spenceraxani/CosmicWatch-Desktop-Muon-Detector-v2/Pictures/Bottom view.jpg

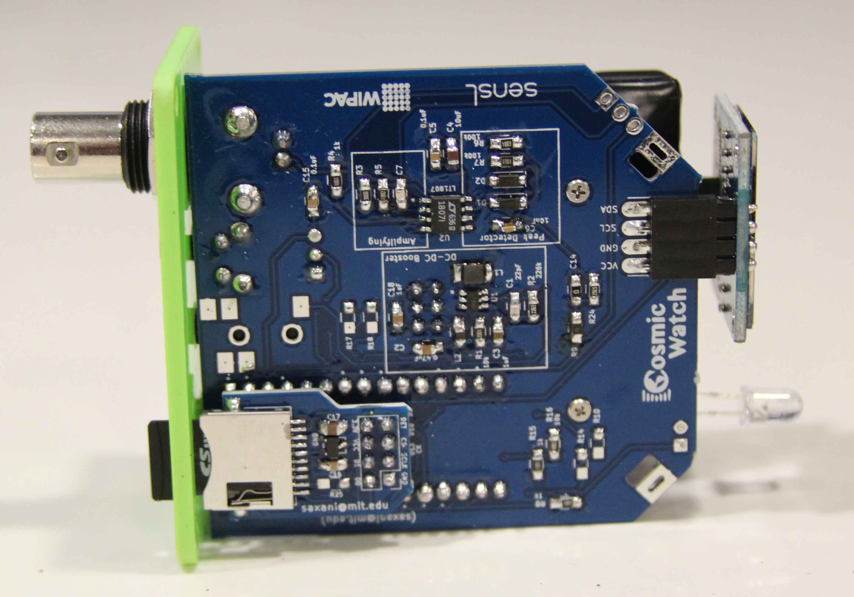
Pictures/Bottom view.jpg
