spenceraxani/CosmicWatch-Desktop-Muon-Detector-v2/Pictures/Detector.png

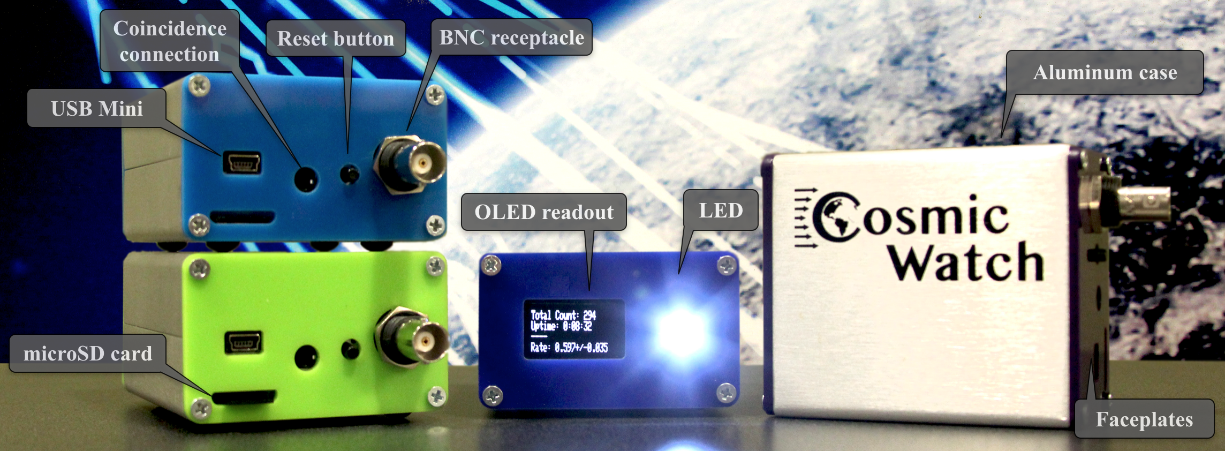
Pictures/Detector.png
