spenceraxani/CosmicWatch-Desktop-Muon-Detector-v2/README.md

-- OUTDATED --

CosmicWatch v2 is depracated and no longer supported. Please use v3X, the updated detector, found here:

[https://github.com/spenceraxani/CosmicWatch-Desktop-Muon-Detector-v3X]

Here are the previous v2 links:

Website: http://www.cosmicwatch.lns.mit.edu/

YouTube tutorial: https://www.youtube.com/watch?v=e4IXzNiNxgU

Paper: https://arxiv.org/abs/1801.03029

-- OUTDATED --
