spenceraxani/CosmicWatch-Desktop-Muon-Detector-v2/CAD/SiPM pins.png

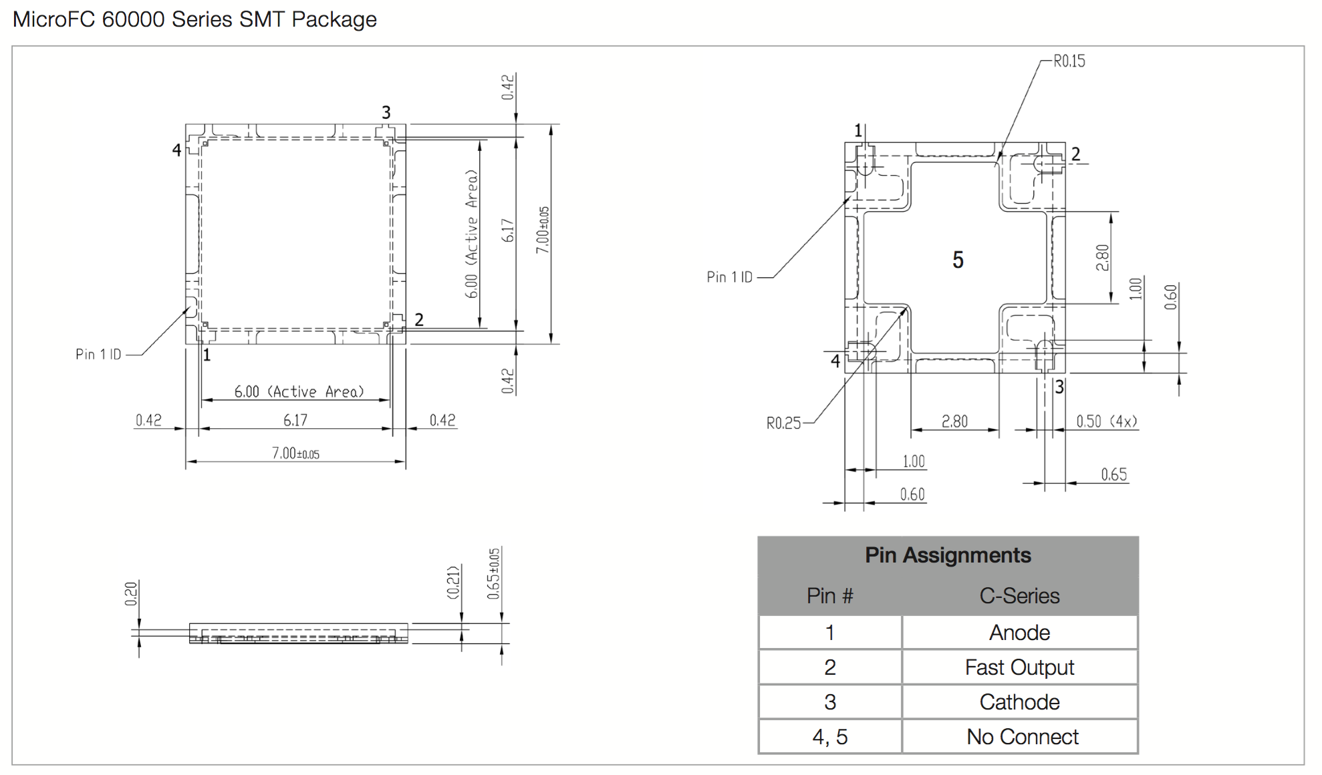
CAD/SiPM pins.png
