spenceraxani/CosmicWatch-Desktop-Muon-Detector-v2/Pictures/Front view.jpg

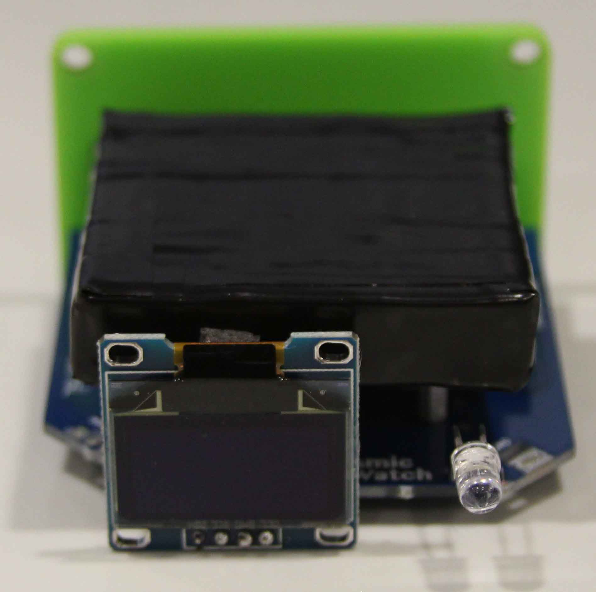
Pictures/Front view.jpg
