spenceraxani/CosmicWatch-Desktop-Muon-Detector-v2/Pictures/PCB Bottom.png

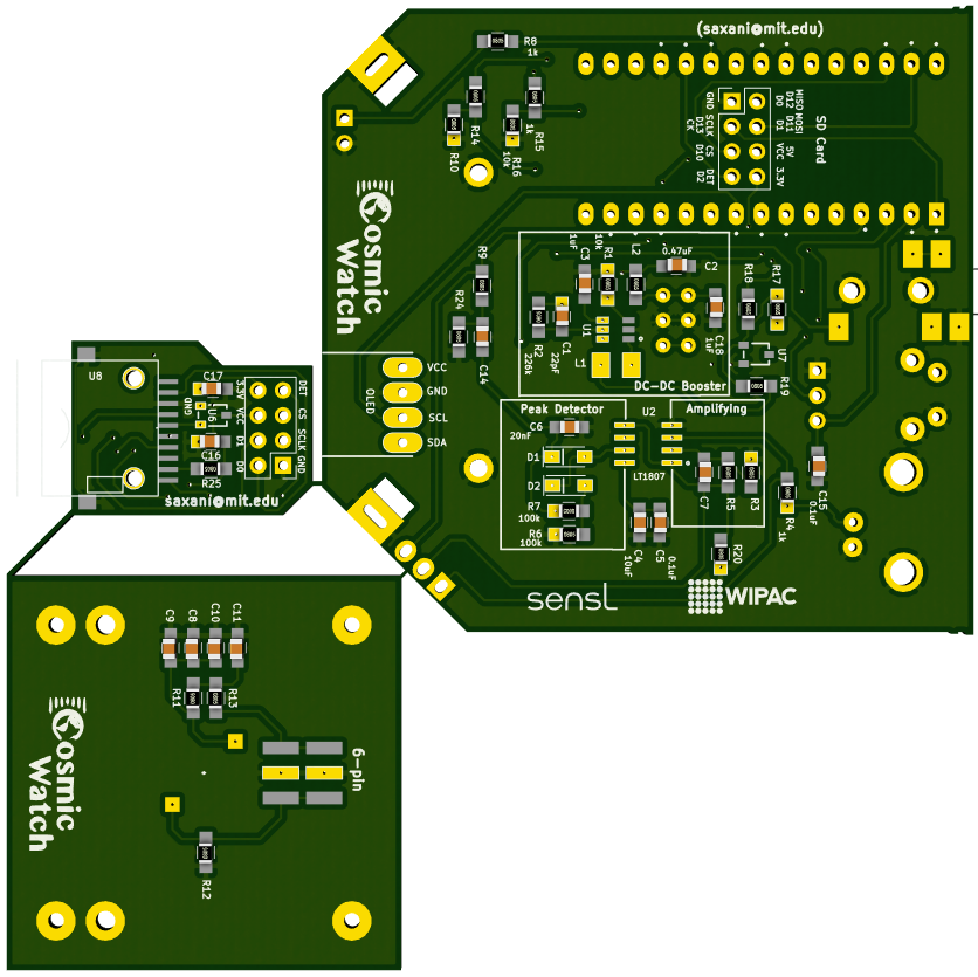
Pictures/PCB Bottom.png
