spenceraxani/CosmicWatch-Desktop-Muon-Detector-v2/Pictures/PCB Top.png

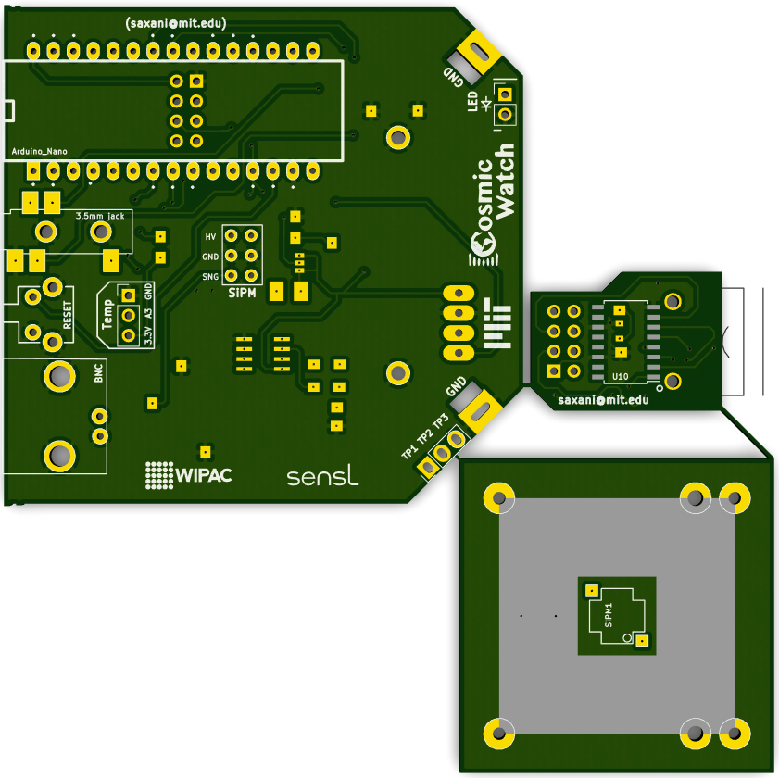
Pictures/PCB Top.png
