spenceraxani/CosmicWatch-Desktop-Muon-Detector-v2/Pictures/Side view.jpg

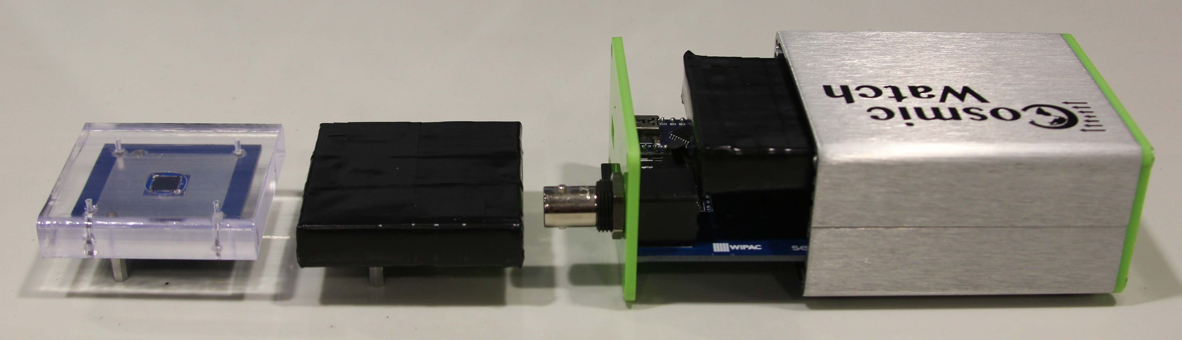
Pictures/Side view.jpg
