spenceraxani/CosmicWatch-Desktop-Muon-Detector-v2/Purchasing_List.xlsx

Note 1: The color defines the seller of the component. Components are rather generic, therefore you should be able to use your favorite distributor.
Note 2: We try and include a link in the form of the part number for each website
Note 3: We purhace our components in bulk (as required by several of the components). The price/unit was determined by purchasing 100 of each component. If you purchase a single unit, the price is probably ~200USD.
Note 4: The case is optional. It is cosmetic but helps protect the detector.
Note 5: We do not include shipping or taxes in our costs analysis.
Note 6: We've added one extra component to the required number of Resistors and Capacitors.
Note7: Ebay is often cheap than amazon. But the products change names regularly, so I won't include links to Ebay.
Note 8: Half of the OLED screens out there have VCC and GND reversed. We want an OLED screen with the VCC pin as the left most pin, not the second left-most pin.
Detector Purchasing List
Item | Name | Required number | Price/Unit * number | Discription | Link | Old link
1 | 0 Ohm resistor | 5 | $0.04 | RES SMD 0 OHM JUMPER 1/8W 0805 | Digikey Part Number: 311-0.0ARCT-ND
2 | 49.9 Ohm resistor | 4 | $0.04 | RES SMD 49.9 OHM 1% 1/8W 0805 | Digikey Part Number: 311-49.9CRCT-ND
3 | 249 Ohm resistor | 2 | $0.02 | RES SMD 249 OHM 1% 1/4W 0805 | Digikey Part Number: 311-249CRCT-ND
4 | 1K resistor | 4 | $0.04 | RES SMD 1K OHM 1% 1/8W 0805 | Digikey Part Number: 311-1.00KCRCT-ND
5 | 10k resistor | 5 | $0.04 | RES SMD 10K OHM 1% 1/8W 0805 | Digikey Part Number: RMCF0805FT10K0 | Digikey Part Number: 311-10.0KCRCT-ND
6 | 24.9k resistor | 2 | $0.02 | RES SMD 24.9K OHM 1% 1/8W 0805 | Digikey Part Number: RMCF0805FT24K9CT-ND
7 | 100k resistor | 3 | $0.03 | RES SMD 100K OHM 1% 1/8W 0805 | Digikey Part Number: RMCF0805JT100KTR-ND | Digikey Part Number: 311-100KCRCT-ND
8 | 226k resistor | 2 | $0.02 | RES SMD 226K OHM 1% 1/8W 0805 | Digikey Part Number: 311-226KCRCT-ND
9 | 10pF capacitor | 2 | $0.05 | CAP CER 10PF 50V C0G/NP0 0805 | Digikey Part Number: CML0805C0G100JT50V | Digikey Part Number: 1276-1109-1-ND
10 | 22pF capacitor | 2 | $0.05 | CAP CER 22PF 50V NP0 0805 | Digikey Part Number: 399-1113-1-ND
11 | 0.47uF capacitor | 2 | $0.22 | CAP CER 0.47UF 50V X7R 0805 | Digikey Part Number: 399-8100-1-ND
12 | 20 nF capacitor | 6 | $0.09 | CAP CER 20nF 50V X7R 0805 | Digikey Part Number: 478-10429-6-ND
13 | 0.1uF capacitor | 4 | $0.10 | CAP CER 0.1UF 50V X7R 0805 | Digikey Part Number: 1276-1007-2-ND | Digikey Part Number: 399-1170-1-ND
14 | 1uF capacitor | 3 | $0.11 | CAP CER 1UF 50V X7R 0805 | Digikey Part Number: 1276-6495-6-ND | Digikey Part Number: 1276-6470-1-ND
15 | 10nF capacitor | 4 | $0.03 | CAP CER 10000PF 100V X7R 0805 | Digikey Part Number: 1276-1249-1-ND
16 | 10uF capacitor | 3 | $0.12 | CAP CER 10UF 16V X5R 0805 | Digikey Part Number: 1276-1096-1-ND
17 | Feritte bead | 2 | $0.11 | FERRITE BEAD 2.5 KOHM 0805 1LN | Digikey Part Number: 535-ACML-0805-102-TTR-ND | Digikey Part Number: 587-1919-1-ND
18 | 47uH inductor | 1 | $0.22 | FIXED IND 47UH 170MA 1.3 OHM SMD | Digikey Part Number: 490-4063-1-ND
19 | Schottky diode | 2 | $0.33 | DIODE SCHOTTKY 40V 500MA SOD123 | Digikey Part Number: 641-1327-2-ND | Digikey Part Number: MBR0540CT-ND
20 | 4 pin header for OLED | 1 | $0.40 | CONN FEMALE 4POS .100" R/A TIN | Digikey part number: S5440-ND
21 | 6-pin connector | 1 | $0.41 | 6-pin connector for SiPM PCB | Digikey Part Number: WM17457-ND | Digikey Part Number: WM17457-ND
22 | 6pin header | 1 | $0.45 | 6-pin header for Main PCB | Digikey Part Number: 1212-1229-ND
23 | Reset button | 1 | $0.19 | SWITCH TACTILE SPST-NO 0.02A 15V | Digikey part number: PTS645VH83-2 LFS | Digikey part number: P12215S-ND
24 | 3.5mm coincidence jack | 1 | $0.89 | 3.5mm audio, 4 conductor connection jack | Digikey Part Number: CP-43515RSSJCT-ND
25 | BNC header + Nut | 1 | $1.67 | CONN BNC JACK R/A 50 OHM PCB | Digikey part number: WM5514-ND | Digikey part number: A97555-ND (old version WM5514-ND)
26 | 3.3 V regulator | 1 | $0.20 | IC REG LINEAR 3.3V 300MA SOT23-3 | Digikey part number: AP2138N-3.3TRG1DITR-ND | Digikey part number: AP2210N-3.3TRG1DICT-ND
27 | Standoff for SiPM PCB | 2 | $0.66 | 1/8" Hex Size, 7/16"" Length, 0-80 Thread Size | McMasterCarr part number: 91780A029
28 | Standoff threaded screws 0-80 | 4 | $0.36 | 0-80 Thread Size, 1/4" Long | McMasterCarr part number: 91771A055
29 | Plastic scintillator screws | 4 | $0.28 | 18-8 Stainless Steel, Number 0 Size, 5/16" Long | McMasterCarr part number: 92470A024
30 | LT-3461 DC-DC Booster | 1 | $2.00 | LT3461ES6#TRPBF | https://www.analog.com/en/products/lt3461a.html#product-samplebuy | Samples are free, or check digikey
31 | LT 1807 Op-Amp | 1 | $3.75 | LT1807IS8#PBF | https://www.analog.com/en/products/lt1807.html#product-samplebuy | Samples are free, or check digikey
32 | Non-Inverting Buffer | 1 | $0.25 | High Speed CMOS Logic Hex Non-Inverting Buffers | Digikey part Number: 296-9214-5-ND | Mouser Part Number: 595-CD74HC4050M96
33 | 5mm LED | 1 | $0.11 | 5mm LED, white looks best | https://www.amazon.com/Bluecell-White-Electronics-Ultra-Bright/dp/B005ONQ41W?s=hi
34 | Arduino Nano | 1 | $2.25 | ATmega328 CH340G | Check Ebay or Amazon (example https://www.amazon.com/ELEGOO-Arduino-ATmega328P-Without-Compatible/dp/B0713XK923
35 | Temperature sensor | 1 | $0.83 | TMP36 analog sensor | Check Ebay or Amazon (example: https://www.amazon.com/KOOKYE-Temperature-TMP36-Precision-Raspberry/dp/B01GH32AQU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 )
36 | microSD card socket | 1 | $0.39 | SMT SMD Cell Phone TF Micro SD Memory Card Slot Holder Sockets | https://www.amazon.com/uxcell-Phone-Memory-Holder-Sockets/dp/B01AHYS7K8
37 | OLED screen | 1 | $2.66 | 0.96" Inch I2c IIC OLED , 128x64 | Check Ebay or Amazon (example: https://www.amazon.com/Dorhea-Display-SSD1306-Self-Luminous-Raspberry/dp/B07FK8GB8T NOTE: VCC NEEDS TO BE THE 4th PIN ON THE OLED (on the left side), the left most pin is GND on half of the screens out there. SOME MANUFACTURERS SWAP THE PINS.
38 | SiPM | 1 | $29.00 | 6x6mm SiPM MicroFC-60035-SMT | Mouser part Number: 863-MFC60035SMTTR | Mouser part Number: 863-MFC60035SMTTR1
39 | Plastic scintillator | 1 | $30.00 | 5x5x1 cm Plastic scintillator | Ebay, or find your own. You want 5x5x1 cm3 and a peak emission at 420nm. (https://www.ebay.com/itm/Bicron-BC408-Plastic-Scintillator-5x5x1-cm-for-CosmicWatch-Muon-Detector-Project/263355405917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
40 | Main PCB + SiPM PCB | 1 | $0.95 | 2 layer, 10cm x 10cm, 1.6mm thickness | https://www.elecrow.com/pcb-manufacturing.html (https://www.elecrow.com/10pcs-2-layer-pcb.html)
 |  | Total: | $79.32
Enclosure Purchasing List
Item | Name | Required number | Price/Unit * number | Discription | Link
1 | Rubber feet | 4 | $0.05 | Silicon bumper for feet, 8x2 mm | https://www.ebay.com/itm/200PC-Self-Adhesive-Silicone-Feet-Bumpers-Stop-Clear-Cabinet-Door-Buffer-Pads-US/153282008606 (https://www.ebay.com/itm/200Pcs-Black-Silicone-Self-Adhesive-Rubber-Feet-Semicircle-Bumpers-Buffer-Pad)
2 | Aluminum Case | 1 | $9.28 | Aluminium case: 2506-2.9 | http://www.enclosuresandcasesinc.com/
3 | Front and back plate | 1 | $0.91 | 10cm x 15cm x 2.5mm acrylic end plates. | https://www.elecrow.com/acrylic-cutting.html
4 | 5mm LED holder | 1 | $0.15 | LED Light Mounting Holders | https://www.amazon.com/uxcell-Plastic-Holder-Light-emitting-Lighting/dp/B00K859CGK?s=hi
 |  | Total: | $10.38
Other potential purchases
Item | Name | Required number |  | Discription | Link
1 | Tin Foil or aluminum foil | 1 | $0.04 | 10x10cm of Aluminium foil for wrapping the Plastic scintilaltor | https://www.amazon.com/Reynolds-Wrap-Aluminum-Foil-Square/dp/B00UNT0Y2M
2 | Optical Gel | <1ml | $0.89 | Small amount of optical gel. Vaciline might work. | Check Ebay or Amazon (example: https://www.ebay.com/itm/Silicone-Optical-Coupling-Compound-for-PMT-Photomultiplier-Scintillator-Detector-/261918290249)
3 | Black electrical tap | ~1m | $0.22 | Black electrical tape for making the Plastic scintillator light-tight | https://www.amazon.com/Electrical-Tape-several-colors-Black/dp/B003ZWN5ZM
4 | microSD Card | 1 | $3.00 | We recommend 128Mb and above. | https://www.amazon.com/Lerdisk-Micro-SD-Card-4GB/dp/B09J9WTCG9
5 | Coincidence Cable | 1 | $4.00 | Short 3.5mm male to male audio cable. Either 3 or 4 conductor. | https://www.amazon.com/Riipoo-3-5mm-AUX-Audio-Cable/dp/B07429HJRJ?s=industrial | https://www.amazon.com/Seadream-4-Pole-Stereo-Headset-Extension/dp/B017PT8XX4
6 | BNC Cable | 1 | $5.96 | 3 feet BNC cable for testing. | https://www.amazon.com/Hosa-BNC-59-103-75-Ohm-Coax-Cable/dp/B000068OFB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
 |  | Total: | $14.12
 |  | Total: | $103.83
