spenceraxani/CosmicWatch-Desktop-Muon-Detector-v2/(threads)

Thread 1 (2018-01-28):

DC-DC Booster: LT3461 or LT3461A?

arrowM, 2018-01-28:
Hello,

I'm trying to determine which DC-DC booster to use from here: http://www.linear.com/samples/LT3461A

The purchasing list says to use the LT3461, but the instructions PDF says to use the LT3461A. These are two separate models with one slight difference: the LT3461 switches at 1.3 MHz while the LT3461A switches at 3 MHz.

Is there a specific one I should pick over the other, or would either work fine?

Thanks!

spenceraxani, 2018-01-28:
Hi,

I’ve used both in the past ad haven’t noticed a difference. On all my current builds though, I just stick to the 3MHz version, LT3461A.

Thanks,

Spencer

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

Thread 4 (2018-03-27):

BOM vs Populating reference and Partslist

metapulp, 2018-03-27:
Hi, I'm ordering from Elecrow and I have these issues:

1: The spreadsheet with part quantities does not match the quantities on the populating list. So basically from the quantity list they think they have more soldering to do than the populating list and pictures of the board show.
2: Elecrow is asking for a partlist generated from Autodesk Eagle - which I don't know how to do with the Gerber files. Do you have a DXF? Can you generate that partlist? Thank you.

spenceraxani, 2018-03-28:
Hi,

I’ve added an extra unit to the quantity in the purchasing list, since I noticed some people were just buying single resistors and then losing them.

The list to populate the boards is found in folder PCB_Files/SMT_reference. However, I do not have the BOM list for them to populate the boards. We use this project to teach students how to solder surface mount components.

The Gerber files (located here: PCB_Files/PCB_Gerber_files) contain the information required for Elecrow to simply make the PCB, not populate it.

Thanks,

Spencer

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

metapulp, 2018-03-28:
I understand. I’m also hiring Elecrow to populate most of the basic parts. Any chance you have the board(s) as a DXF and you could post it on github so I can generate the partlist file they are requesting? I’m not having any luck importing the Gerber in Eagle. Thanks!

metapulp, 2018-03-29:
Let me amend my comment. I'm trying to import files into Eagle with no luck, so I'm not seeing how to generate the partlist for Elecrow...

They are looking for something like this:
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

spenceraxani, 2018-03-29:
Hi,

I hope to generate the list at some point, but am unable to work on this at this time. I would recommend populating the components by hand for the moment being.

Thanks,

Spencer

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

Thread 5 (2018-04-30):

Missing marker on ARef pin

K-Raymond, 2018-04-30:
Hi Spencer,

I've just finished building two detectors and I noticed that there was no white-dot (which I assumed is to signify a used connection of that pin) on the ARef pin. This makes soldering the pins of the nano to the mainboard a little ambiguous and can result on a floating reference voltage. In my case, I had to debug why I was always measuring 1023 ADC units on A0.

I also wanted to say, thanks for making a fun little project!

-- Kurtis

spenceraxani, 2018-04-30:
Hi Kurtis,

You can solder all the pins on the Arduino to the board, but thanks for catching the missing dot. The dots were used to specify which pins I was using, but as the board developed, I stopped using them and must have missed this one.

Thanks,

Spencer

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

Thread 6 (2018-05-16):

HV to ground voltage measuring 33.6 volts. Recheck components in DC booster circuit. Is that acceptable since it exceeds the nominal 29.5 volts?

pedelen, 2018-05-16:

pedelen, 2018-05-16:
That was a great help. Loose connection on 226K resistor, now exactly 29.6 V output

pedelen, 2018-05-24:
Connected SiPM to 29.64  volts, but no counts. Arduino nano code rechecked. Don't have an oscilloscope to check test points. Checked SiPM resistance and is 10.5 megohms in one direction and infinite in the other. Should there  be a high count due to ambient photons? So if 0 count, maybe I should suspect the amplifier circuit?

spenceraxani, 2018-05-24:
Hi,

The most common problem I see is a missed or poor connection — particularly on the op-amp (90% of the time, it’s the opamp). I would start by adding new solder to those legs just to make sure. If you are able to upload code to the Arduino, I assume it’s probably working fine. You can also go through the other components on the board. I’ve also seen people mount the SiPM rotated (pin1 and 3 interchanged). If all this still doesn’t work, you’ll have to find an oscilloscope to nail down what part of the circuit is giving you problems.

You probably shouldn’t expose the SiPM to ambient light, but if you do, you still won’t see any counts. I think SiPMs have their own peculiar behavior with large amounts of light, but the circuit is designed to only be able to count below 1000Hz. We stretch to pulses to roughly one millisecond, and the Arduino will wait for a pulse to subside before looking for the next pulse.

Thanks,

Spencer

> On May 23, 2018, at 7:15 PM, pedelen <notifications@github.com> wrote:
>
>

pedelen, 2018-06-09:
Trying to track down problem. Each reset results in a count of 1 and then timer keeps going but no additional counts. Tried reloading sketch multiple times. Tried replacing SiPM and repopulating main PCB.

mmalluck, 2018-07-02:
Hello Pedelen,

Did you get your issue sorted? I have something similar happening with both of my V1 boards. 1 count and then nothing. If I leave them plugged in for a while, eventually they start counting. I found raising the "RESET_THRESHOLD" in the software to about 15 gets it counting immediately or just letting it warm-up for a 10 minutes and then resetting it.

My guess is there's some noise coupling into the circuit that settles out once everything warms up. USB power source doesn't seem to make a difference. If I can get some time in-front of an o'scope, I'll see if I can find the source.

pedelen, 2018-07-02:
Hello mmalluck,
Thank you for your help Spencer. Two v1 boards now working perfectly with original threshold settings. I am not sure what did the trick. I installed the standoffs, rewrapped the scintillator and used better optical coupling compound. Do the standoffs have any electrical function? The counts are now much closer to expected with better optical coupling (Rate ~ .55 cps).

mmalluck, 2018-07-02:
Do you mind me asking what you're using for optical coupling gel then vs now?

I'm currently using some silicone based '[scintilator coupling compound'](https://m.ebay.com/itm/Silicone-Optical-Coupling-Compound-for-PMT-Photomultiplier-Scintillator-Detector-/261918290249&ved=2ahUKEwiCkfCuh4HcAhUQvVkKHSSuCccQFjAAegQIBB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)off ebay and I'm wondering if it's contributing to this.

I'm looking at using some fiber optic gel instead.

spenceraxani, 2018-07-02:
Another potential source that could cause this problem is if you have a light leak. I typically wrap it in reflective foil, then put about 3 full layers of black electrical tape to make sure it’s isolated.

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

pedelen, 2018-07-02:
Hello mmalluck,
That is the exact same optical coupling compound that I am using now with good results. It appears that my issue was due to a light leak and it seems to be resolved now. I now realize I have been posting on the v2 thread about my issue with v1 boards.

Closed 2018-07-02.

Thread 7 (2018-06-09):

SiPM blue sensitive vs red sensitive

metapulp, 2018-06-09:
Hi, Spencer, what is the reason for selecting a blue-sensitive SiPM instead of a red-sensitive SiPM? (What nm range is the flash in the scintillator?) Thanks!

spenceraxani, 2018-06-09:
Hi,

The scintillator that we are using peaks at about 420nm, which is fairly close to the SiPM peak detection efficiency (around 450-550nm). Red-sensitive SiPMs are a slightly different technology that have a lower overall efficiency and are more suited for other applications, like measuring luminescence. SensL recently developed a new red-sensitive SiPM if you are interested: https://sensl.com/products/r-series/ <https://sensl.com/products/r-series/>. You can also see that the cost per square mm is also much higher than the SensL C-Series that we use.

Thanks,

Spencer

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

Thread 8 (2018-06-17):

Can't find Cap C6 - 20nF 50V

rogerio-acioli, 2018-06-17:
Hi,

I'm having problems to find the C6 capacitor (20nF - 50V) to buy at my country. Could I have some problem in the funcionallity of the detector if I use a 22nF capacitor instead the nominal 20nF?
Thanks!

spenceraxani, 2018-06-17:
Hi,

Sometimes capacitors are labelled in pF (20,000 pF) rather than nF which could be why you are having trouble finding the correct value. If you need to use the 22nF capacitor, I don’t anticipate you running into a problem. That capacitor determines the charge and decay rate of the peak detector pulse. If you swap it for 22nF, it will charge a bit slower and decay over a slightly longer time. This means that the calculated SiPM pulse amplitude will also slightly change (probably at the 10% level).

Thanks,

Spencer

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

samr28, 2018-06-17:
I also had a few problems with some of the parts being out of stock. The filter features on Digikey are super helpful. I was able to find replacements for all of the ones that were either out of stock or no longer in production by just entering the values into the filter. So for that one, I ended up purchasing 478-10429-1-ND.

From what I understand, the main things that you need to look at is the capacitance (20 nF), the size (0805 and overall dimensions should be similar to original). You should be able to go with a higher voltage without any problem as that value is just the voltage that should not be exceeded.

Hope this helps!

rogerio-acioli, 2018-06-19:
Thansk for the answers, guys!
Fortunatelly I finally found the capacitor here, but the informations that you sent are very important though.

Thanks,
Rogério.

Thread 9 (2018-06-19):

Stand-offs Too Short / Screws too long

mmalluck, 2018-06-19:
The Part List specifies 3/8" stand-offs for SiPM PCB. The interfacing screws are 1/4" in length. Using two of these screws results in a clash as both screws come in contact inside the stand-off.  The SiPM also droops. This can be corrected by using a slightly longer standoff.

spenceraxani, 2018-06-21:
Hi,

Thanks for the catch. I was using the 3/8” standoffs prior to this without trouble since there is also two 1.6mm PCBs in-between the standoffs and the 1/4” screws as well as the fact that they are tapered. Never-the-less a 7/16” standoff keeps the scintillator a bit more level and fits nicely so I’ve updated the GitHub purchasing list.

What do you mean by the ’SiPM droops’. Do you mean you are looking at the signal coupling? Droop is a rather small effect at the low intensity signals that we are looking at, but there is footprints on the PCB for AC coupling if you are concerned with the signal droop.

Thanks,

Spencer

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

spenceraxani, 2018-06-21:
Hi,

I see what you mean. There are spacers that you can purchase from McMaster if you want to make it more level — or going to 7/16” brings it really close.

The SiPM assembly is fully compatible with the newer version of the detector.

Thanks,

Spencer

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

Thread 10 (2018-06-27):

Flash too limited to allow OLED & SDCard

mmalluck, 2018-06-27:
It's possible to free up and additional 1.5k Flash by loading the latest Uno Bootloader onto the Nano. This may provide enough space to allow both the OLED and SDCard to operate together.

Reference: https://arduino.stackexchange.com/questions/51866/arduino-nano-atmega328p-bootloader-difference

With an update to the Nano bootloader, the good folks at Arduino neglected to reduce bootloader partition from 2Kb to 500b, as was done for the Uno. Loading the Uno bootloader onto the Nano provides this benefit. You just have to remember to identify the board as an Uno in the IDE.

If you have a sketch with both the OLED and SDCard functions active, you could see if it properly compiles for the Uno. If so, it would work for the modified Nano.

spenceraxani, 2018-06-27:
Hi,

That’s really neat, I’ll have to look into it.

My guess is that it frees up the space on the EEPROM, which won’t be particularly useful to us. We probably require about 10 kB of extra flash storage and about 1 kB of SRAM in order to run both the OLED screen and the SD card at the same time.

We actually only use the EEPROM to store the name of the detector.

Thanks,

Spencer

> On Jun 27, 2018, at 11:52 AM, mmalluck <notifications@github.com> wrote:
>
> u just have to

mmalluck, 2018-06-27:
Hello Spencer,

The 1.5k is indeed flash (not eeprom) space. I found another reference that
provides a how-to on uploading the Uno bootloader to the Nano, just to take
advantage of the extra program space.

http://www.buildlog.net/blog/2017/09/getting-more-program-space-on-an-arduino-nano/

As far as what's needed to run a combined OLED & SD implementation, a quick
mashup of the two sketches weighs in around 35k.... which is 3k more than
the modified nano or Uno could give us. And the ram is 116bytes over. Drat.

For fun I may try to see if this can be optimized.

Thanks,

Michael Malluck

On Wed, Jun 27, 2018, 2:21 PM Spencer N. Axani <notifications@github.com>
wrote:

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

spenceraxani, 2018-06-27:
There’s strange behavior with the Arduinos that don’t actually allow you to go above ~70% of either the maximum of the SDRAM or the Flash.

I bet there’s ways to optimize either the OLED library or the SD Library to make them work. I’ve tried my best to optimize the Arduino code, but I’m sure there’s always places for improvement.

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

mmalluck, 2018-06-29:
Hello,

That's funny. I was playing with the SSD1306 library this afternoon too.
While it does save a bunch of ram and considerable flash, the execution
time is pretty poor.

I just have the V1 hardware at the moment so working with older sketch,
baselining the 'downtime' with adafruit_SSD1306 library comes in around 3%
of the total execution cycle. The SSD1306ascii comes around 12%.

So the ascii library takes 4 times longer to execute than the adafruit. I
guess there's no such thing as a free lunch; You can be space efficent or
execution efficient. Is this acceptable? I guess that depends on what you
want.

I might start looking at the u8g2 libraries next.

Regards,
Michael

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

jgOhYeah, 2018-06-29:
I just checked one of the files logged to the sd card and the dead time is around 43% of the total time after 25 hours running. Might have to speed it up slightly somehow. I am investigating other libraries which may be a compromise between the two.
This might be one of the reasons why the detector I built does not always seem to be behaving properly :)

mmalluck, 2018-06-29:
Considering you can pack all the code into a single sketch, you could take some unused I/O pins and a switch and let the operator decide what he wants to run in software; Serial / OLED & Serial / SD & Serial / OLED & SD & Serial. This way you don't need to upload three different sets of code and the user can determine what kind of performance vs features he wants.

jgOhYeah, 2018-07-07:
I have swapped to the u8x8 library for driving the display, which is a part of the u8g2 library and is text only. It seems to be fairly fast and not use that much memory. For those interested I have attached a spreadsheet of tests I have done comparing a few libraries. The results seem to match up with Michael's measurements for dead time.
[SSD1306Libraries.xlsx](https://github.com/spenceraxani/CosmicWatch-Desktop-Muon-Detector-v2/files/2172657/SSD1306Libraries.xlsx)
Dead time seams to be around 5% of the total time now with both the screen on, logging to serial and the sd card.
Here it is: https://github.com/jgOhYeah/NonOfficial-StuffForCosmicWatchMuonDetectors

By the way, the reason why I measured 40% dead time for the SSD1306ascii library was probably because I put a bracket in the wrong place and it was probably trying to do adc readings on the wrong pin. :)

spenceraxani, 2018-07-07:
Great stuff. I’ve tried that library before and couldn’t get it working. We’ll upload your code today to test it out. Great comparison in the excel spreadsheet by the way.

Thanks,

Spencer

> On Jul 7, 2018, at 5:58 AM, jgOhYeah <notifications@github.com> wrote:
>
> text

mmalluck, 2019-04-25:
I just wanted to provide an update. I managed to get both OLED and SDcard functions working within the same software set. I had to swap out the adafruit library for the SSD1306Ascii  library, make a few modifications to the display calls and cludge-in the existing SD card functions. My code is not pretty, but works as a proof of concept.

It uses 97% of the program memory and 65% of the dynamic memory. Not much more could be squeezed out. Feel free to use my proof of concept code however you would like. I'm just happy helping out the project.

[Cosmic_Watch_V2_Comb_Simp_Disp.zip](https://github.com/spenceraxani/CosmicWatch-Desktop-Muon-Detector-v2/files/3116911/Cosmic_Watch_V2_Comb_Simp_Disp.zip)

spenceraxani, 2019-04-25:
Hi,

Haha, thanks for working on squeezing both pieces of code onto the Arduino. You are really hitting the limits of the Arduino Nano with your code. The dynamic memory was often an issue for us, since issues can arise when this increases beyond about 70%.

Glad to hear you got it working though. I’ll try to test it out soon and see if I have any useful comments.

Thanks,

Spencer

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

mmalluck, 2019-04-25:
Sounds good. I should mention upon the first upload you may have some garbage displayed on the OLED that will persist until all power is removed. It has something to do with the OLED not liking seeing the libraries swapped out.

jgOhYeah, 2019-04-26:
Hello, Good job on modifying the code and getting it to work.
I eventually gave up on the library for this job myself because I thought it was just too slow, but obviously not :).

I also wrote a version that has been running on my physics teacher's detectors for a few months, but I forgot to upload the latest version until now. Sorry for the slight delay.
It should be here [https://github.com/jgOhYeah/NonOfficial-StuffForCosmicWatchMuonDetectors](https://github.com/jgOhYeah/NonOfficial-StuffForCosmicWatchMuonDetectors).

I used the u8x8 library, which is much more limited in terms of fonts and font sizes, but is fast and does not use much memory, as well as being versatile enough to make something readable. If it is possibly to use a slightly nicer looking, low memory, high speed library, that is good to know :).

Last time I checked, the dead time for this code with display and sd card was about 8%. I am not sure if this good enough, but it seems to work. This code uses 91% of the program memory and 65% of the ram, so it seems that no matter the libraries or code used, it is always going to be tight squeezing in and sd card and display.

There was somehow enough room left that I managed to put in a module that can burn the detector's name and a few other settings into the EEPROM without having to upload a different piece of code to it.

I have read that with the ram in arduinos, it is often better to use char arrays instead of the String class as the String class can waste memory, eventually running out and causing the arduino to crash. I found an interesting article on it [here](https://hackingmajenkoblog.wordpress.com/2016/02/04/the-evils-of-arduino-strings/). Maybe with stuff like this in mind it would be possible to successfully go above the 70% dynamic memory suggested limit if needed?

mmalluck, 2019-04-26:
Hello jgOhYeah,

Your code is so pretty, polished, and well commented. Mine was just a kludge to see if the concept would work. I'm pretty sure I broke all of the external tools as my print statements / orders differ from what the external tool expects, but nothing that couldn't be fixed.

SSD1306Ascii library is pretty good as it's written to be very low memory and they have a number of fonts to choose from. The arial14 font I chose is pretty nice looking and has the same character sizing as the adafruit library.

With regards to string and ram, I saw a similar article that discussed how the arduino compiler will allocate ram for any strings because it operated under the notion that they may be dynamically manipulated elsewhere in the code. This can be very wasteful if your using a bunch of static strings, like we do here. I like how you used char arrays to keep the ram usage down, but there's actually a built in function in the arduino IDE that can help with a little less effort. It's a function call F(). By defining your string inside this wrapper function, the string will get statically allocated in program memory and not ram. That's how I kept my ram usage down. You can even use it with normal string operations for example Serial.println( F("Your string here") + F("Your other string") + somenumber );

It would be interesting to see if how the char array method and the F() compare against each other with regards to ram and cpu usage.

jgOhYeah, 2019-04-26:
Semi-organised code and extra features are mainly a result of trying to avoid homework :) Although it often starts out with comments and nicely layed out, it often ends up very messy with very out of date comments making little sense :)

I have not done any tests speed wise, but I would have it a guess that the F() macro is doing something similar to the strcpy_P in the background in that it copies strings saved into flash into char arrays, but does it automatically. Probably the fastest is the `Serial.println("text")` without anything to save memory as the string is already in ram.

In another project I have been using the F() macro and it makes it much easier to follow, however in this code I wanted to write identical strings to up to 3 separate things (serial, display and sd card) using the least amount of memory possible.

I ran a small test comparing memory usage of different ways of saving and then printing a string out twice and found that the F() macro saves the string into flash memory twice, even if both strings are identical. This surprises me, because I would have thought the compiler would optimise this, but evidently not.

By using strcpy_P, the string can be saved into flash and then only copied into a char array only when required, allowing a string to be used multiple times if required, although it is very manual to set up. It does also allow char arrays to be manually manipulated and reused, as well as a scratchpad for processing hopefully without having to allocate more memory.

Once I started with this system, I decided to keep going with it as to have all UI text on the one file, even if strings are only used once for consistency. Not sure if this is the best way to do it, but that's what I did.

[StringMemTest.zip](https://github.com/spenceraxani/CosmicWatch-Desktop-Muon-Detector-v2/files/3120685/StringMemTest.zip).

As for the compatibility with the existing python scripts programs, that only happened much later in the version I did and as of now I still have not got round to implementing the reading and deleting files from the sd card bit. A work in progress :)

jgOhYeah, 2019-08-13:
A slight update to my version of the code:

I only recently noticed that in February 2019 there was an update (v2.25.10) to the U8x8 library that claims it should be around 4% faster ([see near the bottom here](https://github.com/olikraus/u8g2/blob/2ce3043cf43ab1c47de85f5a06b55eaf93700aff/ChangeLog)). I have not tested this in this application, however I was playing around with drawing images on the screens and ended up with a graphical bar graph and scale instead of the hyphen one. It ranges from 0 to 180mV and each division should be around 20mV (off by a bit due to rounding to fit inside 120px wide).

Interestingly, early testing suggested that loading the top image background from flash into ram, overlaying the bar on top of it at the right length and then displaying it somehow takes around 1/3 the time it does for my adaptation of the hyphenated version. Not really sure why as I thought that the hyphenated version would have been more efficient, might be something to do with how the library handles characters in the background?

On the other hand all of these do not seem to have major effects (fractions of a % only) with dead times of:
* 4.6% old (v2.2) for 24 hours in slave mode with a rate of 0.121c/s (not 100% sure which version of U8x8, probably pre v2.25.10)
* 4.1% new (v2.3.2) for around 17.5 hours in slave mode with a rate of 0.138c/s (U8x8 v2.26.14)

I have updated the non-official repository with the latest version.
Good luck with your muon detecting :)

spenceraxani, 2019-08-13:
Hi,

Thanks for the update about the library.

Spencer

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

Thread 11 (2018-06-29):

Employing a regulated 5v source

mmalluck, 2018-06-29:
Just a suggestion for V3 hardware: As the quality of power delivered via USB can vary substantially between different sources (5.25v to 4.4v allowable), I would recommend using the Nano's 5v regulator to source 5v to the rest of the board. The on-board regulator is capable of sourcing 800ma @ 5v, so this should be plenty for the other equipment. By doing this it should help cut down on any noise coupled into circuit from the USB power supply as well as give you more consistant 5v rail making the results between different people's equipment more comparable.

This would involve bringing back the power jack and connecting it to the Nano's Vin and ground pins. You just need to supply the jack with 6-12vdc there after. Given the simplicity of this mod, I'm planning on employing it on my V2 equipment once I get my parts together.

spenceraxani, 2018-06-29:
I’ve also read that the USB power can vary between that range but have never measured it to vary more than roughly 1% from a handful of different computers. I’m wondering if that range of voltages is an old figure. Earlier versions used the 5V regulator and required a DC power supply, however, we found that we always ended up simply using the USB ports anyways. Removing the DC barrels jack gave us room on the PCB to put in the coincidence connection, which was much more useful for making actual measurements. I guess it depends on what you want to measure — if you are interested more in photon counting, then this is one of a few upgrades that would help.

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

mmalluck, 2018-06-29:
I think the problem comes more into play with USB battery packs and wallworts than computer USB ports. The computer should have very uniform, clean, DC, as it's the same source provided to the other computer components. USB power packs and batteries, on the other hand, will have varying degrees of voltage and noise.  Checkout some of the comparisons between Apple USB plugs and the knock-offs. The difference in ripple current alone is surprising.

You could still use power from a USB source, but if you wanted to go that route, I would recommend using a boost/buck converter to ensure you get a nice clean isolated 5v source no matter what how you power it. If I were going to do that, I'd change out the Arduino to something like a [Pro Mini](https://www.sparkfun.com/products/11113) as the USB port wouldn't be needed at the Arduino and more or perhaps just start including the ATmega328 on the main board, no discrete Arduino needed.

There's no reason to use up valuable PCB real-estate for a power jack. As far as my simple mod is concerned, a panel jack and a couple of wires should be able to be shoehorned into the chassis without too much fuss, at least that's what I'm going to try.

I have a another question, why no decoupling capacitors near the op amps? In school it was drilled into my head that you should provide decoupling caps on the power lines of each of your ICs.

Thread 12 (2018-07-05):

Scintillator Size

lelipwn, 2018-07-05:
Hello Spencer,

In another issue post, you commented that the 1cm thinkness for the scintillator was chossen so that it would be easier to calibrate the detector to muons and not other background radiation.

I happen to have however a 2.75cm * 2.75cm * 10cm plastic scintillator with both ends crystal clear (it's either a BC408 or BC412 not really sure).

Shoud I just stick the SiPM in one end and wrap the whole thing to have a gamma + muon detector? Or should I cut a 2.75cm * 2.75cm *1 cm slab?

Thank you making this awesome project,

L

spenceraxani, 2018-07-06:
Hi,

The electronics were developed for a 50x50x10mm^3 slab of scintillator, but it should work fine with the one you quote. You will see more light on average per event (since the SiPM covers a larger relative surface area), which means you will saturate the electronics more easily. If you are simply looking for counting purposes though, it should work fine. Keep in mind that your count rate will also be about 1/3rd that of our detector.

Thanks,

Spencer

> On Jul 5, 2018, at 5:20 PM, lelipwn <notifications@github.com> wrote:
>
> M

lelipwn, 2018-07-06:
Hi,

I'm sorry, I don't understand. If I were to use the 27.5mm * 27.5mm *100mm why would the count rate be 1/3 considering the surface area is pratically double of the original one.

On the other hand if I used a 27.5mm * 27.5mm * 50mm the surface area is pratically the same as the original, would that be preferebly in order to not saturate the SiPM?

I'm just worried it will saturate and not be at all accurate.

Thanks for everything,

L

spenceraxani, 2018-07-06:
Sorry, my answer was for cutting the scintillator to 27.5 x 27.5 x 10 mm^3. This would reduce the area by about a factor of 3.

Your first issue might be mounting the PCB onto the scintillator, since the holes mounting holes are 30mm apart. If you use a thicker slab of scintillator, it also will not fit into the enclosure (which is fine). If you keep it at 100mm, then interactions at the edges might not trigger the detector — but that’s just speculation.

My recommendation would probably be to use the 27.5 x 27.5 x 50 mm^3, to see what it looks like. I think it will probably be fine, you’ll probably end up with more light per event, but fewer events (since the downing muons will still only see 27.5 x 50 mm^2. This then gives you two pieces of scintillator if you plan on building another detector, and also allows you to cut it down to 27.5 x 27.5 x 10mm^3 if you chose.

Spencer

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

Thread 13 (2018-07-11):

Solder preference

metapulp, 2018-07-11:
Hi, Spencer, do you use lead-free or tin-lead solder? Thanks!

spenceraxani, 2018-07-11:
Hi,

I personally like using 0.031”, 63% tin and 37% lead solder.

Here’s a link to the solder that I purchase:

https://www.amazon.com/Kester-24-6337-0027-Solder-Alloy-Diameter/dp/B0149K4JTY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 <https://www.amazon.com/Kester-24-6337-0027-Solder-Alloy-Diameter/dp/B0149K4JTY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>

Thanks,

Spencer

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

mmalluck, 2018-07-20:
I've been using a lead-free solder paste (95.5Sn/4.0Ag/0.5Cu) and a DIY reflow oven for the 5 boards I've put together. It works pretty well.

A word of caution if using a reflow oven:
Components like the SiPM may raise off the board slightly during the solder process and 'float' on the solder. While normally this isn't a big deal, the SiPM board only provides solder pads in two corners of the SiPM, so the SiPM may lift off the board ever so slightly an at an uneven tilt. This leaves the SiPM vulnerable to being damaged when the scintillator is installed.

I didn't notice that this happened and managed to crack one of my SiPMs (ouch!), but lesson learned.

Either hand soldering the SiPM or having all 4 pads on the SiPM PCB would help avoid this.

Thread 14 (2018-07-14):

Polished vs unpolished scintillators

jgOhYeah, 2018-07-14:
Hello,
A quick question on the performance difference between polished and unpolished scintillators.

I have built two detectors. I was not quite game enough to begin with to heat polish the scintillators, so I left the surfaces as they were (one side glass like, the others slightly rougher and opaque, with the SiPM attached to the glass like side). Both registered around 1.5 counts per second.

Later, I had to take one of the sensors apart to fix a dry solder joint on the SiPM. While I was at it, I had a go at heat polishing the scintillator using a gas soldering iron with the tip removed, practicing on a bit of old acrylic first and being very careful not to burn the scintillator. This sensor now reads at around 0.6 counts per second. This seems to be the opposite as I expected, although now more in line with what the website suggests as a standard count rate.

The scintillators are made from Bicron 408 plastic according to the listing that I got them from and the instructions that came with them seemed to suggest that performance was better with them unpolished, although the instructions mainly seemed to focus on round scintillators attached to photo multiplier tubes, as opposed to square scintillators attached to solid state sensors with screws.

My question is: Is this difference in performance expected or have I made another dry solder joint or some other error somewhere and if there is, why?
Thankyou very much.

spenceraxani, 2018-07-15:
Hi,

The heat treatment was just to make the edges smooth and transparent to help with both the total internal reflection and the reflection from the aluminum foil. Typically with this versions of the detector, it’s not uncommon to see ranges varying from 0.8cps to 1.5cps depending on where you are located. This is due to the radioactive background of where you are located.

If you made the measurement at the same location, I would be surprised with that large of a change. 1.5cps is typically on the higher side, and I wonder if there could have been a small light leak? 0.6cps is on the low side as well, but not unreasonable depending on how well the SiPM is coupled to the scintillator, the surface finish, and so on.

I would have expected the count rate to be slightly higher with an improved surface finish. The best way to look for problems is to have a look at the test point connections.

Hope this helps.

Thanks,

Spencer

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

jgOhYeah, 2018-07-17:
Thanks for the suggestions. I will look into them and the test points a bit more when I can get access to an oscilloscope.
The detectors were both in the same location at the same time when the measurements were taken (once in Melbourne and a few times in the Adelaide Hills on holidays). I have managed to get the detectors to work in coincidence mode and the slave unit registers a count rate of around 0.2 in the Adelaide hills. I might try re wrapping one of the sensors to see if that helps.

spenceraxani, 2018-07-17:
Hi,

0.2cps sounds very reasonable for the detector set in slave mode sitting next to the master.

Thanks,

Spencer

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

Closed 2018-07-29.

Thread 15 (2018-07-19):

Test Connections

lelipwn, 2018-07-19:
Hello,

My detector is trigering at about a 0.126 cps which I know is pretty low. I am having problems determining the problem. Now I know that my scintillator isn't exactly to size with yours, being 3cm * 10cm * 1 cm so maybe that's why ( [Here](https://youtu.be/1XXfAtaSklA) is a short video of the 3 test connections. The initial change is me having trouble attaching the leads of the osciloscope, not the voltage jumping arround. While I'm seeing count rates of about 0.095 cps I am unable to see the peaks in the osciloscope. It's a cheap usb one, so maybe that's why.

I did all the testing provided in the FAQ, my SiPM is reciving 29.5 Volts, and it does have the correct polarity. I am pretty sure it isn't random noise as it is pretty consistent, giving 0.095 cps in a period of 5 hours.

I don't know, if you think this numers are correct factoring the change in scintilator I'm fine with it, it just seems on the very low end.

`SIGNAL_THRESHOLD = 10`

`RESET_THRESHOLD = 15`

`LED_BRIGHTNESS = 255`

Thank's for all,

L

spenceraxani, 2018-07-19:
Hi L,

I would also start by raising the SIGNAL_THRESHOLD. A value of 10 is pretty low. Try bringing it up to 30-50 or so.  It could be that you are sitting below a small DC offset and the detector rarely resets (ie. the waveform has to dip below the SIGNAL_RESET value before it begins looking for another pulse).

I think your next best bet would be to find an oscilloscope (the one you have might not be fast enough — probably something around 10+MHz would be fine, which might be close to your USB scope.) I have a hard time understanding what I’m looking at in the video you sent. Are you able to set the trigger on the USB scope? It looks like it’s just continuously running.

Since you have 29.5V, you need to make sure your SiPM is seeing something. You’ll have to check the signal on the BNC connection first. These are the raw SiPM pulses, and should be 10-100mV with a decay time of roughly 500ns. Once that is working, then moving onto the other test point connections will help diagnose the rest of the circuit.

Thanks,

Spencer

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

lelipwn, 2018-07-22:
Thanks for your help,

I will wait till september when I have acces to a nice oscilloscope meanwhile, is it possible this isn't working right because I used plastic standoffs? Are they neccesary to complete the circuit between the SiPM PCB and the main PCB?

Thanks again,

L

spenceraxani, 2018-07-22:
Hi,

Plastic standoffs will work fine. Two of the connections in the 2x3 header are for the ground.

Thanks,

Spencer

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

lelipwn, 2018-07-22:
Hello,

I'm tring to find this information online but I'm not having any luck. How far does the SiPM "see" into the scintilator.  I found a nice article that compared angles of incidence, but nothing on how far a photon can triger "into" the scintilator and still be captured by the SiPM.

I re-wrapped and repolished my scintillator and this is the result. There has been an increase in the count rate, now is 0.218. I'm thinking all of this is just bad scintillator size, I will try to see if I can find the correct one.

Thanks,

L

Thread 16 (2018-07-21):

0.4 V from DC-DC booster circuit to SiPM

Pappy85, 2018-07-21:
I've built two boards with the same issue, there is 0.4 V coming out of the DC-DC booster for the SiPM instead of 29.5 V. I've checked each component in the booster circuit, including the connections on the LT-3461, and everything seems right. Has anyone seen this problem before? Any help diagnosing this problem is appreciated. Thanks!

Pappy85, 2018-07-21:
Of course - picture attached. Thanks for taking the time to look at it.

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

spenceraxani, 2018-07-21:
Hi,

It looks like the components are in the correct place, and the orientation is correct. But, I it does look like you might have some poor connections (for example: the top middle pin in the 6-pin header looks like it’s not soldered to the board, and maybe also the LED connection to the Arduino pin D3, maybe the top of R6). This makes me think that there could be a poor connection on the DC-DC booster as well.

Could you start by melting and re-solidifying the solder on the booster legs? Just to make sure that each one of those connections is properly soldered to the PCB?

It’s not obvious, but there could be a short between the two top right pins of the DC booster IC as well.

Since you aren’t seeing the correct voltage, the problem must be coming from within the DC-DC booster silkscreen outline.

Thanks,

Spencer

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

Pappy85, 2018-08-14:
Sorry for the delay responding, I was slowly working though various issues on the board. You were right that it was the solder joints on the DC-DC booster. I subsequently found some issues on the LT1807 legs as well. But after some persistence I got the system running and am counting muons.

Thanks for the feedback here, as well as the youtube videos and instructions. I'm happily enjoying the detector.

FYI - I don't know what others have found, but in my case, without access to physics department materials and a reason to buy in components in bulk, my completed system cost as least twice the quoted price of $100/detector. I only mention it as a fair warning to others considering building one. I think it was worth the cost though.

spenceraxani, 2018-08-17:
Hi,

Glad to hear you got it working.

The price is broken down in the Purchasing_List.exel spread sheet. We use this projects for teaching applications more so than for individual people. We build the detectors for sub-100$, but that’s typically in bulk for classes and outreach programs. If purchasing single components, the price does increase.

Thanks,

Spencer

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

Closed 2018-08-14.

Thread 17 (2018-07-23):

Testing SiPM prior to scintillator wrap

metapulp, 2018-07-23:
Hi, Spencer, I am seeking to test the SiPM prior to wrapping it up with the scintillator. The basic tests with the voltage meter work fine. I placed the SiPM in a black box in a dark room and ran jumpers to the 6 pin connector then allowed light (ambient) to enter the box through a hole. The OLED/LED did not register any additional event. Is it possible to register an event without the scintillator - possibly by adjusting the threshold? And could you let me know what the threshold of 20 is equivalent to?

Also, since we are only using anode and cathode on the SiPM, I'm not able to grasp how the current flows through the female 6 pin on the board. Per the circuit diagram, the 6 look like they are mirrored 3 pin columns. I also bought one of SensL's SMTs and am unable to figure out how to connect it to the 6 pin.

Thank you as always!

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

spenceraxani, 2018-07-23:
Hi,

I doubt you will be able to test the SiPM like you wrote in your description. These are single photon detectors, and allowing this minuscule amount of random light through a hole in a box will be very unlikely to trigger the detector. A signal will be generated in the detector if 10s of photons arrive within nanoseconds of each other, and then no photons around that bunch. You really need a fast artificial light source if you want to test it. If you want to do this, you can flash a dim LED light in the box.

The instruction.pdf document has the conversion from ADC to mV in Fig. 10. It looks like 20ADC counts is about 10.5mV.

The 6-pin connector is redundantly connected, so we only use three of the pins. I figured that a 3x2 was more structurally secure, and the redundant pins meant that if a pin broke, you’d still have the other one. The three pins are for the biasing voltage (pin 3 of the SiPM), the signal out (pin 1), and a ground (on the board).

Thanks,

Spencer

> On Jul 23, 2018, at 6:31 AM, metapulp <notifications@github.com> wrote:
>
> he SiPM prior to wrapping it up with the scintillator. The basic tests with the voltage meter work fine. I placed the SiPM in a black box in a dark room and ran jumpers to the 6 pin connector then allowed light (ambient) to enter the box through a ho

Thread 18 (2018-08-16):

Measured voltage is negative.

Lifesaver31300, 2018-08-16:
Hi Spencer,

When I connect to a scope, I am reading negative pulses. I cannot identify where I went wrong. Is there a way I can change the code to correct this? I tried making my threshold and resets negative, as well as flipping the inequalities, but it did not count. What do you suggest?

spenceraxani, 2018-08-17:
Hi,

That’s a new one to me. We’ll have to back up test a few things. When you measure the voltage on the 2x3 pin header between HV and GND, do you see 29.5V? Are the pulses that you see the correct shape? ie. ns rise time, amplitude 10-100mV, and decay time of ~500ns? Are you sure that you mounted the SiPM in the correct orientation?

Thanks,

Spencer

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

Thread 20 (2018-09-03):

SiPM/Scintillator failure then success

metapulp, 2018-09-03:
My detector was not functioning properly, and I decided the issue was likely the scintillator or SiPM or both. While unwrapping the scintillator, the SiPM became loose, and I was concerned an edge was crushed. Having the SiPM pressed up against the scintillator concerned me, so to cushion them I bought neoprene washers (90133A005) from McMaster Carr. 0.12" ID, 0.25" OD.

I had originally hand drilled the 4 holes before hand wet-sanding the scintillator using 600 to 2500 grit wet sandpaper and regular white ink-jet paper, but the second time around I touched the scintillator up with cotton flannel and the Novus system per these instructions: [https://eljentechnology.com/images/technical_library/Plastic_Polishing.pdf](url). This really contributed to the clarity. Spencer states elsewhere that all machining must be done before heat polishing. There are any number of materials that will fracture if drilled into at high-speed, so slow speed drilling while keeping the material cooled with water is what I typically do.

After a careful rewrap - wrapping the tinfoil like a miniature present and adding a second layer, I put optical gel on the SiPM and carefully screwed the SiPM PCB to the scintillator. I sighted the gap between the surface of the scintillator and the SiPM PCB to make sure I wasn't crushing the SiPM.

I rewrapped the scintillator with electrical tape.

I also added the neoprene washers to the short standoffs also.

This time everything works great. Photos added in case anyone else needs to use this approach.

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

spenceraxani, 2018-09-07:
Hi,

Thanks for the photos. I’ve also found that using a 1/32” silicone rubber sheet works well for a spacer around the SiPM (see for example: 86045K67 from McMaster-Carr).

Thanks,

Spencer

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

jimgallatin, 2018-12-04:
I used two layers of tinfoil and a layer of tape on the scintillator.  Since we are talking about 1/32” of cushion, would it make sense in your experiencefor me to simply loosen the four screws a bit to achieve that gap?

jimgallatin, 2018-12-04:
Also, as long as it is not crushed or damages is there any reason why the SiPM shouldn’t touch the scintillator through the gel?

spenceraxani, 2018-12-06:
Hi,

The face of the SiPM is fine touching the scintillator, but you don’t want to put too much pressure on it. Normally, I leave a small gap between the SiPM PCB and the scintillator, or I put a 1/32” silicon rubber sheet to give it the correct spacing.

Hope this helps.

Thanks,

Spencer

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

Thread 21 (2018-09-05):

Problems with uploading to arduino and counting muons

rbaker314, 2018-09-05:
When the arduino is connected to the cosmic board I cannot connect the arduino to my computer to change the code. There is no USB recognized.  When I disconnect the Nano from the board, it connects fine. Is this normal? I have uploaded the software with the Nano off the board and then added it to the board but I get no counts. All of the voltage tests are good.

When the power is connected to the arduino the oled shows the Cosmic Watch logo and the clock advances every second but the count does not change after counting once. I changed the const_threshold from 20 to 15 but no change.

Not sure what to do.

Thank you,
Robert Baker

rbaker314, 2018-09-06:
You mention in the Youtube video that two of the Arduino Nano pins do not need to be connected. Do those pins need to be cut?

spenceraxani, 2018-09-07:
Hi,

There are several pins on the Arduino that aren’t used at all, and they can just be left unconnected if you like. Connecting them doesn’t hurt though.

Thanks,

Spencer

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

jgOhYeah, 2018-09-08:
On one of the detectors I built, I had a similar problem where the arduino connected to the computer off the muon detector board but only connected sometimes after I had soldered it to the board. I used some cheap clone arduinos and I think that maybe there was a dry joint on or around the data lines in the builtin usb connector or the usb serial converter chip on one of them. I retouched the joints around the connector and it can connect to the computer now.

spenceraxani, 2018-09-08:
Hi,

I’ve had a few instances where I’ve had to unplug and plug back in the Arduino, but that’s about it.
If you are using a Mac, you need to have the CH340g driver installed.
If you are using a Linux OS, you have to change the permissions on the port to allow it to communicate.
If the Arduino IDE says that the port is in use, that means that you are already talking with it through another program (such as our import_data.py).
Otherwise, perhaps there is an issue with the Arduino — although I don’t think I’ve ran into this specific problem before. I like the idea of touching up the soldering joints on the USB mini port just in case.

Thanks,

Spencer

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

rbaker314, 2018-09-20:
Hi,

I cut off pins connecting pins 1 and 0 of the arduino.

Still have problems connecting to arduino with computer when plugged into Micro Watch board.

Below is the error code from the arduino IDE when I try to upload the code.

Arduino: 1.8.7 (Windows 10), Board: "Arduino Nano, ATmega328P"

Sketch uses 20670 bytes (67%) of program storage space. Maximum is 30720 bytes.
Global variables use 1138 bytes (55%) of dynamic memory, leaving 910 bytes for local variables. Maximum is 2048 bytes.
C:\Program Files (x86)\Arduino\hardware\tools\avr/bin/avrdude -CC:\Program Files (x86)\Arduino\hardware\tools\avr/etc/avrdude.conf -v -patmega328p -carduino -PCOM3 -b115200 -D -Uflash:w:C:\Users\jwise\AppData\Local\Temp\arduino_build_565452/Arduino_Code.ino.hex:i

avrdude: Version 6.3-20171130
         Copyright (c) 2000-2005 Brian Dean, http://www.bdmicro.com/
         Copyright (c) 2007-2014 Joerg Wunsch

         System wide configuration file is "C:\Program Files (x86)\Arduino\hardware\tools\avr/etc/avrdude.conf"

         Using Port                    : COM3
         Using Programmer              : arduino
         Overriding Baud Rate          : 115200
avrdude: stk500_getsync() attempt 1 of 10: not in sync: resp=0x30
avrdude: stk500_getsync() attempt 2 of 10: not in sync: resp=0x20
avrdude: stk500_getsync() attempt 3 of 10: not in sync: resp=0x30
avrdude: stk500_getsync() attempt 4 of 10: not in sync: resp=0x20
avrdude: stk500_getsync() attempt 5 of 10: not in sync: resp=0x30
avrdude: stk500_getsync() attempt 6 of 10: not in sync: resp=0x20
avrdude: stk500_getsync() attempt 7 of 10: not in sync: resp=0x30
avrdude: stk500_getsync() attempt 8 of 10: not in sync: resp=0x20
avrdude: stk500_getsync() attempt 9 of 10: not in sync: resp=0x30
avrdude: stk500_getsync() attempt 10 of 10: not in sync: resp=0x20

avrdude done.  Thank you.

An error occurred while uploading the sketch

This report would have more information with
"Show verbose output during compilation"
option enabled in File -> Preferences.

Thanks,

Bob

Closed 2018-09-20.

Thread 22 (2018-09-19):

Issue with consistent read out & issue with verifying parts

80years80, 2018-09-19:
Hello,

Could you please add a parts legend? E.g which resistor values on the board go with which value.

I am having issues having the single detector reading out data consistently. The Oscope data for the most part seemed good, but TP2 did seem noisy when I lowered the trigger threshold. The issue I am having is nowhere lists the resistor values for it. The picture of the button shows a 300 ohm resistor but we bought a 249 ohm resistor for R3 as the parts list suggested. I did try retouching the legs between the peak and amplitude detector.

It seems after running it several times on average it seems that the count increments every 6.66 seconds after letting it run for several minutes.  However it is by no means consistent sometimes it will go minutes without blinking then it will rapidly start blinking/counting and catch up.

Here is my recorded Oscope data, when I looked at TP2 for the second time it seemed that once the peak was detected it would go crazy up and down, but when it was slightly higher it seemed normal.

spenceraxani, 2018-09-20:
Hi Emre,

I think the file you are looking for is called the SMT_reference.pdf located here:
https://github.com/spenceraxani/CosmicWatch-Desktop-Muon-Detector-v2/tree/master/PCB_Files <https://github.com/spenceraxani/CosmicWatch-Desktop-Muon-Detector-v2/tree/master/PCB_Files>

Did you lower the Arduino threshold? Setting it around 50ADC counts should be fine. If you zoom into the baseline of the TP2 it will look noisy, but the pulse should look smooth. The resistor value should be 249, can you point me to the picture that shows it as 300Ohms?

You probably still have an issue with the circuit. The count rate should be roughly 1Hz, and the pulses should arrive randomly. Your TP2 should look similar to TP1 but amplified by a factor of ~20. TP3 stretches the pulse in time by roughly a factor of 1000x, so you’ll have to zoom out. If any of these still look odd, you’ll have to keep trouble shooting your circuit.

Thanks,

Spencer

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

80years80, 2018-09-20:
Hi Spencer,

Thanks for directing me to the parts link I am not sure why I didn't check under pcb files, my bad.

I did try playing around with the threshold some and it did not really seem to improve the situation.
Here is the link to the image:
https://raw.githubusercontent.com/spenceraxani/CosmicWatch-Desktop-Muon-Detector-v2/master/Pictures/Bottom%20view.jpg

I agree with you that at this point it still seems to be a circuit error. The pulses seem to arrive randomly so I think at least it is on the main pcb.

I think a sample of the oscope data I was getting and observing seemed like you described it. I think at this point from the observed behavior that either way it is within the circuit, hopefully it will be quick to verify the correct parts are in place.

The measured random sample data I was getting was:
TP1:  30mV, 80mV, 100mV, 40mV. Settings were 20 mV, 1 uS
TP2: 2V, 1.6V, 2.8V, 1.2V, 0.5V Settings were 1V, 2.50 uS
TP3: 1V, 1.5V, 0.8V, 0.4V Settings were 1V, 2.50 uS

Thanks,

Emre

80years80, 2018-09-21:
So I went through the circuit again and noticed a few things:

In R5 and R20 in the circuit supposed to be 10k components both measured about 5.05k, from looking at the schematic I don't really see any reason why the resistances should be reduced in the circuit as if they are in parrell unless maybe a cap got busted?. R6 and R7 both read 50k. but I think that might be normal for that part of the circuit

Another thing I noticed is the 10uF cap C4 on the main PCB when I measured the same component used for it with a volt meter it returned 8uF, I am aware the capacitor has a tolerance of about +/- 20% which could be the cause of this. Is this possibly due to the wrong component being bought? Or most likely the tolerance is the reason?

spenceraxani, 2018-09-21:
Hi,

If you measure the resistance across R20 while the board is populated, you’ll measure a reduced resistance since you are also measurement the R3/R5 components in parallel. ie. 1/(1/(10000+249)+1/(10000)) = 5.06k. The R20 resistor isn’t necessarily important, it was more an artifact from optimizing the circuit. The reason you measure a lower resistance across R6 and R7 is the same argument; you also have to take into account the resistor R24.

C4 and C5 are just capacitors used to reduce noise on the VCC (power line). The values of these capacitors aren’t very important though. Any uF-scale capacitor will have a similar effect. I would bet that the reason that you read 8uF is due to the tolerance that you point to.

Hope this answers your questions.

Thanks,

Spencer

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

80years80, 2018-12-26:
Hello, after coming back to this project since I have time again I started trying to note data again and the OScope Data seems correct to me and should work fine with the analog pin it is connected to.

When I did open the serial monitor I did notice something weird, that all the counts it got are around 260, and that the sipm voltage is always about 44mV. It seems the detector only counts when this occurs. It seemed like from your sample data in the instructions that this should vary much more than my data is.

Do you have any idea what in the circuit could be causing this behavior?
Here is the data I am talking about. This was with the signal threshold set to 50:
##########################################################################################
### CosmicWatch: The Desktop Muon Detector
### Questions? saxani@mit.edu
### Comp_date Comp_time Event Ardn_time[ms] ADC[0-1023] SiPM[mV] Deadtime[ms] Temp[C] Name
##########################################################################################
Adler
1 41 231 39.55 81 14.13
2 7925 259 44.69 8229 14.13
3 9310 255 43.96 9691 14.13
4 12477 255 43.96 12971 14.67
5 14054 255 43.96 14623 14.13
6 16482 255 43.96 17126 14.67
7 37353 268 46.26 38795 14.13
8 39439 259 44.69 40955 14.13
9 39697 248 42.69 41213 14.13
10 41383 263 45.37 42974 14.13
11 43493 255 43.96 45162 14.13
12 46138 255 43.96 47922 14.67
13 51703 255 43.96 53678 14.13
14 54288 248 42.69 56379 14.35
15 61078 259 44.69 63437 14.13

Thanks,

Emre

spenceraxani, 2018-12-27:
Hi Emre,

That’s pretty interesting. 255 is what you would get if you were maxing out an 8-bit ADC (2^8 = 256, or 0-255). I see however that there is values larger than 255 though, so it could just be a coincidence. This is a new one for me.

The count rate is also pretty low, and the dead time is way too high. It’s likely that there is a problem with the circuit. Did you test all three test point connections using the oscilloscope? To me, it looks like there is some DC offset of approximately 44mV.  The detector looks like it's getting stuck after triggering, then waiting for the pulse to return below the 50 ADC count trigger. However, since there might be this offset, it never (or rarely) sees the ADC count drop below 50. This would cause you to almost always get the same reading, and inflate the dead time.

I can’t identify what could cause this without checking the waveforms on the test point connections. Can you describe what you saw when hooking up to the oscilloscope?

Thanks,

Spencer

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

80years80, 2018-12-28:
Here's the videos:
BNC: https://youtu.be/cT_H8t7dOYk
TP1: https://youtu.be/fEiPCxk4SDs
TP2: https://youtu.be/b9EeosZQ5G8
TP3: https://youtu.be/dR684vRVL2c

It seems that there is as you suggested a DC offset of about 50mV or there is some sort of oscillation going on.

spenceraxani, 2018-12-29:
Hi Emre,

It looks like you are close. I can see large fluctuations in the baseline that are likely causing the problem. The good news is that the rest of the circuit is likely correct.

While it’s extremely noticeable in TP2 and TP3, even the BNC connection looks rather noisy to me. I haven’t seen this one before, but my best guess would be check a few things.

1. Make sure it’s light tight. Maybe wrap in a black cloth or bag to check.
2. Replace the op amp. This is my best guess to the problem. LT will send you a free sample if you have an account with them.
3. Check the power to the SiPM. A multimeter might indicate that it’s 29.5V, but maybe there is underlying noise that you cannot see. You can look at the DC-DC booster waveform by AC coupling it to the scope. I see that on your screen, top right, it says that you are DC coupled.
4. Sadly, it could be an issue with the SiPM. But I this this is unlikely.

You can also zoom out in the x-axis, to see if the problem is cyclical/. If it’s 60Hz, it might be from the lights. If it was 3MHz, it would be the booster, but we would see that in the current video.

Hope this helps.

Thanks,

Spencer

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

Thread 25 (2018-10-31):

sketch failing due to errors

northern-nuke, 2018-10-31:
Using Windows 10

error message:
[arduino_fail.txt](https://github.com/spenceraxani/CosmicWatch-Desktop-Muon-Detector-v2/files/2535908/arduino_fail.txt)

Also having difficulty sourcing LT3461A -- trying direct from China.

thanks
Bryan

per1234, 2018-11-02:
You're trying to compile some HTML code used to display an Arduino sketch in the browser. You've utterly failed at copy/paste.

spenceraxani, 2018-11-02:
Hi,

Could you elaborate on the last comment. What piece of code are you trying to run?

Thanks,

Spencer

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

northern-nuke, 2018-11-03:
still trying to get cosmic watch code into arduino.

I am now pasting naming file in sketch as run once.
I get an error re syntax.

sketch_nov03d:19:37: error: a function-definition is not allowed here before '{' token

 boolean eeprom_is_addr_ok(int addr) {

                                     ^

sketch_nov03d:23:76: error: a function-definition is not allowed here before '{' token

 boolean eeprom_write_bytes(int startAddr, const byte* array, int numBytes) {

                                                                            ^

sketch_nov03d:395:1: error: expected '}' at end of input

 }

 ^

exit status 1
a function-definition is not allowed here before '{' token

This report would have more information with
"Show verbose output during compilation"
option enabled in File -> Preferences.

I'll get there eventually. Still waiting on parts deliveries.

per1234, 2018-11-04:
The error message's line numbers still indicate that you didn't copy the sketch correctly. The best thing to do is to just download the full repository:

1. Go to the repository homepage: https://github.com/spenceraxani/CosmicWatch-Desktop-Muon-Detector-v2
2. Click "Clone or download".
3. Click "Download ZIP".
4. Unzip the downloaded file.
5. (In the Arduino IDE) File > Open > select CosmicWatch-Desktop-Muon-Detector-v2-master/Arduino/Naming/Naming.ino from the unzipped folder > Open

If you do want to only grab a single sketch from a repository then you need to first click the "Raw" button on that sketch page. After that you can either use your browser's File > Save menu option or else just copy and paste the text from the browser. Be aware that some Arduino sketches are made of multiple files (though not the Naming sketch) so if you only grab a single file of the sketch it won't work.

northern-nuke, 2018-11-14:
I've returned from other distractions.

Previously I was trying to get the code into an already open Arduino IDE window. I changed to opening the naming.ino file as you suggested, including the library files, and it compiled!
Now I have the next problem -- the IDE detects the Arduino and identifies it. Alas the IDE tries to upload and fails to "sync" giving up after ~13 attempts. I have installed the Win CH340G driver. I am using an old Dell 32 bit laptop running W10. (I previously had FTDI chipset serial port drivers installed.)

My LT3461A chips arrived from A-Grade Electronics at an embarrassing price. I'm still waiting on the Elecro front and rear plates for the enclosure.

northern-nuke, 2018-11-15:
Thanks for your encouragement ... the "old bootloader" option was what it took. Software is in. 29.5 V ... now I have to finish it and see if it counts!

northern-nuke, 2018-11-17:
I cut the mis-matched Vcc and Gnd pins on the OLED board connector and hard-wired the Vcc and Gnd. Amazingly enough it survived and displays. I get counts (and LED flashes) only when I tap the scintillator.

I have some more work to do yet ... still waiting on the Elecro front and rear panels.

northern-nuke, 2018-11-21:
Have 1 of a pair of CosmicWatch V2 running. I find that this unit generates a single count on startup and counts for ~ 2 h and reaches a total of ~ 472 or ~ 380 and then stops counting. The display and timer functions continue but no more counts for hours.

Removing power / reconnecting or pressing reset button causes a restart and one count, but no more counts. Removing power and then trying again the next day provides a similar sequence of events. I have the boards in the case without the end-plates (somewhere in the mail now exacerbated by labor problems at Canada Post) secured with rubber bands.

The other unit starts with a flash of the green LED on the Arduino -- but no count. It did something similar earlier reaching ~56 counts before quitting. Alas in trying to resolve the SIPM connection ONE MORE TIME I succeeded in removing both solder pads from the board.  Talk about skill!
I drilled the through-holes out and routed a wire through each soldered to the SIPM and the respective resistor. I have yet to get this unit counting again. It does not start with a single count unlike its sibling.

I have yet to impose on my friend with a 'scope.

northern-nuke, 2018-11-22:
I tried to upload the OLED code again in the hopes of updating the library in one unit. This failed with an error and now the code appears to be running but the OLED display is not.
How do I perform a fresh re-load of the code into the Arduino?

northern-nuke, 2018-11-22:
I should have mentioned that I moved the non-repaired SIPM card to the board that was not counting for a test. Following my code mangling above, it appeared to be counting (green and white LEDs flashed). The "other" unit is not counting. This is consistent with suggesting that my "repaired" SIPM board is not functional.

northern-nuke, 2018-11-26:
Hope you had a great Thanksgiving holiday.
Is the 29.5 V or 29.9 V too high for the SIPM? When I plugged the "coincidence" cable in to power both  units, the unit that counts seemed to work again for a while. I get the same voltage levels with either a PC USB port or a portable USB battery. My 4.6 V is 4.7 V.
Somehow I managed to pull the connector off the micro SD card -- haven't a clue what I did, but it pulled the pin out of the connector and pulled the pad off the circuit board. I need a "solder sucker" to remove the board to complete the "repair".

spenceraxani, 2018-11-26:
I’m actually at the South Pole right now, but we did have a great Thanksgiving diner a few nights ago.

I’ve operated the SiPMs at 29.9V before, however there is a spread in breakdown voltage of the SiPMs. I’ve never ran into problems running at 29.5V.

I would also recommend using solder wick rather than a solder sucker. The solder suckers can be a bit forceful when working with surface mount components and can sometimes rip the pad off with the solder.

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

northern-nuke, 2018-11-28:
OLED displays now working on both units (a patch wire that I thought was soldered came free - fixed that.)
noticed that when the 2 units are connected via the "coincidence cable" neither counts. "Unit 2" counts sometimes when it is powered alone. Perhaps Unit 1 has an oscillation problem?
Software reload was straightforward once I checked the COM port and made the change.
I've been using silicone grease as an optical coupling agent. Moen sells a small container with this for O-ring lubrication when maintaining plumbing. I tested it with pieces of PMMA and observed that it appeared to provide good optical performance. It's easy to find and inexpensive compared to liquid optical coupling fluid.
More tests to do.

Closed 2018-12-10.

Thread 26 (2018-11-25):

Face plate screws

msrooks, 2018-11-25:
Hi Spencer,
I don't see a listing for the face plate screws. Looking for a recommendation please.

Thanks,
Michael

msrooks, 2018-11-28:
Perfect thank you! My case did not come with any screws. I'm also waiting for face plates to arrive.

northern-nuke, 2018-12-08:
I thought they were #6, but they are smaller. The hole in the case extrusion is a bit larger than the drill for tapping 4-40. I tapped the holes. This made installing the (non-4-40) screws easier and generated less we bits than the #6 "sheet metal" screws would have. They are a bit homely, but they went in.

msrooks, 2018-12-08:
I also noticed this after buying the #6 screws, but thankfully I also found the screws that came with the case hidden inside the box. Both cases did indeed come with screws.

msrooks, 2018-12-08:
Probably okay to close this issue @spenceraxani my mistake for opening it. The Enclosures & Cases folks provided the screws.

Closed 2018-12-08.

Thread 27 (2018-12-03):

Scintillator Malfunction Tips?

jimgallatin, 2018-12-03:
Spencer, I am switching from your email to this account to declutter your life.

I have built two sets of SiPM and Main PCBs, and think I have them working.  The voltages are correct, and there is current throughout.  (I only have 29.3V on one PCB’s SiPM connectionbut I don’t see that as a problem.)  Soldering in good shape after some redos and replacements.  However, I am not getting a signal through the BNC, and no counts on the screen or through the Python data reads.

Since my first two scintillators were less than perfect, I am assuming that my core issue is the Scintillator or Scintillator-SiPM connection.  I plan to assemble a third combo but want to get some adult supervision before my third try.  (I used to work with NVG technology but this is way different.)

Please excuse any and all ignorance here.

1.  I am confident I have wrapped the Scintillator well in one layer each of tinfoil and tape.  Should I move to two layers of each as some have suggested in these comments?

2.  My Scintillators are clear but were very slightly warped during heat treatment. Think concacity.  Issue?

3.  It is conceivable that the SiPM is not super flush against the Scintillator, but I did use a good amount of optical gel as you recommended.  How flush does it need to be?  I have been assuming the muons have nowhere else to go with all the wrapping.
.

jimgallatin, 2018-12-03:
Thanks again for such a great project.  Jim Gallatin

jimgallatin, 2018-12-03:
And meant photons not muons.  Sigh.

jimgallatin, 2018-12-04:
Spencer, I made another scintillator and fixed the issues of concern.  Onwards.

spenceraxani, 2018-12-06:
Hi Jim,

The scintillator is normally not an issue, as long as the face that interfaces the SiPM is clear. Having a concavity won’t hurt either, the optical gel should take care of that. I typically wrap the scintillator with a single layer of tinfoil, ensuring that it doesn’t short the connections on the SiPM, and then wrap the full piece in 2-3 complete layers of black electrical tape. Light-leaks are likely on the edges. I typically wrap it similar to a present.

It’s possible that the SiPM isn’t flush against the scintillator. This will reduce the number of photons that you observe on every interaction. I tighten the SiPM PCB such that there is a gap roughly the size of the SiPM, or I put a 1/32” spacer around the SiPM and tighten all the way. If you are concerned with the tightening, you can always tighten the SIPM PCB to the scintillator without the tin foil to check how close to go, then where you are comfortable, wrap it in tin foil + black electrical tape.

Next time you open it up, do you want to take a picture of the PCB and the SiPM so that I can check that everything looks good?

Thanks,

Spencer

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

jimgallatin, 2018-12-06:
Hey Spencer,

I am taking a break for exams but will be back in the Detector business next week.

Reading your comments, I am pretty sure I got the Scintillator and SiPM right.  I made a third Scintillator with great care and double wrapped the tinfoil and tape.  It is very clear and I used a good amount of gel as in the YouTube video.

Using either of my two “best” Scintillator and SiPM/PCB combinations, when I connect the Detector to a scope through the BNC, I am now getting identical triggering events, with scope settings at the designated amplitudes and rates, and identical accompanying waveforms.  However, I can’t make the waveforms match the ones on the website.  I am using a standard Tektronix 2000C scope in video mode, and vertical/horizontal settings at 20mA and 500ns, but am not experienced in using oscilloscopes.

When I get back to work, I will download the readings into Python to see what the data says.  I will send you pictures of everything after I check the Python data.

The Arduino and Python codes are running fine, and I have the correct voltages and current throughout the Main PCB (I will reconfirm that again before sending pictures).  I have checked and, where not robust, resoldered every component.  I have the OLED working fine but have only gotten a handful of counts.

As you recommend, I will doublecheck check the resistance across the SiPM when I undo everything to send the pictures.

FYI, I found that it was best to heat treat a precut scintillator before gently drilling the four holes after the scintillator cools.  It is easy to heat the plastic so much that the predrilled holes close up.

Thanks again,

Jim

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

Closed 2019-01-06.

Thread 29 (2018-12-13):

Getting counts only when soldering iron comes into contact with capacitors connecting thenpeak detector to the Arduino.

jimgallatin, 2018-12-13:
Spencer,

I have a good looking pair of PCBs, SiPM and Main.  I have the appropriate current throughout.  But no counts.  I went through the Main PCB components again touching up the solder connections and made the weird discovery that when I touch the soldering iron to the capacitors between the peak detector circuit and the Arduino, or a capacitor in the peak detector circuit, the OLED shows a batch of counts.

I plan to replace the components where this happens under the theory that when the soldering iron comes into contact with the circuit that it closes an otherwise open circuit.  Does that make sense?

Once I have gotten through Christmas I will build a third, and hopefully perfect set of PCBs and send them to you for review.

Happy Holidays to you and the team in Antarctica,

Jim Gallatin

spenceraxani, 2018-12-13:
Hi Jim,

It’s likely that you are just inducing a current into the circuit which is causing noise that triggers the detector. Soldering irons generate heat, which means they are passing a lot of current which can induce a voltage in a wire. I doubt that this is what is causing the problem.

When you saw ‘appropriate current,’ do you mean that the DC booster measures 29.6V?

Thanks,

Spencer

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

jimgallatin, 2018-12-13:
Thanks.  Makes sense since the light didn’t flash ....  OK, onwards then.

On this Main PCB (#1) I can trace 4.7V through the non-SiPM circuit components, and have 29.5V across the GND and HV pins on the SiPM connection.  And the Arduino code loaded fine and the OLED does its thing when plugged in.  That seems to me to say that I have a functioning Main PCB.

After Christmas I will take the Detector apart and send you pictures of the boards.  I will also redo the scintillator-SiPM interface as carefully as I can.  And I will test the current across the SiPM connection, which I haven’t done so far.  I will also build one final Main PCB.

I recall from my work with night vision (using glass boules and PMT tubes) that all sorts of tiny imperfections in the manufacturing process, temperamental machines, or slight intolerances in assembly would render the final NVGs unworkable, and every aspect of this project is new to me, so I am a long way from giving up.  Just more than a little over my allotted four hours.

 Jim

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

spenceraxani, 2018-12-13:
Since it sounds like everything is in place, you should be able to narrow down to +3 components which could be causing the problem using the test points. If any of them look odd, it tells you that that is where the problem is.

I think I go through testing the test points here:
https://www.youtube.com/watch?v=Ck24HGrjBfY

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

jimgallatin, 2018-12-13:
Thanks.  Will do.

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

Closed 2019-01-06.

Thread 30 (2018-12-26):

Super simple form, fit, fyctuion

jimgallatin, 2018-12-26:
I’m sure this is a rock dumb question but does it matter functionally that I installed the Arduino

jgOhYeah, 2018-12-27:
It depends what you mean by "functionally." The Arduino is involved in most aspects of the detector, including converting the analog signal from the sensor to a digital number, determining if the inputted signal is a count, counting, driving the display, writing to the SD card, talking to the computer, driving the count LED, handling the master / slave connections, powering the detector and so on.

However if you have an oscilloscope or are wanting to use the detector as a trigger for something else by connecting to the large, round BNC connector on the back or one of the test points and do not need the above features, you could probably get away without the Arduino by supplying 4.5-5v between the 5v pin and Ground pin where the Arduino would normally go.

Closed 2019-01-06.

Thread 31 (2018-12-26):

Super simple form, fit, fyctuion

jimgallatin, 2018-12-26:
I’m sure this is a rock dumb question but does it matter functionally that I installed the Arduino

jimgallatin, 2018-12-26:
With the long and short legs put on the wrong side of the main PCB?  I have Arduino on the correct side and can install everything else still so I don’t have a fit or form issue.  If so, I now have a great looking set of boards and functioning scintillator.  Once I receive a component I ran out of I will send pictures of the boards, connect it all, and report results.

I have successfully gotten appropriate counts but after an hour something stopped the, so I built a third (and final) Main PCB.  Almost there.

Happy holidays,

Jim

spenceraxani, 2018-12-26:
Hi Jim,

Sorry, I’m not sure I fully understand. Do you mean that the header to mount the Arduino to the PCB is just upside down? If that’s the case, it doesn’t matter. Also, did something happen after running for an hour? If everything is built correctly, they should run for ~40 days without a problem. After 40 days the variable holding the timing information will roll over.

Thanks,

Spencer

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

jimgallatin, 2018-12-26:
Hey Spencer,

Yup, I installed the header upside down (talk about feeling foolish).  Figured not a problem but good to confirm.

After an hour it just stopped adding counts.  I am betting that something shorted or lost the connection when it was an unstable piece of soldering or whatever.  I was glad to get that far.

I should get my new components (Line Item 13 in the list) in a few days and hope to finally finish this phase of the project.

Jim

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

msrooks, 2018-12-31:
Hey Jim,
I had a detector that would start and stop sometimes when I put pressure on the scintillating block. I finally figured out that it was just a light leak in one of the corners. I wrapped another piece of black electrical tape around the corners. This resolved the problem.
Best,
Michael

jimgallatin, 2019-01-02:
Mike,

Thanks for this.  I’ve been away.  It makes sense.  I’ll retape my scintillator.

Jim

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

jimgallatin, 2019-01-04:
Thank you Mike and Spencer.  I have a solid signal through the BNC connection that looks exactly right, 20mv and 500ns, less than 10 MHz (I’m guessing .5-1 MHz).  Awesome.  But I have work to do.  I have no signal from TP1 (I am assuming a bad solder joint), a nice signal from TP2 (mimics the BNC signal when running together), and no signal from TP3.  But I am super happy to get this far.  Happy New Year.  Jim

Closed 2019-01-06.

Thread 32 (2018-12-27):

LT 1807 Op Amp heating up

jimgallatin, 2018-12-27:
Spencer,

I have finished a new Main PCB (I’ll send pictures next).  I am pretty confident that the soldering is adequate.  I have a solid scintillator and SiPM combination.  I have 29.4V at the SiPM HV/GND points.  I thought I was fresh out of reasons for why the resulting detector won’t work when assembled and plugged in.

And yet.  When I assembled and plugged in, everything lit up, screen came up, etc.  However, within seconds after plugging it in, the LT 1807 became too hot to touch and faint smoke was emitted.

To be sure it wasn’t that particular 1807, I replaced it.  Same result (didn’t wait for smoke).  I assume I have a short!?  Any ideas?

spenceraxani, 2018-12-27:
Hi Jim,

Was it orientated in the proper direction (pin 1 should be orientated such that it is on the pad with the circle)? A short across the legs of the opamp could also cause this, but since you’ve seen it twice, it’s unlikely. A short (or 0Ohm resistor) across R3,R6 or R20 will also cause this.

Thanks,

Spencer

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

jimgallatin, 2018-12-27:
Thanks.  To be clear, are you saying that 1) a short across (say caused by too much solder) or 2) erroneously using a Zero Ohm resistor for R3, R6, or R20 could cause this result?  I will go back and double check the resistance of each of those components.

On the orientation, I am pretty sure I have it right as I have oriented it same way on the prior boards.  There is a little squiggly thing in one corner and I am treating that as the number one leg corner and placing it by the circle.

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

rogerio-acioli, 2019-01-04:
Hi, Jim!

I had the same problem at my first doing the main PCB. What I found was that I probably made a short between the legs of the LT1807. It really got too hot and emitted smoke. What I did was rebuild every piece by making sure it component was right and trying to make a really good job at the soldering of the opamp!

I hope you can make it work!
Thanks,
Rogério

Closed 2019-01-06.

Thread 34 (2019-01-05):

Booster voltage first too high, now too low

theostoelzl, 2019-01-05:
Hi Spencer,

I'm having a little trouble with my Main PCB. I fully populated the PCB and plugged the Arduino into my power bank. (I tried with a phone charger as well, same result.) At first, I measured 4.6 V between the HV and GND pins, after which I resoldered the legs of the booster, which gave me about 33 V output. So I've resoldered a few legs again and now I'm stuck with something between 23.5 and 24.5 V, varying when I put some new solder on one of the legs - or take some away - and apparently also when room temperature changes (I just closed my window and voltage dropped from 24.5 to 23.5 V). Could I power the SiPM with that voltage, and do you have an idea where my trouble might be originating from?

Plus, I noticed that the inductor gets really hot while plugged in, should I worry about that? The booster heats up as well but not as intensely as the L1 inductor.

Thanks a thousand,
Theo

spenceraxani, 2019-01-05:
Hi Theo,

Nothing should even get noticeably warm to the touch, so you probably have a short somewhere drawing a lot of current. My first bet would be that there was a short between the booster legs (but it sounds like you’ve already tried this). My next guess would be a short or misplaced component somewhere in the booster circuit. The ratio of the resistors R1 and R2 determines the output voltage, so I would start there. As a firs step, I would take your soldering iron and go over each solder joint again, melting and resolidifying the solder to make sure you have a good connection.

I would also be careful when plugging it in. The Arduino is the one supplying the power that is being thrown away to heat. It’s only able to supply a few watts, and you really don’t want to overload it (it’s just a big pain to replace).

You can also send me a photo of your board and maybe I can spot the issue.

Thanks,

Spencer

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

theostoelzl, 2019-01-05:
Thanks for your prompt reply!

I've already added the photo above.

I tried melting and resoldering, nothing changed; I did, however, remove some solder from the L1 inductor and my voltage went up to ca 25.8 V. The overheating remains, though. I also measured the resistance of R1 and R2, for R1 it says 10 kOhm and for R2 214 kOhm. Could the 12 kOhm difference in resistance be the reason for the missing voltage, so should I just try another 226k resistor instead or could the difference result from something else than a faulty resistor?

Thanks
Theo

spenceraxani, 2019-01-05:
The L1 component should not get hot, so I think we’ll have to figure out what’s causing this before trying to get the voltage to the correct value. The formula for the output voltage is 1.255(1+R2/R1), so if the resistance of R2 is 214, you should still expect to see 28.1V. Also, it’s pretty tough to determine the resistance of a resistor that is mounted on a circuit board since there are often other paths that the current through the board. For example, if there was a 4k resistor somewhere downstream of R2, that went to ground you would measure the resistance to be 214 rather than 226. This resistance could even be internal to the LT3461A.

I doubt this is the issue, but I’m unable to tell in the picture. Is the booster mounted in the correct orientation? I don’t think you would see any voltage if it wasn’t, but I want to check that it was originally mounted correctly.

I can’t identify an issue with any of the soldering from the picture, so if you’ve already redone all the connections there, we’ll assume it’s good. I also can’t tell the values of the capacitors since they are unlabelled, so there could be a chance that one of the capacitors is the wrong value. The only capacitor there that could cause issues is C1 — the others are only for reducing noise and you can ignore them. There’s also a chance that the booster is broken and causing problems (I’ve had roughly a 2% failure rate on the boosters). Do you have an extra one to swap in to test?

I see from your images that you also only connected the pins on the Arduino that had the dot beside them — I would connect them all just in case I missed on (this isn’t causing your problem, but might save you some troubleshooting later).

For the future, I would also place your resistors with the dark side up, so that you can read the values of all the resistors on the board.

Spencer

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

theostoelzl, 2019-01-05:
Thanks for the tips, will do!

My bad, it really isn't visible at all in the photo, I believe I soldered it in the right orientation, the little arrow is pointing to the dot on the board.

I'll check the capacitor. But unfortunately I haven't got another booster so for now I'll have to trust that it works fine.

Theo

theostoelzl, 2019-01-06:
Hi, so I replaced C1 with the redundant 226k capacitor from the order and so far nothing has changed. I usually measure a voltage between 25.5 and 26.5 V now. However, I noticed that the voltage in the inductor between one of the soldered sides and the windings amounts to about 180 V, I just have no idea why it's _that_ high - or is that usual behaviour (considering the overheating I suppose no, but I'm asking as a complete electronics-anti-expert)? Could I have soldered the inductor wrong or might it be corrupt by default? I simply cannot find a short anywhere (else).

Theo

theostoelzl, 2019-01-06:
Sorry, I meant C1 with a 22 pF capacitor of course.

I'll definitely try that. I'm afraid I can't see your attached photo, though.

Thanks a lot, especially for taking time even on a Sunday,
Theo

spenceraxani, 2019-01-06:
Hi,

Sorry, I guess images don't pass through to github.

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

spenceraxani, 2019-01-06:
Interesting. Next step will be to replace the LT3461A.

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

theostoelzl, 2019-01-06:
Thanks a bunch, already ordered a new one. Hoping for the best.

Theo

theostoelzl, 2019-01-11:
Hi again,

So I replaced the booster and the same issues persist.

Thanks,
Theo

theostoelzl, 2019-01-11:
Unfortunately, I have already replaced L2 with the redundant, unused one (so that _should_ be working fine).

Checked, voltage amounts to exactly 4.6V between 5V and GND.

Theo

spenceraxani, 2019-01-11:
Could you also solder all the connections on the Arduino pins and make sure non of them are bridged? After you are adding solder to the pins, can you send me an updated photo of both sides of the PCB?

The only other components in that part of the circuit are the two resistors and the single capacitor. It’s unlikely that there is a problem with those as long as they are the correct value. Incorrect values will change the output voltage, but you wouldn’t see any fluctuations — just the wrong voltage reading. I also know that you replaced the 22pF cap and touched up all the solder joints.

It could be that there is some other part of the circuit drawing a lot of current, and not supplying enough current to the DC Booster circuit. This could cause fluctuations in the DC Booster output. Since you have disconnected L2 it won’t be related to any of the other resistors or capacitors on the PCB.

The only three components that take power from this line will be the op amp, the 3.3V regulator on the sd card PCB, and the Arduino itself. Are any of these hot?

If the op amp and the 3.3V regulator look fine, there’s a chance that it’s an internal issue with the Arduino. Perhaps it’s able to produce 4.6V, however maybe not able to pump out the current needed. Let’s hope this isn’t the issue — replacing Arduinos aren’t worth the time. If you think the Arduino is the culprit, let me know and I’ll send you a new PCB with an Arduino in the mail.

Spencer

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

theostoelzl, 2019-01-15:
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

I haven't connected the SD PCB yet, so I don't know about the 3.3V regulator. And the op amp gets slightly warm at best, I don't think you could even remotely speak of hot there.

I highly appreciate the offer but in case the Arduino is the issue I have four spare PCBs from Elecrow, so that really won't be necessary!

On a side note, I just connected the display and noticed that it didn't work either. (The VCC pin is connected correctly.) Plus, sometimes the LED flashes randomly. Could those be related to this issue?

Thanks a lot,
Theo

spenceraxani, 2019-01-15:
Hi,

The detector will work fine without the SD PCB. We reference the Arduino  to 3.3V with the builtin regulator on the Arduino. R17 connects the reference pin to the 3.3V pin.

The op amp should not get warm in the slightest. It’s a good bet that you have a problem in this area. I haven’t seen an op amp break, but I have seen many many times improper soldering joints on the op amp. Try retouching those with the soldering iron and making sure you have a good connection. You could alternatively remove the op amp, and see if the voltage on the booster goes to 29.5V.

The OLED should work independently of the rest of the circuit. The 4 pins on the OLED go straight to the Arduino. Have you uploaded the OLED.ino code to the Arduino?

The LED might be all over the place if the SiPM PCB isn’t plugged in. Don’t worry about this until the voltage issue is solved.

Thanks,

Spencer

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

theostoelzl, 2019-01-19:
Hi,

I've touched up all the solder joints on the bottom side of the PCB, again, and put some new solder on the op amp legs, and yet again nothing changed. I'll try removing it, next.

The OLED.ino is uploaded; however, with the 328P old bootloader preset (if that changes anything, it wouldn't let me upload otherwise). The display remains black.

Thanks,
Theo

dnbaldwin, 2021-04-11:
Hello, Ive been following this with interest as I have built two boards now and both have exactly the same problem, with the U1 and L1 getting extremely hot immediately. I note that the board circuitry in the photos is a slightly  different version to the one for which pcb plates can be obtained. for example, mine has a U7, R18 and R 19 which are NS. These are not on the website version. Could I ask if anyone else has had this over heating problem, and if so how they resolved it? cheers, Dave

Thread 35 (2019-01-06):

Beautiful waveform through BNC, no joy through TP1 and 3

jimgallatin, 2019-01-06:
Spencer,

Thanks to you and others I now have a fantastic waveform through the BNC, looking just right.  A huge sense of accomplishment.  I also have a functioning OLED and LED.  However,

1.  I get nothing through TP1 (seems impossible since TP1 is a direct connection)

2.  I get a wave through TP2 which pulses in tandem with the BNC wave but which is much smaller than the BNC wave (seemingly the opposite of being amplified); this may be some glitch in how I have set up Channel 2 in the scope.

3.  I get nothing through TP3

4.  The OLED shows no counts and the LED doesn't flash

I had no glitches in loading the Arduino software and the splash screen works fine.  I have quadruple checked every solder joint.

If I understand the debugging notes in the manual this points to a problem with the Arduino software?  If so, I suppose I could cut and paste the source code from Github, compile and reload it?

Happy New Year down there,

Jim Gallatin

spenceraxani, 2019-01-06:
Hi Jim,

Glad to hear you are seeing the correct waveform on the BNC. You likely have a problem with the peak detector part of the circuit.

It seems very strange that the TP1 doesn’t show anything since it is almost the exact same connection as the BNC. One possibility is that your scope problem is 10X rather than 1X and it is scaling the size of the voltage by a factor of 10.

TP2 should be approximately 20x larger than the BNC pulse. You might be seeing a small pulse again due to the scope probe. Or, it sounds like you might need to just scale channel 2 on the oscilloscope properly. Keep the time divisions the same as channel 1, and make the voltage divisions about 200mV. I would keep the trigger set to channel 1, to trigger on the BNC pulse.

If it turns out that you are getting the proper pulses on TP2, and nothing on TP3, then your next issue is with the peak detector circuit. The most common thing I’ve seen here, is either a bridged leg on the op amp, or a rotated diode — diodes have direction. I’ve also seen people put in 10uF caps into C6 rather than 10nF.

You don’t have to ever cut and past the GitHub code. Simply download the code, open it with the Arduino IDE, and hit upload. It sounds like the Arduino code is working fine though.

Thanks,

Spencer

> On Jan 5, 2019, at 8:35 PM, jimgallatin <notifications@github.com> wrote:
>
> rough TP2 which pulses in tandem with the BNC wave but which is much smaller than the BNC wave (seemingly the opposite of being amplified); this

spenceraxani, 2019-01-06:
Glad to hear the detector is working!

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

Closed 2019-01-09.

Thread 36 (2019-01-08):

Flying with a CosmicWatch detector

Pappy85, 2019-01-08:
The CosmicWatch paper has a really nice plot of count rates during a flight. I'm wondering how many people have tried this measurement and if they'e experienced any problems getting the detector through security. Any notes about your experiences would be greatly appreciated!

spenceraxani, 2019-01-08:
Hi,

I’m not sure how many people have taken the detectors through airport security, but I typically take a few detectors with me wherever I travel. Over the past few years, I’ve probably taken them on well over 50 flights and have never ran into issues. The TSA is more concerned with the cell phone power banks that I use to power the detector, since there are airline regulations limiting the size of Li ion batteries.  The detector is essentially nothing but a circuit board and a piece of plastic and I think the TSA is trained well enough to understand that it’s not something of interest. Sometimes in air, the flight attendants will ask about the detectors, however it’s mostly out of curiosity (I think many of them know that they are subjected to an increased amount of radiation). Or, sometimes they want to ensure that it doesn’t transmit any signals.

I would like to say that this was my personal experience and I can’t speak for the TSA on the subject. I wouldn’t want someone to find themselves in trouble because of this. If you are concerned about whether or not you can bring it on the plane, I believe you are able to contact the airport to speak with a TSA agent.

Hope this helps! I’ve attached an image of my most recent flight to the South Pole below that’s pretty neat.

Thanks,

Spencer

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

Pappy85, 2019-01-09:
Thanks for the insight Spencer. 50 flights and no problems is very reassuring. I'm looking forward to trying it on my own. And thanks for sharing the detector design and supporting those of us building them. Its much appreciated!

jimgallatin, 2019-02-14:
Hey all, I want to repay Spencer and everyone's help by advising that I took and used my detector on a flight from the east coast without issue.  TSA didn't ask about it, nor did the flight attendants.  I plugged it into my Mac for the first half of my flight, getting counts up 22 Hz around 30,000 feet.  I recorded the data using Python but haven't looked at it yet.

Bottom line, I flew using it without incident.

Jim

Closed 2019-01-09.

Thread 37 (2019-01-11):

Count

jimgallatin, 2019-01-11:
After a week of operating my Detector reads .2847 with +/- .001.  I didn’t see count guidelines in the repository materials (I easily could have missed it given my track record in building the Detector).  Are these readings about right?  Haven’t had the chance to download the raw data to my Mac.

spenceraxani, 2019-01-11:
Hi Jim,

If everything was built properly, then you should expect to see roughly 1Hz. This will depend on the environment. Areas with higher levels of radioactive backgrounds might have 1.3Hz, and areas with little background might be 0.7Hz.

0.2847Hz sounds very low to me. Unless it is connected to another detector operating in coincidence mode. Then it sounds about right if the two detectors are sandwiched together. The low count rate could be due to an issue with the circuit, the software threshold in the Arduino code (if it was changed), or the construction of the detector. I doubt it’s due to the construction, unless you aren’t using any optical gel or reflective foil.

Thanks,

Spencer

> On Jan 11, 2019, at 8:41 AM, jimgallatin <notifications@github.com> wrote:
>
> t? Ha

jimgallatin, 2019-01-11:
Hey Spencer,

Thanks.

It is a single detector.

I used optical gel and tinfoil.  (I could try wrapping another layer of tinfoil around the scintillator/SiPM combo.)

I uploaded the code unmodified in any way.

The detector is currently in my basement which is under a concrete first floor.  I will move it to the first floor and see if the count rate improves.

Then I will go over the circuit again.

Jim

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

jimgallatin, 2019-01-13:
Hey Spencer,

I moved the detector to the first floor (above the concrete base of my house).

I checked the threshold in the Arduino code.  It was set at 50.  I changed it to 30 and uploaded the modified code.

I am now getting a count rate of 0.422, +/-.012, after about an hour.  It started out around 0.500 but has stabilized for now at 0.422.  I'll check it again after 24 hours.

Jim

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

spenceraxani, 2019-01-14:
Hi Jim,

It’s likely that your single floor house has ~6inches of concrete between levels, which will not affect the muon rate in any noticeable way. This will however change the comic electron/positron flux by roughly a factor of 3. When you decrease the threshold, you will be letting in more background (primarily gamma radiation). See, for example, the green histogram in Fig. 13 (https://github.com/spenceraxani/CosmicWatch-Desktop-Muon-Detector-v2/blob/master/ThePhysicsPaper.pdf).

I still think there is an issue with your detector that is causing the count rate to be so low. An oscilloscope will help trouble shoot. Connect up to the BNC connection, and wait for a pulse. If your threshold on the oscilloscope is ~15mV, your detector should flash the LED on just about ever pulse that you see on the oscilloscope.

It is my guess that you are close though. Perhaps it’s just a misplaced resistor causing a lower level of amplification.

Thanks,

Spencer

> On Jan 12, 2019, at 6:00 PM, jimgallatin <notifications@github.com> wrote:
>
> d

jimgallatin, 2019-01-14:
Thanks again.  I think I should make sure my incompetence with an oscilloscope isn’t getting in the way.

Trigger set at 15mv, edge, rising, auto mode
Horizontal set at 500ns, main window, trigger hold off 500ns
Vertical set at 10mv increments, probe 1x, coupling AC
Acquire is in sample mode
Measurements Pk-Pk 3.2 to 50.0+ mv, rise time 9-500 ms

Wave looks like specified

I am getting a flash for each trigger, but am also getting more flashes than triggers, which I assume is ok.

My triggers waves look just like your materials in shape.

Assuming my scope readings are ok, I will move on to re-examining each resistor in the amplifier circuit as you suggest.

I’m now running around 0.440 hz

Jim

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

jimgallatin, 2019-01-14:
I forgot to mention I have a solar roof covering all of one half of my roof.  Would that impact the count?

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

jimgallatin, 2019-01-14:
Never mind.  No difference outdoors not under the roof.

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

jimgallatin, 2019-01-15:
Hey Spencer,

Given my ineptitude with a scope, and the fact it, getting counts, I think I will replace the resistors around the amplifier circuit (I installed the right ones but one may be bad or badly solder3d in a way 8 can’t see).  Then I will build my final detector using everything I have learned, see if it works well, and move to studying the circuit design and underlying particle analyses in your excellent paper (which I didn’t see before).

There is no end to the things I am and can keep learning from this project.

Jim

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

spenceraxani, 2019-01-15:
Hi Jim,

Glad to hear it. The second detector always goes much quicker and much smoother than the first.

Thanks,

Spencer

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

jimgallatin, 2019-01-17:
Spencer,

I replaced the three resistors (R3, 5, and 20) in the Amplifier portion of the circuit.  I’m still hovering around .430 Hz.

Any final suggestions before I move on?  Replace the main op-amp component?  I’d really like to have two detectors in the end running together.

I am very confident I used the right tinfoil and tape, and I have triple-checked every solder joint, so I am assuming that I have a “weak” component.

Jim

spenceraxani, 2019-01-18:
Hi Jim,

On your scope, you should be able to set the trigger threshold to 15mV, and set the trigger from ‘Auto’ to ’Normal’ — this will cause the scope to update on every trigger.

Replacing the opamp won’t help either. The components that you purchased will come with an uncertainty in the values that they are suppose to be, and would all be negligible small compared to the change in rate that you are seeing.

I think starting your new detector is a good bet than come back to this later. It could simply be that the optical connection between the SiPM and the scintillator isn’t ideal and there are just more photons being lost. Or, potentially the light yield from your scintillator is just lower. Hard to say, but building your second detector might help out.

Thanks,

Spencer

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

jimgallatin, 2019-01-18:
Spencer,

Thank you.  Your comments are super helpful and give me more confidence in what I have done so far.  I will move forward with another detector.

The project materials are absolutely right that this project exposes one to a world of related areas of knowledge, which is really terrific.  I find that I have to focus on successfully building the Detector or I will get sidetracked in exploring every area that is involved in the project, from how the circuit design works electrically to the processing of the initial photons.  Just reading the paper you linked me to forces me to make a list of each new concept that I don’t completely understand, and there are a lot of those for me to explore.

I am also starting to build something called the Radio Jove Project so the Cosmic Watch Detector experience will be invaluable there.

I will followup once I have the new detector up and running.

Jim

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

Closed 2019-01-26.

Thread 39 (2019-01-22):

Can the power supply impact the count?

jimgallatin, 2019-01-22:
Spencer,

I just noticed that my count fluxuates with the power supply I use.  For example, when I plug the detector into my professor’s Mac the counts sink down to .250.  When I plug it into a wall socket or my Mac the counts rise to .422.  I will be building a second Detector as you suggested but thought this might be relevant to my low counts (beyond the likelihood of a less effective scintillator).

Jim

jimgallatin, 2019-01-23:
Spencer,

I took the detector home again and it is now running at .250 Hz regardless of power source.  Weird. I was able to download data to Python.

Jim

spenceraxani, 2019-01-23:
Hi Jim,

I think there’s probably something still wrong with your detector. I think building a second one might shed light on what the issue is.

Thanks,

Spencer

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

jimgallatin, 2019-01-23:
That I am sure of!  Thanks.  Will do.

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

jimgallatin, 2019-01-23:
😎

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

jimgallatin, 2019-01-24:
Count on defective detector back up to .400s.  Building new detector today.  Closing this out.

Closed 2019-01-24.

Thread 40 (2019-01-26):

SD Card Sockets

Johnkurveen, 2019-01-26:
Hi, I'm just getting into this project, and I have a quick question about the SD card sockets.

What are the requirements for the SD card sockets? You link to a $12 purchase on Amazon, but since we are only making one, it's more economical to purchase an individual model from Digikey.

Here is a selection of SD card sockets from digikey. As you see, there's quite a few.
https://www.digikey.com/en/supplier-centers/m/molex/microsd-memory-card-connectors

Will any of these work, or is there a significant difference? In the video of how to make the main and SD PCB boards, you said you ordered the wrong ones, but didn't explain what was wrong with them.

spenceraxani, 2019-01-27:
Hi,

There’s a few different form factors for SD card sockets. I designed the boards based off the sockets that I found were most economical on Amazon and Ebay. It doesn’t quite look like the any of the ones on Digikey are the correct size though. It’s too bad there are so many different versions of this component.

Thanks,

Spencer

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

Johnkurveen, 2019-01-28:
Hi Spencer,

I think you've done a great job designing this project to be cheap and easily made, and I think one way to improve on these qualities is if we can find a way to use more SD card sockets. I know the shape and size of each socket is different, but the pinouts are in the same order at least. Are their size differences for the pins, or is it something else which makes different sockets incompatible?

 John

Thread 42 (2019-03-28):

Information on Arduino code

DeeTech, 2019-03-28:
Hello Sir,

I wanted to know about the following lines in code..

"const long double cal[] = {-9.085681659276021e-27, 4.6790804314609205e-23, -1.0317125207013292e-19,
  1.2741066484319192e-16, -9.684460759517656e-14, 4.6937937442284284e-11, -1.4553498837275352e-08,
2.8216624998078298e-06, -0.000323032620672037, 0.019538631135788468, -0.3774384056850066, 12.324891083404246};"

How you decided these values & how to calculate them..
I am confuse as to how to explain these values...

Thanks.

spenceraxani, 2019-03-28:
Hi Deepak,

These are the numbers used to convert a measured ADC value to a SiPM peak voltage. They correspond to the coefficients of a fitted 11th order polynomial. The fit is shown here:
https://github.com/spenceraxani/CosmicWatch-Desktop-Muon-Detector-v2/blob/master/Pictures/callibration.pdf <https://github.com/spenceraxani/CosmicWatch-Desktop-Muon-Detector-v2/blob/master/Pictures/callibration.pdf>

and described in Sec. 5.2 here:
https://github.com/spenceraxani/CosmicWatch-Desktop-Muon-Detector-v2/blob/master/Instructions.pdf <https://github.com/spenceraxani/CosmicWatch-Desktop-Muon-Detector-v2/blob/master/Instructions.pdf>

Essentially, we just inject a pulse that looks like a SiPM pulse (from an arbitrary waveform generator) of known amplitude and have the Arduino report a measured ADC voltage.

Hope this helps,

Thanks,

Spencer

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

DeeTech, 2019-03-28:
Hello,
1st Thank you for reply.
I understand your point & I read above ref.

But wgat I dont understand is how this value come or calculated..

like  "-9.085681659276021e-27"  & others ..

did it display on arduino after you inject pulses & measured ADC?

You calculated it & then put all 12 values in array cal[];???

Thanks.

spenceraxani, 2019-03-28:
In the plot showing the measured ADC values versus SiPM Peak voltage, the SiPM peak voltage is controlled by setting the size of the input pulse on the waveform generator. The detector itself measures how large the pulse is in units of ADC counts and sends the information through the serial connector on the Arduino. We send ~500 pulses at a given size to quantify the uncertainty in the reported ADC value. The plot shows (in black) the mean ADC value as well as the spread in the reported values. Now that we have these datapoint, we fit an 11th order polynomial to the data — so, for example, one of the reported coefficients on the polynomial is -9.085681659276021e-27. After fitting to the data, we then use that fit in the Arduino code to convert measured ADC values from events, to original SiPM voltages.

Hope this helps.

Spencer

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

DeeTech, 2019-03-29:
Hello,
Thanks.
I understand theory point of view.
But????

As you said above "values in cal[] are coefficients of 11th order polynomial, that means
they are values of a0,a1....a11 in  this right? " "f(x) = 1/1-x = a0+a1x^1+a2x^2+....a11x^11  ?????

So I want to know these values like -9.085681659276021e-27 are displayed on arduino or arbitory generator to put in cal[ ] ??
Or did you use some software or something to get these values...

 because these values are +ve & -ve & increasing in exponential like e-27 then e-23 then so on & last value is ~12. which is also written as 12.324891083404246 . SO i want to know how these values come? Or how you calculated? or Where these values displayed? Or did you just do some maths to get these values & put them in cal [] array?

&
 inject ~200 pulses then calculate the standard deviation of the measured ADC
values.
What is this? & how to calculate it?
Is this related to the values getting in cal[ ]?

Thanks.

Deepak.

spenceraxani, 2019-03-30:
Hi Deepak,

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
This is correct.
> So I want to know these values like -9.085681659276021e-27 are displayed on arduino or arbitory generator to put in cal[ ] ??
> Or did you use some software or something to get these values...
>
The detector prints out the measured ADC value to the serial port when it triggers on an event. So, I send in hundreds of pulses of known amplitude and read the reported ADC values on my computer through the USB connection. In this case, I actually just read the values through the builtin serial monitor on the Arduino IDE. The arbitrary waveform generator just allows me to set the size of the pulse that I am injecting.  I then plot the injected SiPM pulse peak voltage versus the measured ADC value.
> because these values are +ve & -ve & increasing in exponential like e-27 then e-23 then so on & last value is ~12. which is also written as 12.324891083404246 . SO i want to know how these values come? Or how you calculated? or Where these values displayed? Or did you just do some maths to get these values & put them in cal [] array
>
I fit the data gathered in the previous step using python. Is that what you are asking? Specifically, I use the Scipy package to fit the data accounting for the uncertainty in the measurements. Scipy reports the fit values (the coefficients of the 11th order polynomial), and I insert them by hand into the cal[] array. This is a calibration of the electronics. If the electronics change, then this fit has to be re-performed.

If you plot the 11th order polynomial f(x) = a0+a1x^1+a2x^2+....a11x^11, with a0 - a11 from the cal[] array, you would get the blue line in the calibration plot that I sent in the previous email.
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
The standard deviation describes the spread in the measured values.
https://en.wikipedia.org/wiki/Standard_deviation
> What is this? & how to calculate it?
> Is this related to the values getting in cal[ ]?
>
Hope this helps,

Spencer
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

DeeTech, 2019-03-31:
Hello,

"If you plot the 11th order polynomial f(x) = a0+a1x^1+a2x^2+....a11x^11, with a0 - a11 from the cal[] array, you would get the blue line in the calibration plot that I sent in the previous email."

So this is how you get those values in cal []...
I understand now.

Thank you very much for your time.
I sincerely appreciate it @spenceraxani

Regards.
Deepak.

Thread 43 (2019-04-10):

Slave has higher count than master

bojohnson02, 2019-04-10:
We have 2 detectors which seem to work by themselves. But when used in coincidence mode, the slave detects even more than the master. We're not sure what would cause this issue, but were wondering if it's been seen before.

spenceraxani, 2019-04-10:
Hi,

There’s likely a problem. By definition, this should never happen. I haven’t seen this before — what sort of count rates are you seeing?

If the D6 pin on the master detector is HIGH, then the coincidence detector will report every trigger it sees as a coincidence. It could be a short in your 3.5mm connector, can you check your connections? If the power connection on the 3.5mm connector is bridged with the coincidence connection, it could cause your problem.

Thanks,

Spencer

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

bojohnson02, 2019-04-10:
It looks like we just had the 3.5mm connectors not in all the way because the face plates in the back. We were getting rate counts for the master at about 1.5 with the slave at about 1.7

Closed 2019-04-10.

Thread 44 (2019-04-19):

Multiple Issues

rptamin, 2019-04-19:
Hello Spencer,

We are attempting to put this detector on a rocket at Spaceport America Cup, and see the change based on altitude as our scientific payload. However, we are having quite a few issues with the detector.

1. There are time stamps for only some measurements. We are not sure why this occurs. What are ways we can ensure there is a timestamp for all measurements
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

2. The measurements are not consistent and do not seem to make sense. The only way we get measurements is if we press down on the detector. Even then, it is very inconsistent. I replaced the 6 pin header, however, the problem persisted. The ADC values also seem to be off, they are only ranging from 0~10.

Thanks,
PSP Solids Team

spenceraxani, 2019-04-19:
Hi PSP Solids Team,

The data has me confused. How did you record his data (computer, SDCard, serial monitor)? Are you using the executable for windows or the python code? I would strongly suggest using the python code.

Can you link me the GitHub you are working out of?

When plugged into a computer and recording data using the import_data.py script, you should get a time and date stamp by the computer. It looks like you do see a time stamp (23:xx:xx.xxx), however I do not see the date.

I also see arrows, which is an indication that the script is not parsing things correctly. If this is the case, it’s my guess that you have a different library version of one of the programs.

Can you use an SDCard to see if the data is looking alright? When you just power the detector, does the OLED screen report reasonable values (count rates)?

I also see that on the events that do not have a time stamp, that the ADC value is 0 or 1023. These two values are the two extrema values it could have. Zero should never occur, since we set a threshold at 30 ADC counts. Did you modify the Arduino code at all?

Thanks,

Spencer

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

rptamin, 2019-04-19:
Hi Spencer,

So some good news! We were able to fix the problem of problem of it having to be pressed down upon. This was due to the SIPM not having a good enough connection. We desoldered the sensor, and re soldered using solder paste and hot air gun.  So we think we solved our hardware problem, however, our software problem still exists.
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
This is what we get now. The threshold is 50 and it appeared at approximately .3 hz. We will try to use the python script and make sure we get time stamps.

Thanks,
PSP Solids Team

Thread 45 (2019-05-05):

No Detection Of Muons

Aquastar1017, 2019-05-05:
Hey Spencer,

I'll try and upload pictures in two days if I can as the project is currently in the lab, but I will explain the problem as best as I can.

Currently, the muon detector does not detect any muons. Well, technically, it usually detects exactly one when it is reset or receives voltage. When we try and give the main PCB an artificial wave pulse, we do "detect" muons, but when the SiPM is put in place, it results in only the one detection.

When we used a multimeter on the VH going to the SiPM, it results in 29.66 V, which is in line with what it should. and so we thought it was a problem with the SiPM PCB.  We redid the SiPM to make sure it wasn't a problem with any of the components but it still results in the SiPM component heating up, which is probably not a good thing, and no detentions.

There was a point at which C6 was not populated correctly, but we didn't think that that was a major problem.

Another note is that we are currently lacking the Temp sensor as we were trying to keep the budget small but will order one if absolutely needed.

spenceraxani, 2019-05-06:
Hi,

Seeing only a single detection is an indication that there is a problem.

It sounds like you tested the Main board using a waveform generator and are seeing roughly the correct behavior. This should normally be checked by injecting a pulse that looks roughly like a SiPM pulse, and then checking test point 2 and 3 (TP2 and TP3). If these look good, then your problem is definitely with the SiPM PCB.

The SiPM should never be heating up. Could it be that the orientation of the SiPM is backwards (this is the biggest issue I tend to see)? The cathode of the SiPM (pin 1) should be connected to pad 1 on the SiPM PCB. A short on the resistor R12 could also cause issues. The simplest first step is to add new solder to each of the components on the SiPM PCB. The new flux in the solder will make sure you get a good connection.

Hopefully whatever caused the SiPM to heat up did not damage it.

C6 is an important component for the peak detector circuit (and thus the actually detection by the Arduino), but would not affect the SiPM performance or the Amplification circuit.

Thanks,

Spencer

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

Aquastar1017, 2019-05-06:
Hey again,

Just wanted to give you an update before this can be closed. We populated a new SiPM board with a new SiPM (wow they are expensive) and did an ohm check for the SiPM. We encased it to make it light resistant and were not actually expecting it to work and mostly as a last ditch effort.

It worked. We don't know how it is now working as we triple checked all of the components on the board especially R12. We can only guess that it was shorting somewhere and when we made a new board it fixed the issue.

spenceraxani, 2019-05-06:
Hi,

That’s interesting. I’m glad it worked out though.

Spencer

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

Closed 2019-05-06.

Thread 46 (2019-07-10):

Connection to Computer -- Connect and Disconnect

melloyellowblue, 2019-07-10:
Ok weird problem here:

My arduino keeps connecting and disconnecting from my computer as I try to do anything with it, especially if the SiPM is connected via the 6-pin connector.

From what I can gather from arduino webpages, this means that the current draw may be too high, but they were powering a servo, and this circuit shouldn't have too much draw.

[https://forum.arduino.cc/index.php?topic=496581.0](https://forum.arduino.cc/index.php?topic=496581.0)

I'm assuming from a lack of GitHub issues on the topic that people generally have not been having problems with this. I am using a genuine arduino nano from arduino.cc because I am basically 0-7 with the cheaper arduinos (terrible luck but I guess that's just how $5 arduinos work).

Any suggestions on how to fix this issue or what may be causing it? I am running Windows 10 if that helps.

spenceraxani, 2019-07-10:
Hi,

It’s strange that you had issues with the cheaper Arduinos. I’ve purchased ~300 of them, and ran into problems with roughly 1-3 of them. Could be an issue with the manufacturer, or potentially with your OS (I’m not very familiar with Windows). Are you able to load the Arduino sketch to it? You could start with the example sketch in the Arduino IDE called blink to make sure it’s working. Does the Arduino connection issue only occur on your computer? Can you plug it into a USB power bank, or different computer?

Like you suggested, my guess is that there might be a short somewhere. A USB power meter can be useful in determining if this is the case:
https://www.amazon.com/Soondar-Charging-Concurrent-Real-time-Smartphone/dp/B00ORNOWZK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 <https://www.amazon.com/Soondar-Charging-Concurrent-Real-time-Smartphone/dp/B00ORNOWZK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,aps,142&sr=8-12>

Could you also send me a photo of you PCB? I might be able to identify the problem. Sadly, if you are seeing issues with plugging in the SiPM PCB, the issue might be on that board.

Thanks,

Spencer

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

melloyellowblue, 2019-07-11:
Hello Spencer!
Here are the pictures of the PCB:

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

I don't think it's an issue with the SiPM PCB since this problem happens regardless of whether or not the PCB is plugged in. I am also having problems with the plugged in Arduino not being recognized by the computer (only when connected to the rest of the circuit), but that's a separate issue.

I am able to upload code to the arduino, but only when it's not connected to the actual board. This same issue happens on all computers I have tried, both windows and linux.

spenceraxani, 2019-07-11:
Hi,

One issues I can spot is that your temperature sensor is mounted backwards. I’m not sure what effect this has on the Arduino though.

The other potential issue (likely not) is that I cannot see the solder joints on the bottom of the board connecting the Arduino to the PCB. Your soldering looks particularly good on the other connections though — did you use reflow? While you are rotating the temperature sensor, it’s probably a good idea to check all the other connections by simply adding some extra solder to some of the suspect connections.

Thanks,

Spencer

> On Jul 11, 2019, at 10:09 AM, melloyellowblue <notifications@github.com> wrote:
>
> o uploa

melloyellowblue, 2019-07-11:
Hello!

I wanted to make sure I could still, in some capacity, connect to the arduino, so I intentionally have not soldered it to the PCB. I have found through making another PCB with a genuine arduino that it is impossible to connect and recover data directly to a computer, so I wanted to figure out the problem before I permanently attached the arduino to the board.

I will try switching the temperature sensor, and see if it has any effect.

Thanks for noticing the other joints! I did not use reflow soldering, just a combination of thinner solder (0.020") and getting too close to the PCB to be safe. Haven't gotten too many fumes in my lungs so far so ¯\_(ツ)_/¯. I found that it was pretty great with the smaller chip components.

melloyellowblue, 2019-07-11:
Update: Fixing the temperature sensor made everything work! I guess it might have been sending a negative voltage or something to V_out and causing the arduino to freak out. Thank you so much!

spenceraxani, 2019-07-11:
Glad to hear that you got it working!

Spencer

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

Closed 2019-07-11.

Thread 47 (2019-07-18):

In the voltage calibration results universal?

TienZhao, 2019-07-18:
Hi Spencer

I'm currently building my CosmicWatch and I wish to get some accurate voltage measures. Considering I'm using some cheap copies of Arduino Nano, should I carry out the calibration test again and make an ADC to voltage conversion function for my device? Looking forward to your advice.

Cheers,
Tien

spenceraxani, 2019-07-19:
Hi Tien,

The calibration is for the circuitry rather than the Arduino, so you don’t have to worry about it.

Thanks,

Spencer

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

TienZhao, 2019-08-12:
Hi Spencer

Thanks a lot for your reply. I'm making progress on it :)

Cheers,
Tien
------------------ 原始邮件 ------------------
发件人: "Spencer N. Axani"<notifications@github.com>;
发送时间: 2019年7月19日(星期五) 晚上11:25
收件人: "spenceraxani/CosmicWatch-Desktop-Muon-Detector-v2"<CosmicWatch-Desktop-Muon-Detector-v2@noreply.github.com>;
抄送: "Tien Zhao"<tienzhao@qq.com>;"Author"<author@noreply.github.com>;
主题: Re: [spenceraxani/CosmicWatch-Desktop-Muon-Detector-v2] In thevoltage calibration results universal? (#47)

Hi Tien,

 The calibration is for the circuitry rather than the Arduino, so you don’t have to worry about it.

 Thanks,

 Spencer

 > On Jul 18, 2019, at 12:22 AM, TienZhao <notifications@github.com> wrote:
 >
 > Hi Spencer
 >
 > I'm currently building my CosmicWatch and I wish to get some accurate voltage measures. Considering I'm using some cheap copies of Arduino Nano, should I carry out the calibration test again and make an ADC to voltage conversion function for my device? Looking forward to your advice.
 >
 > Cheers,
 > Tien
 >
 > —
 > You are receiving this because you are subscribed to this thread.
 > Reply to this email directly, view it on GitHub <https://github.com/spenceraxani/CosmicWatch-Desktop-Muon-Detector-v2/issues/47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>, or mute the thread <https://github.com/notifications/unsubscribe-auth/AANF5O3BISSE7O3BOYFWUJDP77VWZANCNFSM4IEW2BJA>.
 >

—
You are receiving this because you authored the thread.
Reply to this email directly, view it on GitHub, or mute the thread.

Thread 48 (2019-09-05):

overheating board

AbbeySiegel, 2019-09-05:
Hello, I'm having an issue where part U2 has been overheating. I have been able to create a full circuit that gets the correct voltage but after a couple minutes of running this part will overheat to the point where it burnt to the touch. Have you had this issue come up before? If so is there a way to fix it? I replaced the part itself and the issue continued to happen.

Thank you,
Abbey Siegel

spenceraxani, 2019-09-05:
Hi Abbey,

My best guess is that the op amp is mounted facing the wrong direction. Can you double check that pin1 is connected to the pad with the dot beside it? You can identify the side of the op amp with pin 1 by looking at the edge that has a bevel on it.

It definitely should not be generating any noticeable heat. You can also send me a photo of the board and I might be able to identify the issue.

Thanks,

Spencer

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

AbbeySiegel, 2019-09-05:
Here is a picture of the board. I’m going to try to flip around the op amp and see if that helps. Thank you!

Abbey Siegel

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

spenceraxani, 2019-09-05:
I’m not sure if the attached file worked.

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

AbbeySiegel, 2019-09-05:
I’ll try again. I don’t know why it wasn’t working the first time.

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

Thread 51 (2019-09-24):

Regarding calibration process

Rithishbarath, 2019-09-24:
Dear Axani
1. How to do the calibration part?

To determine the correlation between a measured ADC value from the peak detector circuit and the actual SiPM pulse amplitude, we begin with taking a screenshot of the SiPM output waveform, digitize it on a computer, and then program it into an arbitrary waveform generator. The waveform generator allows us to scale the voltage and inject it into the circuit through the BNC connection (without the SiPM PCB connected). The plot below shows the relationship between the amplitude of the injected pulse and the measured ADC value. In this image, at each point, we inject 200 pulses then calculate the standard deviation of the measured ADC values. We then fit the distribution according to a high-order polynomial. The result of the fit and the data is shown in Fig. 10. We use these results in the function “Calibrationfit” in the Arduino code.

Actually, my doubt is after going through this passage I find difficulty in digitizing it. How to get the screenshot of the SIPM output? Is there any software to digitize the output waveform? if so what is the name of the software? Is there a software which will generate the arbitrary waveform. Or do you have any standard waveform in the repository which we can directly use it? Does this calibration fit function has all these things worked out? or should we do this process for the detector we built? Is this process entirely different for each individual detector? Kindly give me a way out

2. At what temperature did you heat polish the scintillator?

3. Is there any Arduino script which can actually get both the sd card and OLED screen to function simultaneously?

Address these queries as soon as possible so that we can continue from this point

spenceraxani, 2019-09-24:
Hi,

(1) Just to clarify: you do not need to recalibrate once you build a detector. The calibration should be very close to the one provided if you use the same electronics described on the GitHub. If the electronics change (say, changing the gain on the detector), then recalibration is needed (if you want an accurate description of the SiPM pulse in mV).

If you still feel you need to recalibrate, there exists free software online for extracting (x,y) coordinates from a graph. For example, plotdigitizer allows you to input an image, define the scale on the axis, then point click the (x,y) coordinates you want.
http://plotdigitizer.sourceforge.net/ <http://plotdigitizer.sourceforge.net/>

The arbitrary waveform generate is a piece of hardware that lets you generate a specific voltage. These can be rather expensive though.

(2) We typically use the hottest temperature, with the lowest flow rate, on a soldering station. This tends to be somewhere around 450C.

(3) There exists Arduino code out there that has both the sd card and OLED scripts included. For example:

This code was made by someone else working on the project, however, I have not been able to test it yet.

Thanks,

Spencer

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

Rithishbarath, 2019-09-24:
Thank you for the clarification. Which file has this calibration or
so-called Arduino code in the repository?

Adding to that we are actually finding a way to measure the lifetime of the
muon from this experimental setup. My query is simple, is there a way to
measure the lifetime from the data provided by this detector?

On Tue, Sep 24, 2019 at 4:47 PM Spencer N. Axani <notifications@github.com>
wrote:

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

Rithishbarath, 2019-09-24:
Thank you soo much axani.This project seems to be an exciting one and its
really helping me to apply for graduate programmes at USA.The experience i
gained while trying to build this detector is a bliss.Thanking you.

On Tue, 24 Sep 2019, 5:02 pm Spencer N. Axani, <notifications@github.com>
wrote:

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

Rithishbarath, 2019-09-25:
Dear spencer,
                    Can you kindly let me know the drivers and Softwares
used to load this Arduino code into detector by windows 7?

On Tue, Sep 24, 2019 at 5:06 PM rithish barath <rithishbarath85@gmail.com>
wrote:

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

Thread 52 (2019-10-01):

Tips for the SiPM Module

rogerio-acioli, 2019-10-01:
Hi, Spencer!

I'm working to fix the SiPM Modules I assembled and I have some doubts. Maybe you can help me and more people:

1 - Which alumnium foil tape did you use at the module? Any specifications to share? I was using a default for domestic use, but it looks like too fragile.
2 - By studying the Sensl datasheet, I got wondering what would happened if we solder the pin 4. Do you have any tip about that. Why we don't use the pin 4 at the project?
3 - Is it possible to convert count to uSv/h?

Best regards, tks so much!
Rogério.

spenceraxani, 2019-10-01:
Hi,

I use just household tin foil and it seems to work fine. You might be able to find a heavier grade foil if you find it too fragile.

The Datasheet for the SiPM says that Pin4 should not be connected, but it also says that it can be connected to the PCB ground. We leave it floating particularly because it makes the SiPM easier to remove from the PCB if there are any problems.

You should be able to convert it to radiation dose detector, but I think you will need to make some assumptions on the sources of radiation.

Thanks,

Spencer

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

Thread 53 (2019-10-15):

HC4050 VDD Question

abehnke, 2019-10-15:
I noticed that on the schematic - circuit.pdf - pin 1 VDD of the HC4050 is connected to 5V.  Is that correct?  I would expect that VDD should be connected to 3.3V from the regulator.  With 5V for the HC4050, it would appear that the output logic levels from the HC4050 would be too high for the micro sd card. I found a similar circuit "micro sd card breakout board tutorial - Adafruit pdf" that shows 3.3V for pin 1 of the HC4050.  Thanks for this fine project.

spenceraxani, 2019-10-15:
Hi,

I think you are correct, good catch. It should be 3.3V rather than 5V. I’ve never ran into issues with the SDCard, so I hope it should be fine for now and add it to my list of updates.

Thanks,

Spencer

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

Thread 54 (2019-11-22):

Regarding arduino soldering and screen

Rithishbarath, 2019-11-22:
[1. Kindly tell me whether the screen is faulty by looking at the attached image because I cannot see all the details or problem with the Arduino board

2. You have left two pins unsoldered in the main PCB (ARDUINO NANO). Should we do that too or should I use those pins?

Thank you](url
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

)

metapulp, 2020-01-03:
Hello, I have made several of these boards. I actually do not even solder the Nano onto the main Cosmic Watch board anymore, because the pins are snug enough. I solder the full length of header pins to the Nanos though then just push the Nano into place. I had also asked Axani for what solder he used, which he posted elsewhere on Github. This was some time ago, but it solved my soldering problems.

spenceraxani, 2020-01-03:
Hi,

I would strongly recommend soldering the Nano to the board. Most of the pins are used, and if any of them are loose, or become loose, then the detector will not function properly.

I use this solder:
https://www.amazon.com/Kester-24-6337-0027-Solder-Alloy-Diameter/dp/B0149K4JTY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 <https://www.amazon.com/Kester-24-6337-0027-Solder-Alloy-Diameter/dp/B0149K4JTY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>

Thanks,

Spencer

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

spenceraxani, 2020-01-03:
Hi,

There definitely appears to be an issue with the screen. The two pins left unsoldered on my boards are simply to reuse those header pins for the SDCard PCB, but it is definitely not required to remove them.

My bet is that your screen is malfunctioning rather than the detector. I’ve gone through a few hundred screens and probably 10% of them have had some sort of problem (not this one though). The failure rate of the screen is definitely correlated with the cost of the screen; cheap ones from abroad have a much higher failure rate. I have been able to repair some of them though. If you look at the backside of the screen, there is a thick ribbon connection. I’ve found that sometimes the ribbon connection is not mounted properly on the screen’s PCB. This can be fixed using a hot air gun and repositioning the ribbon cable.

Hope this helps.

Thanks,

Spencer

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

vcbomba, 2020-01-04:
Good morning Spencer, Do you have a source for the CW Muon detector PC board? The GetHub site source listing didn’t respond. Looking to build ten devices. Wanting to share the build with several of my grandchildren.

Thank you,

Vince

Sent from my iPad

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

spenceraxani, 2020-01-04:
Hi Vince,

I typically use Elecrow.com for manufacturing the PCBs. I ordered some things from them the other day, so they should respond. You simply have to upload the PCB_Gerber_files.zip file from the Github repository:
https://github.com/spenceraxani/CosmicWatch-Desktop-Muon-Detector-v2/tree/master/PCB_Files <https://github.com/spenceraxani/CosmicWatch-Desktop-Muon-Detector-v2/tree/master/PCB_Files>

to this website:
https://www.elecrow.com/pcb-manufacturing.html <https://www.elecrow.com/pcb-manufacturing.html>

and select:
Different PCB Design = 10

Hope this helps.,

Spencer

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

vcbomba, 2020-01-05:
Spencer, I will do as you suggested. I appreciate the quick response.

Thank you,

Sent from my iPhone
Vincent C. Bombardier
Senior Construction Manager
Walmart Construction/Store Planning
Region 40 & 43
Mobile: 612-412-8400
Walmart Inc.

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

vcbomba, 2020-01-05:
Spencer, the Elecrow PCB site referencing the different PCB design goes from 1-9. 10 isn’t available. Please advise.
- board dimension is set to 100mmX100mm w/ 1.6 thickness 2 layer, HASL finish, no stencil or castellated holes.  Would this be correct?

Thank you,

Sent from my iPhone
Vincent C. Bombardier
Senior Construction Manager
Walmart Construction/Store Planning
Region 40 & 43
Mobile: 612-412-8400
Walmart Inc.

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

spenceraxani, 2020-01-05:
Hi,

The 1-9 refers to the number of different designs. We have a single 100mmx100mm design, so you’ll want to keep this at “1”. The number above that box, “5” in the attached image, is where you select how many PCBs you want manufactured. You were able to click on the “5” and select any increment you would like, however it looks like it is not working at the moment. It is likely a problem with their website.

I’ve email Elecrow to notify them of the problem. You could either order two sets of 5 now, or wait for them to fix the issue and select 10 (10 PCBs is actually normally the same cost as 5).

Thanks,

Spencer

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

Rithishbarath, 2020-01-10:
Which line of the code  should be changed so as to reduce the time difference in coincidence mode between master and slave counter? by default it is 30 microseconds.Which line of the code should be modified?

spenceraxani, 2020-01-10:
That’s a tricky one to see. Every command in the Arduino takes a certain number of clock cycles to complete. I read the analog pin3 as a timer for the coincidence:

      // Wait for ~8us
      analogRead(A3);

So if you wanted to add another 8us to the time window, I would have this line run again:

      // Wait for ~8us
      analogRead(A3);
	analogRead(A3);

Thanks,

Spencer

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

Rithishbarath, 2020-01-10:
Thanks spencer.Im actually bit confused with the kind of coupling compound
which i should use.Ive a picture of the compound.Kindly tell me wheather i
can use that as a coupling compound.

On Fri, 10 Jan 2020, 7:18 pm Spencer N. Axani, <notifications@github.com>
wrote:

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

spenceraxani, 2020-01-10:
Do you mean the that you are confused about the optical coupling? Something like this would be used for lab coupling:
https://www.ebay.com/itm/Silicone-Optical-Coupling-Compound-for-PMT-Photomultiplier-Scintillator-Detector-/261918290249 <https://www.ebay.com/itm/Silicone-Optical-Coupling-Compound-for-PMT-Photomultiplier-Scintillator-Detector-/261918290249>

I’ve also heard about using clear vaseline, however I haven’t tested it. I also do not see a picture attached to your previous message.

Spencer

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

Rithishbarath, 2020-01-10:
Dear spencer

Follow this link.Can i use this as a coupling  compound? Need your advice

https://www.amazon.com/Loctite-29329-30Cl-Glass-Bonding/dp/B00BWEOW84

On Fri, 10 Jan 2020, 7:53 pm Spencer N. Axani, <notifications@github.com>
wrote:

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

Thread 55 (2019-12-10):

BOM is out of date

stormyweathers, 2019-12-10:
SensL has been purchased by ON Semiconductor so the link for the SiPD is now broken.

The same model appears to be available from:

1. Arrow https://www.arrow.com/en/products/microfc-60035-smt-tr1/on-semiconductor $56.97
2. mouser https://www.mouser.com/ProductDetail/ON-Semiconductor/MICROFC-60035-SMT-TR1?qs=byeeYqUIh0MxSRIaBcfS6g%3D%3D $72.92
3. digikey https://www.digikey.com/product-detail/en/on-semiconductor/MICROFC-60035-SMT-TR1/MICROFC-60035-SMT-TR1OS-ND/9744774 $91.14

spenceraxani, 2019-12-10:
Hi,

Thanks for pointing out the links, I’ve been meaning to update the files recently.

Spencer

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

Thread 56 (2020-03-09):

led blinks but Not getting any signal in all the three dedicated pins.

AbidHussain70, 2020-03-09:
Hi, first wanna say thanks for such a beautiful and well documented project.
I follow all of your steps and exactly copy your work. I did all the troubleshooting, DC-DC booster working fine, OLED working, SD card, and led also works. The problem is, that when I attached the SiPM PCB + plastic scintillator on main board the led does start blinking, but I am not getting any pulse on BNC or any of the three pins dedicated for checking pulses. I am confused, on one side no pulse while on the other side the led blinks.
Can you help please.

Another thing I just missed one test, I did not check the plastic scintillator with torch. Which torch should we use for this purpose.
Looking for your answer thinks in advance.

spenceraxani, 2020-03-09:
Hello,

If you have measured the DC-DC booster output and are seeing 29.6V, but are not seeing any pulses on through the BNC connector, then it is an issue with the SiPM PCB. The most likely two candidates are that either the SiPM was mounted backwards, or perhaps the connection on one of the SiPM pins came loose while securing it to the scintillator.

Seeing blinking seems odd though. If it is rhythmic, then perhaps you have the wrong code uploaded? Although that wouldn’t explain why you don’t see pulses from the BNC connection. It could be triggering on noise or spurious signals from the SiPM PCB, which could look random and not like SiPM pulses, this could be explained by a broken connection on the SIPM pin. Sadly, I think you’ll have to unwrap your scintillator to check it.

Thanks,

Spencer

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

AbidHussain70, 2020-03-10:
Thank you for quick response.
 """"........ If you have measured the DC-DC booster output and are seeing 29.6V, but are not seeing any pulses on through the BNC connector, then it is an issue with the SiPM PCB. The most likely two candidates are that either the SiPM was mounted backwards, or perhaps the connection on one of the SiPM pins came loose while securing it to the scintillator......."""

Yes DC-DC booster output is giving 29.65V.
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
For the second part of your comment, I checked it several time. I solder 2 SiPM PCBs, but same problem.
Check the picture pin 1 of the SiPM has a small extra pin as you said in video 3 (https://youtu.be/yFgin5wlw4I).
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

And in the SiPM PCB pin one is labeled with small circle.
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

I solder the SiPM exactly in the same direction. And I also checked the resistance, in one direction it is giving some finite value (in Mega ohms) in other direction no value. Please check the pictures.

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

And from datasheet of the SiPM pin 1 is anode and pin 3 is cathode.

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

I check the voltage drop on anode and cathode pin of the SiPM. Which was working.

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

 """"........ Seeing blinking seems odd though. If it is rhythmic, then perhaps you have the wrong code uploaded? Although that wouldn’t explain why you don’t see pulses from the BNC connection. It could be triggering on noise or spurious signals from the SiPM PCB, which could look random and not like SiPM pulses, this could be explained by a broken connection on the SIPM pin. Sadly, I think you’ll have to unwrap your scintillator to check it..........."""""

 Blinking in rhythm, well I can not say anything about this, but it does blink, sometimes first and sometimes slow.  I upload OLED code from v2. I unwrap it, in fact I did unwrap it several time.

spenceraxani, 2020-03-10:
Hi,

It actually sounds like your detector is working. Could it be that the issue is with the oscilloscope? Perhaps the horizontal center if off-scope, or something like this? Just to ensure you are looking for the correct signal, it should be a positive pulse, 10s of mV in voltage, and order 500ns in width. When you use the OLED screen, what is the approximate count rate that you see?

I forgot to reply to your question about the scintillator. I use a hot air gun from a soldering station to melt the scintillator. This isn’t really needed. If you have a good optical surface between the SiPM and scintillator, improving the reflection on the sides won’t dramatically help collect photons.

Thanks,

Spencer

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

AbidHussain70, 2020-04-14:
Sorry I forgot to close the issue. The problem was with SiPM soldering. Though I did troubleshooting as you mentioned in your video and in the document, the SiPM circuit was showing same results. But due to the SiPM tiny pins, it became disconnected somehow during installation of SiPM circuit on main board.
I used Rosin Flux to fix the problem. Now the SiPM is solder properly and circuit is working fine.
Thank you.
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

.

Closed 2020-04-14.

Thread 57 (2020-04-16):

Schematic R4

Phoenix1747, 2020-04-16:
Hi, what exactly is R4 doing just before the pre-amp? Do you use it to minimize the input bias current?

spenceraxani, 2020-04-16:
Hi,

It’s actually for isolating the trace capacitance on the input to the op amp. Although, it’s not really doing its job perfectly, since I should have mounted it as close as possible to the pin on the op amp.

The value isn’t particularly important for this one, but I would recommend between 50 and 1k Ohms.

Thanks,

Spencer

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

Phoenix1747, 2020-04-16:
Ah I see, thanks!

Closed 2020-04-16.

Thread 58 (2020-06-24):

SIMP or scintillator  problem

mriosmar, 2020-06-24:
Hi.
I have a problem with the SIPM module of the detector. I have assembled the SIPM module and apparently everything is fine:
1) The voltage between the HV and GND pins is 29.3 V.
2) The chip is installed correctly (pin 1 at the circular mark)
3) The vontage between PIN 3 and PIN 1, when the circuit is on is 25.7V
4) I have reviewed connections and solder points and everything is OK.
5) The connection between BNC and SIPM module is ok too.
6) I have wrapped the scintillator as indicated in the instructions.
But only one event appears on the screen.

If I connect the oscilloscope to the BNC port I don't see any pulse and neither on TP1. This shows that the problem is in the SIPM module.

I have tried a second SIPM module that I have mounted and with the same scintillator (I only have one) and the same thing happens.

Could the scintillator not be working properly? Is there a way to verify the scintillator?

This is a bit desperate because I have dedicated tens of hours to the project and the detector does not work.

Thank you very much

spenceraxani, 2020-06-24:
Hi,

It sounds like you are correct in interpreting the problem as an issue with the SiPM board. If you see the correct voltage, but do not see anything coming out of the BNC, then the issue is somewhere on the SiPM PCB. Can you send me an image of the front and back? I might be able to tell you where the issue is.

Normally, I would have assumed that you have an issue with one of the SMT components on the SiPM PCB. But since you were able to get the DC-DC booster working (the hardest part of the soldering), and have completed two boards, I would say that it is unlikely the issue. Nevertheless, the most common issue is a non-properly soldered pad on one of the SMT components.

It’s unlikely to be an issue with the scintillator — unless it’s not actually scintillator. Sadly, the best way to see if the scintillator is working is to use a SiPM PCB that is known to work.

Could it be an issue with the oscilloscope? The pulses should be upwards going, maybe 10s of mV in height, and 100s of ns in width. These should come in at ~Hz frequencies.

Thanks,

Spencer

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

mriosmar, 2020-06-24:
Hi.

I have measured the resistance (at the solder points) between pins 1 and 3 of the SIPM and the values   are 13.6Mohms and in the opposite direction 3.4 Mohms. This shows that the solder points appear ok. I have added the photos.

On the oscilloscope I have used the 20 to 100 mV scale to detect the pulses and on the 0.5 microsecond scale and I see a noise of about 10mV in amplitude but no major pulse.

Also if I modify the variables SIGNAL_THRESHOLD = 1 and RESET_THRESHOLD = 1 in the arduino program I can see in the console the measurements it makes of pin A0 of the Arduino and this is what I get:

23:39:17.239 -> ### Comp_date Comp_time Event Ardn_time[ms] ADC[0-1023] SiPM[mV] Deadtime[ms] Temp[C] Name
23:39:17.339 -> ##########################################################################################
23:39:17.393 -> Rios
23:39:18.342 -> 1 37 352 66.89 73 24.01
23:39:20.397 -> 2 2059 3 11.36 2166 24.44
23:39:21.345 -> 3 3034 3 11.36 3173 24.01
23:39:22.400 -> 4 4078 1 11.97 4252 24.34
23:39:23.401 -> 5 5046 3 11.36 5253 24.34
23:39:24.350 -> 6 6047 3 11.36 6286 24.01
23:39:25.406 -> 7 7061 6 10.70 7334 24.01
23:39:26.409 -> 8 8091 3 11.36 8398 24.44
23:39:27.358 -> 9 9048 6 10.70 9388 24.34
23:39:28.414 -> 10 10068 6 10.70 10441 24.44

This shows that no pulse greater than 11mV appears in the SIPM which is consistent with what I receive by BNC on the oscilloscope.
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

I bought the scintillator at the recommended place in the shopping list:
https://www.ebay.es/itm/263355405917?ul_noapp=true

I think something very strange is happening and I am unable to see it so far.

Thank you very much

spenceraxani, 2020-06-25:
It’s a bit tough to say for sure, but the SiPM does appear to be offset compared to the outline on the PCB. If it is too far off, it will short the connection with the large middle pin on the SiPM. I do not know what effect this would have, the datasheet simply says that this pin should be left floating.

Your oscilloscope settings are good.

The first thing to try would be to disconnect the resistor R4 and look for pulses through the BNC out. This will ensure that the opamp downstream isn’t shorting the connection.

Since you do not see any pulses out of the BNC connector, the Arduino isn’t doing anything but providing power to the SiPM. There is a DC offset on the peak detector circuit, and setting the signal threshold to 1 puts the trigger below the waveform. You can see that the triggers occur every second, this is because the OLED screen is being updated.

Thanks,

Spencer

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

mriosmar, 2020-06-26:
Hi again.

I have fixed the position of the SIPM and I have ensured that it was well connected but I have not solved the problem.

Then I removed the R4 resistor to isolate the SIPM from the PCB but unfortunately I still don't get any pulse from the BNC port on the oscilloscope (with neither of the two SIPMs I have). I have checked the connectivity of the BNC port, the resistors and the SIPM. I wonder if any of the capacitors could fail. I have no way to verify it.

What role do capacitors C8, C9, C10, and C11 play in that circuit? Could this be the cause of the problem or does my question make no sense?

The other possible cause of the problem is the scintillator but I find it hard to believe that it could be the problem. It is the Bicron-BC408-Plastic-Scintillator bought on ebay.

My intention is to buy another scintillator to verify if it is the source of the problem but at the moment the seller does not send to Spain for the covid-19.

Do you have any idea to detect the source of the problem?

Thank you very much.

spenceraxani, 2020-06-26:
Hi,

The capacitors on the SiPM PCB are simply for filtering the power going to the SiPM (removing high-frequency noise on the 29.7V line). If any of them aren't connected, it shouldn't have a noticeable affect. However, if one of the is shorted (perhaps some solder is shorting the capacitor below the component)
, then you should expect problems.

You can check this by measuring the resistance on the header pins, see attached image. Between the outer and middle sets, you should 100Ohms and 49.9Ohms.

Can you attach images of the Main PCB? It would also be good to double check that you get 29.7V+/-0.4V powering the board. An image of the wrapped up scintillator would also be a good idea.

Thanks,

Spencer

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

mriosmar, 2020-06-27:
Hi.

I have checked the intermediate points of the SIPM PCB and they are ok: 49.9 Ohms and 100 Ohms.

I have soldered R4 again and verified the voltage supplying the SIPM PCB. I get 29.3V (could it be a little low and be the source problem?).

I've gone back to review connections and solder points with a magnifying glass and apparently everything is fine.

I have components to mount a second Main PCB. I am going to install it in the next few days to rule out the Main PCB as the source of the problem.

Thanks again

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

spenceraxani, 2020-06-27:
Actually, my point was that removing R4 disconnects the input signal from the Main PCB. This would eliminate any interference from downstream components, like the op amp.

I think the issue might be with the solder on the BNC connection. The pictures look like it’s not properly soldered to the board. The two smaller connection are used for the signal, and should be checked.

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

mriosmar, 2020-06-28:
Hi.

Eureka!!!

My detector works! This is what I see on the port monitor:
13:06:34.988 -> ### CosmicWatch: The Desktop Muon Detector
13:06:35.042 -> ### Questions? saxani@mit.edu
13:06:35.088 -> ### Comp_date Comp_time Event Ardn_time[ms] ADC[0-1023] SiPM[mV] Deadtime[ms] Temp[C] Name
13:06:35.189 -> ##########################################################################################
13:06:35.242 -> Rios
13:06:37.873 -> 1 1678 473 126.29 109 27.34
13:06:38.613 -> 2 2439 167 28.76 150 27.77
13:06:40.599 -> 3 4426 65 18.22 224 28.10
13:06:44.375 -> 4 8179 113 23.02 365 27.34
13:06:44.460 -> 5 8278 177 30.25 369 27.34
13:06:47.568 -> 6 11367 103 22.23 478 27.34
13:06:48.088 -> 7 11897 48 15.29 482 28.10
13:06:48.317 -> 8 12116 96 21.67 520 28.31
13:06:50.106 -> 9 13888 207 35.26 558 27.56
13:06:50.676 -> 10 14462 124 23.92 597 28.10

The problem was that the scintillator was wrapped with a single layer of black tape. I have wrapped it with three layers and they have started working.

Spencer, thank you very much for your responses.

spenceraxani, 2020-06-28:
That’s great! Glad to hear it.

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

Closed 2020-06-28.

Thread 59 (2020-07-19):

Incorrect Digikey Part Number in "Purchasing List.xlsx"

claudepi, 2020-07-19:
Hello,

I believe that Item # 15 in the Detector Purchasing List in "Purchasing List.xlsx" has the incorrect Digikey part number:

Item 15
10nF capacitor
4
$0.03
CAP CER 10000PF 50V X7R 0805
Digikey Part Number: 276-2563-1-ND

That comes up on Digikey as a 10 pF capacitor. I believe the correct item is a 10 nF capacitor with Digikey part number 311-1136-1-ND. Note that "SMT_reference.pdf" has the Digikey correct part number listed.

Thank you,
Seth

spenceraxani, 2020-07-20:
Hi Seth,

Thanks! I’ve updated the list.

Spencer

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

Closed 2020-07-29.

Thread 61 (2020-11-24):

Electronics Calibration

claudepi, 2020-11-24:
Hi Spencer,

First off, let me say thank you so much for putting together this wonderful project. It is very impressive and I have already learned so much (though I am still very much an electronics novice).

I am interested in doing an electronics calibration as you describe in Section 5.2 in Instructions.pdf. I do understand that this is not necessary - I simply want to do it as an exercise. After lots of trial and error and debugging, I have finally arrived at the result below, which is compared with the 11th order polynomial you show in the Instructions.pdf and that is coded in the Arduino software. Does this look reasonable? I ask because it is somewhat different from yours. My detector seems to be working fine, with reasonable rates and no other issues.

Thank you,
Seth

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

spenceraxani, 2020-11-24:
Hi Seth,

That’s looking pretty good if you ask me. The difference is likely due to the shape of the waveform that you inserted to do the calibration. You can get an eye for it by simply looking at the signal on an oscilloscope — when you see a 50mV pulse on the scope, does the detector readout 50mV?

I didn’t have a very good waveform generator, so it could even be that your calibration is better than mine.

Thanks,

Spencer

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

claudepi, 2020-12-01:
Hi Spencer,

Thanks for that suggestion. Indeed I do not get a 1-1 correspondence.

I plugged the detector into my scope via the BNC connection to measure the raw pulse from the SiPM. I made 15 measurements where I recorded the raw pulse amplitude on the scope and the corresponding pulse amplitude in the data readout (with my calibration coefficients used in the Arduino software to convert ADC to pulse amplitude):

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

These 15 values are plotted in the figure below in red with a best fit line. As you can see they do not lie on the 1-1 line. I also plotted (in green) what would be expected based on your calibration, i.e., using the ADC values from the readout and mapping those into a pulse amplitude using the 11th order fit from SDcard.ino. You can see that these are much closer to the 1-1 line (at least below ~300 mV), suggesting that something went awry in my calibration procedure. Back to the drawing board ....

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

Thanks,
Seth

claudepi, 2021-01-09:
Hello again,

After quite a bit of trial and error, I have figured out that there was indeed an issue with how I was scaling the reference pulse up and down with my arbitrary waveform generator. Now that I have fixed my procedure I believe I have a much better result (cal_run_final2), but it still looks a bit different from yours:

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

But when I do the same test as in my previous post (measure the amplitude of the reference pulse on my scope and compare it with the readout), I get a much better result with my new calibration (cal_run_final2):

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

So I think I am doing things correctly now. Though I am still curious/concerned that my result is different from your result. You mentioned above that it could be due to shape of the waveform that I inserted to do the calibration. Let me ask you a couple of questions in that regard:

(1) Did you use the same reference waveform for the entire range, scaling it up and down with your function generator to the desired input pulse amplitude?

(2) Did you have to periodically change the signal and reset thresholds to higher and lower values? I found that I had to change these (use lower thresholds at the lower end, and higher thresholds at the higher end) otherwise I wouldn’t get any counts.

I ask because in my calibration run above (cal_run_final2), I used a bunch of different reference waveforms. So I went back a did the same procedure, but using a single raw waveform for the entire range. And I did that for 3 separate reference waveforms (80 mV, 336 mV, 1320 mV) and compared the results:

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

There are some subtle differences, but they all lie reasonably close to one another. So I guess it doesn’t much matter, but I was just curious what you did.

Thanks again,
Seth

claudepi, 2021-05-23:
I wanted to provide an update here. Since my last post I built two new detectors because my other two died as noted in #63. I've done an electronics calibration for each of the two new detectors. They are slightly different from one another but similar to the ones I obtained above on the old (now dead) detectors. Here they are compared with the electronics calibration from Instructions.pdf:

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

(Note: my two new detectors are labeled "201" and "202").

To see the effect that these different calibrations have on the ADC and pulse amplitude spectra, I took ~24-hour runs of data on consecutive days. This figure compares data from my detectors when in coincidence mode where they both have the default calibration from Instructions.pdf:

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

The profiles shown are for the coincident secondary ("scnd") detector in the arrangement (the data were obtained on two consecutive days). You can see there is an offset between the two spectra when plotted versus ADC. Since both detectors use the same calibration, the spectra do not line up when plotted versus pulse amplitude.

However, when I make a similar comparison, but here using the electronics calibration that I have derived separately for each detector (i.e., the first figure in this post), the peaks line up much better when plotted versus pulse amplitude:

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

Perhaps this suggests that my calibration procedure and separate calibrations for each detector are correct/on the right track?

I do note that there are some small differences in the two spectra, particularly near ~40-60 mV. You noted somewhere (either here in the github or in one of the reference documents) that the shape of this peak is determined by how well the SiPM is coupled to the scintillator. So perhaps that coupling is different in the two detectors and explains the discrepancies between ~40-60 mV? I'd love to hear your thoughts about that.

I'll leave my calibration fit coefficients here in case they are useful to anyone:

"201 detector"
{-7.861644222315437e-27,  4.306401989118021e-23,
 -1.018937662726167e-19,  1.363249919743100e-16,
 -1.134365246184855e-13,  6.088163496534007e-11,
 -2.117955692271122e-08,  4.685141882190339e-06,
 -6.291123433458015e-04,  4.714795861579866e-02,
 -1.525151750121887e+00,  3.656490996599823e+01};

"202 detector"
{-6.098239192418842e-27,  3.491651162355342e-23,
 -8.636983165340803e-20,  1.208625158349717e-16,
 -1.052847733764935e-13,  5.924823493423876e-11,
 -2.166636100240393e-08,  5.058223765355062e-06,
 -7.214146629642136e-04,  5.796146568638363e-02,
 -2.102406534552599e+00,  4.574866345492077e+01};

spenceraxani, 2021-06-01:
Hi Seth,

Thanks for posting this rather large amount of work. I’m surprised by how much different our calibrations differ. I don’t have a great explanation for it. The best I can come up with is that we are surely using different waveforms to perform the calibration.

Looks like you are on the right track though. It’s interesting that after using separate calibrations for the two detectors, your MIP peaks appear to line up better. This may indicate that shifts observed in terms of ADC counts may be partially attributed to the electronics rather than efficiency differences (optical coupling, scintillator light yield, ect.). I’ll have to look into this more for the next set of detectors.

Thanks,

Spencer

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

claudepi, 2021-06-01:
Super thanks Spencer. I will close this and reopen if I find anything new.
--Seth

Closed 2021-06-01.

Thread 62 (2021-01-06):

Enclosure from enclosure&cases

cclores1, 2021-01-06:
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

From the enclosure readme file, you've suggested to use split body 2506- 2.9" from enclosure&cases;
however, from their website, the only have 2506-2.5" or 3008-3.0". In this case, should I choose 2506-2.5"and just trim the sides or 3008-3.0"?

spenceraxani, 2021-01-06:
Hi,

The last part of the number specifies the length of the case. They can cut it to any length, I’ve designed it for 2.9”, and 2.5” would be too small.

Thanks,

Spencer

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

Thread 63 (2021-02-10):

Arduino Failed

claudepi, 2021-02-10:
Hi Spencer,

Have you seen (or heard) about any issues with Arduinos failing when using pyserial?  Recently, I was evaluating how to make coincidence measurements with two detectors both recording data to the computer through the python script import_data.py. When running the script, I was having trouble getting both detectors to reboot within the 2 second window required to set them in coincidence mode. Sometimes they would start in coincidence mode and other times they wouldn’t. So I was playing around with trying to use software to reset both detectors/Arduinos once the serial connections were established, specifically by toggling DTR with setDTR in pyserial. At some point during this testing, one of my detectors stopped being recognized by the computer and would not power on.

When I opened it up, I observed that the POW LED on the Arduino was dimmer than usual and that none of the other 3 LEDs would not light at all (Tx, Rx, and L). I removed the SiPM+scintillator and tested the voltage going to it and got a very small value, ~1 V or less. I then tested between the 5V pin and the GND pin on the Arduino and got ~1.7 V, and I got the same result when testing the 3.3V pin. So it looks like there is some problem with the USB power on the Arduino. I was able to confirm this by successfully powering the Arduino on the 5V and GND pins from an external power supply. When powered this way, everything seemed to be working fine and I was able to measure 29.5V going to the SiPM+scintillator.

I googled a bit and found someone that had similar symptoms and they traced it to the Schotky diode (MBR0520LT1G) that is shown on the Arduino Nano schematic as the +5V Auto Selector. Unfortunately, that component is on the bottom of the Arduino and inaccessible, so it will not be possible to replace it without removing the Arduino from the main PCB. I guess it could be one of the other components on the bottom as well. As removing the Arduino from the main PCB seems essentially impossible, it looks like this detector is now bricked.

I am curious if you have ever seen or heard about behavior like this?  Once I build a new detector, I would like to find a way to reliably ensure that the detectors enter coincidence mode when establishing the serial connections in import_data.py (i.e., without having to manually press the reset buttons).  Any advice you have on this front would be greatly appreciated, as I am keen on being able to record coincidence data to the computer via the python script. And I'd like to not fry my next detector, so I am nervous about using the same approach (setDTR in pyserial).

Thanks,
Seth

spenceraxani, 2021-02-16:
Hi Seth,

I haven’t run into this issue before, and sadly do not have any information on the setDTR.

I think your troubleshooting indicates a short somewhere. If it was drawing too much current for some reason, I could see it not properly being able to go into coincidence mode, and I could also see it not turning on or being recognized by the computer. It would be strange to all-of-a-sudden develop a short though. Your USB port can only supply so much power, so maybe that is why your external power supply is working — it’s able to supply sufficient power for the short as well as the detector. When plugged in, you can touch the components on the detector to see if anything gets hot. If the short is in the diode under the Arduino, replacing it is going to be difficult. I would start by looking at the Arduino circuit to see if you can just add a new diode to the top of the board.

If you are going to replace the board, I would take a new PCB and simple transfer the components from the other board to it. This takes ~1hour. It’s simpler then trying to remove the Arduino, which is possible if you have a second person and a hot air gun, but may cause some damage to the board.

One way to test for a short is to use a USB power meter. It will tell you the voltage and amperage drawn by the detector. Typically, these detectors take ~0.27W to run (which is actually often too small of a power to measure, so I measure the power draw from two of them—0.54W, or 5V @0.1amps).

The detectors should almost always into coincidence mode if they are booted up at the same time. The following lines set up the coincidence:
  pinMode(3, OUTPUT);
  pinMode(6, INPUT);
  if (digitalRead(6) == HIGH) {
      SLAVE = 1;
      MASTER = 0;
      digitalWrite(3,HIGH);
      delay(1000);}

  else{
      delay(10);
      MASTER = 1;
      SLAVE = 0;
      pinMode(6, OUTPUT);
      digitalWrite(6, HIGH);}

If you removed the delay(10); line, it would probably always go into coincidence mode if they are booted up at the same time. You could also instead hardcode one of the detectors to MASTER =1; and the other to SLAVE = 1; and then the SLAVE would always be looking for coincidence signals no matter what.

Thanks,

Spencer

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

PaulHearn92, 2021-02-17:
Forgive me as this is off topic.
I'm a retired engineer in the UK and have a Radio Astronomy lab.  I'm looking at adding muon detection to my data flow.   It it possible to purchase a CosmicWatch-Desktop-Muon-Detector-v2 or a full kit of parts.  Again apologies for the interruption.
Paul.      [paul@hearn.org.uk]

claudepi, 2021-02-28:
Hi Spencer,

Thanks for all of the tips. A couple points of clarification on my original post:

- I was not having any issues with getting the two detectors to go into coincidence mode, in general. Specifically, I was able to place them in coincidence mode without any issues by manually pressing the reset buttons on the back of the detectors. What I was trying to troubleshoot was getting them to go into coincidence mode when running import_data.py. That was hit or miss, and I think it was related to the time it takes to loop through the various commands when setting up the serial ports. So that's what led me down the path of toggling the DTR (using pyserial commands) to reset the two detectors within the 2000 ms window using software commands (rather than manually pressing the reset buttons).
- I should have been more clear about my external power supply. It's not anything fancy, just a breadboard power supply that I use that I know supplies ~5V. Also, I misspoke in my original post: I successfully powered the detector and observed proper functionality with this external power supply when powering directly via the Vcc and GND pins on the arduino (not the "5V and GND pins" as I originally stated).

Since my original post I have also learned that the second detector involved in the above coincidence testing is suffering from similar issues. I did not notice this at first because I was focused on troubleshooting the first detector.  The issues are nearly identical to what's in my first post.

To answer a couple of your follow up questions:

- When powered, nothing on the top (accessible) part of the arduino seems to be getting hot. Ditto for the main/SDcard PCBs.
- Measuring the power draw with a USB power meter I find that one detector draws ~0.20 W (0.04A and 5.04V). When I power it with my breadboard power supply directly to Vcc and GND pins on the arduino (i.e., not through the mini-USB) I get essentially the same, ~0.19 W (0.04A and 4.95V). So I'm not sure that powering via the external supply is giving it more power that might help with a short.

Who knows what's going on and without knowing exactly what component is bad or where a potential short is, adding a new diode to the top of the arduino will be difficult (plus that’s probably beyond my current skill set). Thanks for the tips about potentially replacing the arduino and/or transferring the components to a new PCB but desoldering is also not my best skill.

It’s funny because on the very first detector that I built about 4 months ago, the arduino began to smoke immediately when I first powered it on (I am currently 0 for 3 on builds!). At that time I thought I must have soldered something incorrectly but now all of this makes me think that maybe I got a bad batch of arduinos. I’ve gone back and read a bunch of 1-star reviews for the Chinese clone arduinos on Amazon and have seen enough reports of similar things to make me nervous about these cheap clones, so I think I am going to suck it up and buy the real arduinos and start over.

Thanks again!
--Seth

spenceraxani, 2021-03-01:
Hi Seth,

I’ve probably purchased ~300 Nanos at this point and I should say that one set of x30 I bought through Ebay didn’t work. I don’t recall the problem with them, although I know they sit in my lab with a “broken” piece of tape attached to them.

If you have a spare Nano, perhaps you can play with it a bit while it is not soldered to the CW main PCB.

The import_data.py script does have some delay associated with setting up each detector. Are you plugging both detectors into the computer independently (two usb ports)? There is a line in the import_data.py, which waits for 1 second between setting up the independent detectors:

	line 219: time.sleep(1)

You could try decreasing this and seeing if that solves your problem. If you are not plugging in both detectors (the coincidence connection provides power to a second detector), then I don’t see this causing the issue.

Another option you could try, is to set up one of your detectors as the COINCIDENCE detector by hard coding it into the .ino file. This way, it would only ever record an event if it saw a coincidence pulse come in through the coincidence connection. You would then just have to remember which detector is your coincidence detector.

Hope this provides some help.

Thanks,

Spencer

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

claudepi, 2021-03-07:
Spencer,

Yes, I was plugging both detectors into the computer independently with two USB ports. Once I get my new detectors built, I will trying decreasing the sleep time to see if that helps.

And thanks for the tips about modifying the .ino code to hardcode one of the detectors as the coincident one.  That's probably going to be my best option going forward.

I'm going to close the issue - if I find out any new information I will add it here later.

Thanks again,
Seth

Closed 2021-03-07.

Thread 64 (2021-04-15):

SiPM Module seemly not working

wvols, 2021-04-15:
Hi,

I have built 3 detectors thus far and none of them seem to work. They all are giving off ~29.6 V but none are not giving off any counts at any normal rate.
90% of the time there are zero counts happening, sometimes when the detector is held and fiddled with it counts momentarily at an erratic rate (anywhere from 1-3 a second up to 10+ a second) then will stop again unexpectedly.

The boards have been reflowed/resoldered and checked the connections of all the parts with another much more experienced person to confirm I am not just inherently bad at it.

So, the thinking is there is something messed up in the SiPM module.
The resistivity test was done on all modules getting some resistivity one way and infinity the other way.
    How sensitive are the SiPMs when soldering? Like if you are heating the board/solder/SiPM for more than a couple of seconds
       will the device bust easily?
    There seems to be no difference/nothing discernable at all when analyzing the pulses on an oscilloscope with it mostly being noise at all test points. Using covered with scintillator and uncovered with no scintillator.

Jumper cables were used to try and isolate a connection problem and it had no effect.
Sometimes pulses are counted even with the SiPM module disconnected and running a finger over the SiPM connector.

Is it okay to remove/replace the SiPM when the base circuit board is turned on? Different combinations of SiPM modules and baseboards have been tried.

Two of the three detectors when booted up will give off a single count then nothing from there.
On a separate note, another (maybe uncorrelated?) problem is one detector has a slow refresh rate and will skip a second on the OLED about every other second.

Has anyone else had this problem?
What would you suggest I try to do to fix it? Is there another way to isolate the SiPM to confirm it is working?

Thanks for creating this project it has captured my interest and I am eager to get it working.

spenceraxani, 2021-04-15:
Hi,

Thanks for the detailed description of your problem. Since the DC-DC booster appears to be working, and you do not see a signal out of the BNC connection (you mentioned the test points, but I’m assuming you also tried the BNC directly), the issue is likely with the SiPM+scintillator module.

If this is the case, then the most likely cause is a poor connection on the SiPM, or the SiPM is orientated incorrectly. The module itself is rather robust, and I wouldn’t worry about overheating it. Since you mentioned that you are worried about the heat, my bet is that you ended up with a cold solder joint on the SiPM that disconnected when interfacing it with the scintillator. I would start there, along with double checking the solder connections on the resistors and capacitors on the SiPM PCB board. The erratic counting, I would say, is also an indication that you have a poor connection on the SiPM.

The other thing to double check is that the orientation of the SiPM is correct. Can you double check that the SiPM Pin1 is correctly positioned with pad 1 on the board?

I wouldn’t worry about the rest of the board until you see pulses out of the BNC connection. But if you see pulses, and the boards still don’t work, feel free to send me pictures of the boards.

Regarding the slow refresh rate on one of the detectors; I have seen this before on one of the more recent detectors I built, although I didn’t dig into it to figure out if it was related to the OLED or the Arduino. I found that it was only noticeable when the detector booted up and didn’t affect the performance. Could try changing the OLED screen. I set the refresh rate on all detectors to 1Hz anyways, while running.

I would turn off the detector before switching SiPM modules.

Thanks,

Spencer

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

RebekahSebok, 2022-03-26:
Hi Spencer,

We are having the same issues as described by wvols. We have so far built two of the SiPM boards and neither are registering any counts. We have the correct voltage at the 6-pin connection and the sensor passes the resistance test shown in your video, but the BNC connection doesn't show any pulses. We have reflowed the solder connections and we are sure that pin 1 is placed correctly for the SiPM. Do you have any suggestions for narrowing down where our issue may be?

Thank you,

Rebekah

spenceraxani, 2022-03-27:
Hi Rebekah,

Since you have the correct voltage being supplied to the SiPM, when it is interfaced with scintillator and made light tight, you should see pulses out of the BNC. Assuming you setup your oscilloscope correctly, the possible causes are:

1. The SiPM is not correctly mounted. This is likely your issue since you mentioned that the sensor does not pass the resistance tests. Note that the resistance tests requires some light. Not passing this test either means that your SiPM is either rotated (recheck the pin orientation), or that the solder connection is not adequate. Since you mentioned that you think you have the correct orientation, the issue is likely that you need to improve the solder connection.

2. There is a light leak. If you have a large amount of photons entering the scintilator because of a light leak, then the SiPM will not register individual pulses.

3. Your BNC is not soldered. Simply check the solder connection on the BNC connector.

4. The resistors on the SiPM PCB going to pin 3 are not mounted, or disconnected. This would be fixed by improving the solder connection.

Thanks,

Spencer

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

RebekahSebok, 2022-03-30:
Hi Spencer,

Thank you for your quick reply! We touched up all of the connections on the SiPM board and went through with a multimeter to make sure there were no shorts and then we re-wrapped the whole SiPM assembly and put it in a small cardboard box. We realized that only one of our main boards worked, but combined with the re-done SiPM assembly we have a fully functioning detector.

Thanks for your advice,

Rebekah

Thread 66 (2021-07-07):

Unable to upload Arduino Code to Arduino Nano Every

Draconum, 2021-07-07:
Hi,

I am using an Arduino Nano Every and whenever I attempt to upload the code up to it, it displays the message 'ADSCRA was not declared in this scope".  I've downloaded all the drivers required and they all seem to function and I've copied and pasted the code as provided however this issue still persists. Does the fact that the Arduino Nano Every is classified as Ardunio megaAVR board affect this?

Also, I'm able to upload the Name file, just not the OLED.

Thanks!

spenceraxani, 2021-07-07:
Hi,

I haven’t used the Every board, so I don’t think I can say too much about this error. The lines of code related to “ADCSRA” are modifying the prescaler to increase the ADC sampling rate (~10us/sample). This would be a necessary update to the code that you’ll need to implement. Without it, the default sampling rate it too slow and you’ll end up missing many pulses or perhaps trigger on the tails of pulses.

I’m not sure how to implement it on the Every board, but it should be possible with a bit of digging online.

Thanks,

Spencer

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

Closed 2021-07-09.

Thread 67 (2021-07-12):

OLED Screen no longer counting and LED not flashing

Draconum, 2021-07-12:
Hi Spencer,

We had a functioning Cosmicwatch detector built a year ago and the LED light and OLED screen are no longer registering muons with energies above the threshold as recorded on an oscilloscope. With the test points, TP1 seems to be similar to the Raw SiPM pulse, however, TP2 just exhibits the amplified Raw SiPM pulse as expected and TP3 shows a continuous pulse of 10mV but not the expected width or height.

 We have made sure that the legs of the op amp and the DC-DC booster are well soldered and have gone through the rest of the troubleshooting. We currently think that the issue is with the amplifying circuit and wondered what else could be causing this.

Thank you!

Draconum, 2021-08-10:
The voltage on the DC-DC Booster appears as negligible or 0.4V even though we have double-checked all connections on op-amp and the signal on the oscillope is shown below:
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

spenceraxani, 2021-08-11:
Hi,

If you aren’t able to see ~29.6V between the HV and GND pins on the 6-pin header, then this problem lies in the part of the circuit labelled DC-DC booster. I have run into situations where I’ve needed to replace the IC (LT3461) as well as the inductor. But, 90% of the time, the problem is with a connection problem on one of the legs of the IC. The op-amp (LT1801) is completely independent of this part of the electronics. The DC-DC booster problem needs to be solved before troubleshooting anything downstream.

If you do indeed not measure the correct voltage on the HV pin, then no signals will be present from the SiPM (BNC and TP1). Once you get the booster solved, feel free to let me know if you are still running into problems with TP2.

Thanks,

Spencer

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

Closed 2021-08-24.

Thread 68 (2021-09-01):

[REQUEST] PCB CAD sources

Blaster1920, 2021-09-01:
Hi,
I'm very interested in replicating this project, is there any chance you could upload the source files of the PCB and Schematics?
I'd like to apport some modifications and it would make it much faster.
Best

PaulHearn92, 2021-09-02:
Thanks Blaster1920, I too have the same questions. And..
Do we know how many CosmicWatch detectors are operating, And..
Is there a project to capture all the data, And...
Can a kit of parts be purchased for v2.

Blaster1920, 2021-09-02:
Interesting questions.
I would have the ability to produce several PCB kits, if I can modify the
PCB to use, perhaps, an esp32 which can be easily connected to the wifi and
synced over.

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

spenceraxani, 2021-09-02:
Hi Paul,

My guess is that there are approximately 1,000 detectors in operation. I’ve built ~300-400 myself, and then have probably spoken to several hundred (maybe thousand) people building them.

Eventually, the plan is to release a new version of the detector, with an updated website that logs the location and rate. The pandemic has slowed this down. Normally, I would bring in a few undergraduates to supply kits to younger students or people in nations that cannot afford the detector components. But, in general, kits are not available for purchase.

Thanks,

Spencer

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

spenceraxani, 2021-09-02:
Hi Jacopo,

Would you be able to contact me through my email ***@***.***), to let me know what you would like to do?

I’m hesitant to provide the source files for the PCB design. Although I understand why some people may be interested in updating the microcontroller (I have other version that run on the ESP32, ESP8266, Teensy 3.6, and Teensy 4.0), the issue lies with project maintenance. Providing technical support to people building detectors is actually rather time consuming (several hours per day on average). Introducing another version (or modifications) complicates this. I’ve run into this issue many times with the previous versions of the detectors.

Thanks,

Spencer

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

Blaster1920, 2021-09-02:
I sent you an email on the public address you've got on your github.

Il giorno gio 2 set 2021 alle ore 13:38 Spencer N. Axani <
***@***.***> ha scritto:

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

Thread 69 (2021-09-25):

pcb component numbers (R1, R2 etc)

PaulHearn92, 2021-09-25:
Is there a document showing pcb component numbers (R1, R2 etc) with the component values.   Maybe I'm just missing it, but it would be very useful.
Paul Hearn.

spenceraxani, 2021-09-25:
Hi Paul,

You bet, you can find it in the SMT_reference.pdf document located in the PCB_files/ folder.

Thanks,

Spencer

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

PaulHearn92, 2021-09-25:
Many thanks for swift response - fantastic..!!

Thread 70 (2021-11-09):

CosmicWatch .ino files

PaulHearn92, 2021-11-09:
Has anyone re-worked the SDCard.ino file to give a record for the counts/n minutes rather than a time-stamped record for each event.   In an ideal world both are needed.
Paul Hearn [paul@hearn.org.uk].

spenceraxani, 2021-11-10:
Hi Paul,

From the time-stamped output you can calculate the rate. There’s an example iPython notebook showing how to do this in the Recording_data/Example_plots/ directory.

If you are planning on modifying the Arduino code to output counts/n minutes, ensure that you subtract out the detector deadtime from the realtime.

Thanks,

Spencer

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

PaulHearn92, 2021-11-11:
Thanks Spencer, I hadn’t spotted that one…..

Paul

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

Thread 71 (2021-12-15):

SiMP PCB Reflective surface

Airbasti, 2021-12-15:
Hello,
i am currently in the process of building two of the detectors. The PCBs just arrived and i have noticed that the SiPM PCB does not have a reflective surface around the point where the SiPM is placed. Is this a failure by JLC PCB or did i send the wrong code or will the reflective surface be added by me later?
Thank you in advance
Sebastian

P.S
Does anyone have experience with homemade optical gel? It seems to be out of stock everywhere at the moment

spenceraxani, 2021-12-15:
Hi,

It looks like the PCB Gerber files for the ‘PCB_Gerber_files_wLargerSnapOffConnectors.zip’ were missing the reflective plane. The detector will still work fine without it. The scintillator is surrounded by an aluminium foil to help with reflection. Not having the reflective plane probably means that you lose a few percent of photons — which is insignificant.

Thanks,

Spencer

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

Airbasti, 2021-12-16:
Hello,
thank you for the quick advice. Do you think surrounding the SiPM by aluminium foil (hence just making the left out square of the scinti wrapping smaller) will result in similar results or will this cause other problems? I really want to as good results as possible.

PaulHearn92, 2021-12-16:
In answer to the optical gel question, I think Silicon grease will work.  It has a refractive index of 1.465.  We at UKRAA are testing this and the ‘no grease’ option.  So far we have built 6 all with optical gel, our interface tests will be done on the next batch of 10, however there looks like a delay in the SiPM’s. I would be interested in Spencer’s take on this.

Paul Hearn (UKRAA)

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

spenceraxani, 2021-12-26:
Hi Paul,

Apologies for the late reply. The optical contact should not have any noticeable timing effect on the signal from the SiPM. The only conceivable delay that I could imagine, would be the result of an extra reflection off the interface surface, which would only amount to <<100ps delay in a fraction of the photons. This is much shorter than the rise time of the SiPM (~1ns), so it wouldn’t be possible to extract this delay. Perhaps something else is going on? How are you observing a delay?

The optical grease, however, does have a large impact on the efficiency of the detector to collect photons. Without it, there is an air gap (n = 1). The change in the refractive index will cause some photons that would have been absorbed by the SiPM to be reflected back in to the bulk material of the scintillator. I typically use optical gel, but I have been told by one of my colleagues that vaseline or petroleum jelly has a similar index of refraction (n = 1.45 - 1.48) to scintillator and can work well.

Thanks,

Spencer

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

PaulHearn92, 2021-12-27:
Hi Spencer,

Your answer is far more interesting than my question, many thanks for the information.

My comment regarding delay was referring to the delivery time, we have been quoted about 10 weeks.

Best wishes and have a great 2022,

Paul.

Paul Hearn

¦¦¦  British Astronomical Association  ¦¦  Radio Astronomy Section  ¦¦

Burlington house, Piccadilly, W1J 0DU

 <https://britastro.org/section_front/24> https://britastro.org/section_front/24

 <https://www.youtube.com/user/britishastronomical/playlists> https://www.youtube.com/user/britishastronomical/playlists

e      ***@***.***> ***@***.***

a     RG6 1BU UK

t     +44 (0)7967 388 578

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

spenceraxani, 2021-12-27:
Hi Paul,

Aha, I see, my mistake. There was an expected delivery date of Dec. 15th 2021, although it now looks like it’s been pushed back to Feb. 11th 2022. Hopefully they aren’t delayed again. We’re also waiting on SiPMs for various projects.

Thanks,

Spencer

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

Thread 72 (2022-01-04):

Existing coincidence data sets for exercices

mtetrault, 2022-01-04:
Hi,

I'm preparing basic training exercices/homework on simple data analysis where we will eventually have CosmicWatch units assembled and generating the data to process. In the meantime I'm hoping to use public or loaned data sets from coincidence experiments, for example to reproduce figure 13 in the reference paper (https://github.com/spenceraxani/CosmicWatch-Desktop-Muon-Detector-v2/blob/master/ThePhysicsPaper.pdf).  jgOhYeah was kind enough to share some files, however I'm having issues associating the coincidences post-acquisition based on the timestamps. After discussions, I assume my issue there is that the clocks between the two arduinos drift apart, and so far I'm unsucessful in finding a workaround.

The paper mentions a customized Arduino code to directly tag coincidence/non-coincidence data. Based on figure 13, am I correct to assume the tagging is back-annotated to the master data? Is the raw data for this figure available somewhere in CSV form?

Thanks!

spenceraxani, 2022-01-04:
Hi,

You bet, here is the data:

The one thing to keep in mind, is that this file has an extra column (the final column) that labels coincident events with a ‘1’ and non-coincident events with a ‘0’. That is, the default Arduino code was modified to spit out this extra bit of information. Normally, two detectors are connected in coincidence, the coincidence detector will create a file with the prefix label ’S’ indicating that it is only saving the coincidence detections.

You are correct in that the clocks on the two detectors will drift apart over time. If two detectors are connected via the coincidence cable, coincident events are tagged through a digital signal, rather than the time stamp. However, if the data was taken using the import_data.py python script via a computer, the computer will add a global time stamp to each event that is accurate to within ~5ms.

Feel free to let me know if this does not answer your question fully.

Thanks,

Spencer

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

##########################################################################################
### CosmicWatch: The Desktop Muon Detector
### Questions? ***@***.***
### Comp_date Comp_time Event Ardn_time[ms] ADC[0-1023] SiPM[mV] Deadtime[ms] Temp[C] Name
##########################################################################################
Device ID: Billy
0 655 492 134.92 0 19.61 0
1 2064 359 69.86 113 19.61 1
2 2301 307 54.48 227 19.61 1
2 3719 67 18.51 348 19.61 0
2 5283 435 104.92 463 19.61 0
2 5749 56 16.76 590 19.39 0
2 7788 176 30.09 710 19.61 0
2 7964 71 19.06 827 19.61 0
3 8558 271 46.93 946 19.61 1
3 11081 204 34.73 1069 19.61 0
4 11486 271 46.93 1191 19.61 1
4 12879 71 19.06 1312 19.61 0
4 15146 56 16.76 1432 19.61 0
4 16548 216 36.85 1556 19.61 0
4 17253 179 30.55 1677 19.61 0
4 18463 96 21.67 1797 19.61 0
5 18912 643 246.01 1920 19.61 1
5 19259 391 82.35 2040 19.61 0
5 21594 88 20.96 2159 19.61 0
6 22176 350 66.46 2278 19.61 1
7 23206 295 51.75 2400 19.61 1
7 23346 71 19.06 2520 19.61 0
7 23495 199 33.86 2644 19.61 0
7 25125 103 22.23 2767 19.61 0
8 25507 270 46.71 2887 19.61 1
8 25728 184 31.36 3005 19.61 0
9 27982 419 97.20 3127 19.61 1
10 28710 364 71.71 3244 19.61 1
11 30545 275 47.73 3360 19.61 1
11 30851 49 15.48 3479 19.61 0
11 31839 327 59.28 3598 19.61 0
11 32067 176 30.09 3716 19.61 0
12 32253 323 58.48 3834 19.61 1
13 33536 192 32.67 3956 19.18 1
13 37197 88 20.96 4073 18.32 0
13 37751 433 104.37 4194 18.00 0
13 37899 159 27.66 4314 18.32 0
14 38774 319 57.64 4436 18.32 1
15 39677 409 91.12 4555 18.00 1
16 40345 248 42.69 4676 18.32 1
17 41352 263 45.37 4801 18.00 1
17 44365 158 27.53 4920 18.32 0
17 44748 231 39.55 5040 18.96 0
18 45918 204 34.73 5160 19.18 1
18 46224 286 49.78 5283 19.18 0
18 47855 51 15.86 5402 19.18 0
18 49802 198 33.69 5522 18.86 0
18 53954 60 17.43 5648 19.18 0
19 54335 334 61.44 5766 19.18 1
19 54508 88 20.96 5887 19.61 0
19 58552 192 32.67 6005 19.61 0
19 58733 78 19.92 6127 19.39 0
19 59908 103 22.23 6244 19.39 0
19 60263 56 16.76 6372 19.61 0
20 61292 455 117.03 6494 19.61 1
20 63212 284 49.41 6611 19.39 0
20 63684 127 24.18 6728 19.61 0
21 64003 147 26.19 6848 19.18 1
22 64327 332 61.17 6965 19.18 1
23 65047 255 43.96 7085 19.18 1
24 65173 275 47.73 7206 19.61 1
24 65722 684 283.21 7330 19.61 0
24 66023 71 19.06 7450 19.61 0
24 66190 248 42.69 7570 19.61 0
24 67431 193 32.84 7694 19.18 0
24 67984 110 22.78 7814 19.61 0
24 68420 71 19.06 7934 19.39 0
25 69546 304 53.73 8054 19.61 1
25 70675 216 36.85 8176 19.61 0
25 70912 166 28.62 8299 19.18 0
26 72266 335 61.77 8423 19.61 1
27 72862 275 47.73 8545 19.61 1
27 73061 63 17.91 8668 19.39 0
27 73591 60 17.43 8794 19.61 0
27 75879 108 22.63 8917 19.61 0
28 78425 231 39.55 9042 19.61 1
28 80412 56 16.76 9163 19.61 0
29 82167 377 76.28 9286 19.61 1
30 82493 454 115.28 9406 19.61 1
31 82846 399 87.30 9527 19.61 1
31 83137 97 21.75 9649 19.61 0
32 84973 304 53.73 9768 19.61 1
32 89198 49 15.48 9890 19.61 0
32 91549 56 16.76 10014 19.61 0
32 92274 94 21.50 10141 19.61 0
32 94225 227 38.83 10265 19.61 0
32 97600 56 16.76 10390 19.61 0
33 99075 625 226.08 10512 19.61 1
33 99704 120 23.58 10635 19.61 0
33 100814 49 15.48 10761 19.61 0
33 103202 99 21.91 10883 19.61 0
33 104748 174 29.79 11008 19.61 0
34 105070 255 43.96 11131 19.61 1
35 106584 440 109.25 11256 19.61 1
35 108830 62 17.75 11378 19.61 0
35 109830 199 33.86 11500 19.61 0
35 110041 127 24.18 11625 19.61 0
35 112783 432 101.61 11747 19.61 0
36 113186 368 72.93 11878 19.61 1
36 114697 89 21.05 12004 19.61 0
36 114890 332 61.17 12129 19.61 0
37 117755 415 95.00 12250 19.61 1
37 120623 63 17.91 12372 19.61 0
37 121837 176 30.09 12492 19.61 0
37 122157 207 35.26 12613 19.61 0
37 122749 60 17.43 12735 19.61 0
38 124155 364 71.71 12854 19.61 1
38 124370 238 40.82 12977 19.61 0
38 128379 435 104.92 13098 19.61 0
38 128690 51 15.86 13221 19.61 0
39 128882 448 112.41 13344 19.61 1
39 129703 268 46.26 13468 19.61 0
40 130179 56 16.76 13593 19.61 1
40 130756 231 39.55 13720 19.61 0
41 132808 295 51.75 13860 19.61 1
41 133029 113 23.02 13981 19.61 0
41 133548 112 22.94 14102 19.61 0
42 134316 243 41.74 14226 19.61 1
43 135379 273 47.25 14347 19.61 1
43 136357 358 69.10 14468 19.61 0
44 139081 339 62.98 14591 19.61 1
45 141278 432 101.61 14711 19.61 1
46 141474 433 104.37 14832 19.61 1
46 141642 153 26.90 14954 19.61 0
46 141845 56 16.76 15079 19.61 0
47 142126 399 87.30 15200 19.61 1
48 143185 345 64.98 15319 19.61 1
48 143784 51 15.86 15441 19.61 0
48 144725 270 46.71 15560 19.61 0
49 145116 399 87.30 15675 19.61 1
49 148751 220 37.58 15795 19.61 0
50 149031 396 85.28 15916 19.61 1
50 149692 97 21.75 16033 19.61 0
51 150188 334 61.44 16150 19.61 1
52 151750 326 59.13 16271 19.61 1
53 152143 440 109.25 16391 19.61 1
53 152374 188 32.01 16512 19.61 0
53 152817 262 45.24 16634 19.61 0
54 153055 422 97.97 16758 19.61 1
54 155061 344 64.67 16880 19.61 0
54 157369 344 64.67 17001 19.61 0
54 157508 76 19.69 17124 19.61 0
55 159125 480 130.21 17245 19.61 1
56 160794 332 61.17 17369 19.61 1
57 161710 327 59.28 17493 19.61 1
58 162047 371 73.82 17610 19.61 1
59 163275 368 72.93 17729 19.61 1
60 163745 231 39.55 17849 19.61 1
61 166533 384 80.08 17972 19.61 1
62 167008 305 53.88 18093 19.61 1
62 168229 192 32.67 18213 19.61 0
62 168869 103 22.23 18337 19.61 0
63 171059 371 73.82 18454 19.61 1
64 172290 415 95.00 18572 19.61 1
65 173618 304 53.73 18690 19.61 1
65 173996 384 80.08 18812 19.61 0
65 174339 184 31.36 18929 19.61 0
66 177856 262 45.24 19047 19.61 1
66 178206 323 58.48 19171 19.61 0
66 179099 92 21.32 19289 19.61 0
66 179667 199 33.86 19409 19.61 0
67 180981 291 50.97 19530 19.61 1
67 181336 158 27.53 19655 19.61 0
68 181887 56 16.76 19775 19.61 1
69 182789 319 57.64 19896 19.61 1
69 183625 96 21.67 20019 19.61 0
69 183866 71 19.06 20139 19.61 0
69 184910 129 24.35 20260 19.61 0
69 186568 207 35.26 20380 19.61 0
69 188289 152 26.78 20503 19.61 0
69 189423 312 55.68 20623 19.61 0
69 190550 88 20.96 20742 19.61 0
70 193629 440 109.25 20865 19.61 1
70 197230 284 49.41 20997 19.61 0
71 197812 319 57.64 21118 19.61 1
71 198781 56 16.76 21241 19.61 0
72 199471 384 80.08 21360 19.61 1
72 200088 270 46.71 21478 19.61 0
72 201356 103 22.23 21601 19.61 0
72 202658 103 22.23 21717 19.61 0
72 202887 115 23.18 21836 19.61 0
73 205867 270 46.71 21953 19.61 1
73 206099 127 24.18 22074 19.61 0
73 206668 65 18.22 22192 19.61 0
73 207536 236 40.44 22310 19.61 0
73 211304 305 53.88 22435 19.61 0
73 212432 255 43.96 22554 19.61 0
74 213470 422 97.97 22678 19.61 1
74 213860 286 49.78 22808 19.61 0
74 216085 79 20.03 22932 19.61 0
74 216700 134 24.82 23055 19.61 0
75 217513 231 39.55 23181 19.61 1
75 223350 255 43.96 23304 19.61 0
75 223870 63 17.91 23429 19.61 0
76 226434 124 23.92 23552 19.61 1
76 228241 79 20.03 23677 19.61 0
77 229415 51 15.86 23799 19.61 1
77 229671 112 22.94 23921 19.61 0
77 233094 195 33.17 24048 19.61 0
77 233460 255 43.96 24171 19.61 0
77 233680 71 19.06 24298 19.61 0
77 235068 380 78.12 24424 19.61 0
78 235818 480 130.21 24552 19.61 1
78 235972 158 27.53 24672 19.61 0
78 237070 92 21.32 24795 19.61 0
78 237752 110 22.78 24916 19.61 0
79 241269 387 81.05 25035 19.61 1
79 242536 96 21.67 25158 19.61 0
80 242953 142 25.64 25278 19.61 1
81 243637 371 73.82 25400 19.61 1
81 244695 99 21.91 25522 19.61 0
82 244903 243 41.74 25648 19.61 1
82 245377 193 32.84 25770 19.61 0
82 248903 63 17.91 25892 19.61 0
82 253632 211 35.96 26018 19.61 0
82 254482 51 15.86 26141 19.61 0
82 254849 103 22.23 26271 19.61 0
82 255573 295 51.75 26396 19.61 0
82 255733 63 17.91 26522 19.61 0
83 258731 263 45.37 26644 19.61 1
83 258866 63 17.91 26769 19.61 0
83 260566 184 31.36 26891 19.61 0
83 262836 76 19.69 27012 19.61 0
84 263905 287 50.23 27138 19.61 1
84 264434 120 23.58 27261 19.61 0
84 266554 224 38.29 27387 19.61 0
84 273181 163 28.20 27509 19.61 0
84 273524 108 22.63 27632 19.61 0
84 274373 206 35.07 27752 19.61 0
85 274944 270 46.71 27872 19.61 1
85 276043 71 19.06 27996 19.61 0
85 277148 120 23.58 28127 19.61 0
86 278287 359 69.86 28244 19.61 1
86 278966 254 43.77 28359 19.61 0
86 280617 60 17.43 28474 19.61 0
86 282255 83 20.46 28589 19.61 0
87 284414 428 101.58 28708 19.61 1
87 285564 214 36.49 28823 19.61 0
88 286278 316 56.81 28940 19.61 1
88 286600 224 38.29 29057 19.61 0
88 287943 71 19.06 29175 19.61 0
88 288669 167 28.76 29295 19.61 0
88 290740 124 23.92 29412 19.61 0
88 291485 124 23.92 29530 19.61 0
88 291631 220 37.58 29649 19.61 0
89 292171 184 31.36 29766 19.61 1
89 294472 167 28.76 29941 19.61 0
89 294872 167 28.76 30062 19.61 0
89 296211 49 15.48 30182 19.61 0
90 297307 193 32.84 30305 19.61 1
91 297530 248 42.69 30425 19.61 1
91 299644 307 54.48 30546 19.61 0
92 300481 348 65.64 30672 19.61 1
92 301748 280 48.67 30791 19.61 0
92 303479 127 24.18 30913 19.61 0
92 303725 135 24.92 31033 19.61 0
92 304198 83 20.46 31156 19.61 0
92 304864 179 30.55 31274 19.61 0
92 305373 280 48.67 31392 19.61 0
92 305528 398 85.63 31517 19.61 0
92 306573 255 43.96 31634 19.61 0
92 307509 163 28.20 31756 19.61 0
92 307694 86 20.77 31875 19.61 0
92 310592 135 24.92 31996 19.61 0
93 311680 243 41.74 32116 19.61 1
94 312028 526 158.17 32238 19.61 1
94 313054 305 53.88 32361 19.61 0
94 313504 60 17.43 32482 19.61 0
95 313886 384 80.08 32603 19.61 1
95 314216 127 24.18 32725 19.61 0
96 316142 352 66.89 32848 19.61 1
96 316657 252 43.42 32968 19.61 0
96 318402 51 15.86 33089 19.61 0
97 318736 294 51.51 33213 19.61 1
97 319519 71 19.06 33334 19.61 0
98 320007 428 101.58 33454 19.61 1
98 321017 275 47.73 33582 19.61 0
98 321850 312 55.68 33701 19.61 0
99 322028 89 21.05 33822 19.61 1
99 322447 62 17.75 33943 19.61 0
100 324298 448 112.41 34066 19.61 1
100 324763 79 20.03 34185 19.61 0
100 325705 231 39.55 34303 19.61 0
100 327318 270 46.71 34426 19.61 0
100 330324 65 18.22 34545 19.61 0
101 331114 472 125.87 34663 19.61 1
101 332205 67 18.51 34781 19.61 0
102 332757 369 73.42 34902 19.61 1
102 333590 127 24.18 35020 19.61 0
103 336059 295 51.75 35140 19.61 1
103 338053 143 25.74 35277 19.61 0
103 338416 86 20.77 35398 19.61 0
103 338954 142 25.64 35519 19.61 0
103 339156 163 28.20 35643 19.61 0
104 342952 391 82.35 35765 19.61 1
104 344835 222 37.96 35886 19.61 0
104 345547 143 25.74 36007 19.61 0
104 346363 332 61.17 36131 19.61 0
104 348336 96 21.67 36252 19.61 0
105 349474 281 48.90 36373 19.61 1
105 352244 62 17.75 36496 19.61 0
105 354489 103 22.23 36617 19.61 0
105 355150 199 33.86 36738 19.61 0
105 356705 124 23.92 36860 19.61 0
106 356840 252 43.42 36989 19.61 1
106 358758 86 20.77 37112 19.61 0
106 359562 156 27.28 37237 19.61 0
107 360471 224 38.29 37358 19.61 1
107 361092 127 24.18 37481 19.61 0
107 364643 83 20.46 37601 19.61 0
107 364916 67 18.51 37723 19.61 0
107 369303 112 22.94 37846 19.61 0
108 369748 280 48.67 37967 19.61 1
109 370101 286 49.78 38091 19.61 1
109 370559 192 32.67 38212 19.61 0
109 371708 760 464.80 38338 19.61 0
110 372047 423 97.36 38462 19.61 1
110 372281 156 27.28 38585 19.61 0
110 372479 224 38.29 38716 19.61 0
110 375251 337 62.30 38843 19.61 0
111 375460 350 66.46 38969 19.61 1
111 375888 63 17.91 39092 19.61 0
111 376728 88 20.96 39218 19.61 0
111 376974 62 17.75 39340 19.61 0
112 377789 280 48.67 39465 19.61 1
112 379249 96 21.67 39587 19.61 0
112 380025 96 21.67 39709 19.61 0
112 380230 150 26.54 39834 19.61 0
112 380448 448 112.41 39957 19.61 0
113 381123 364 71.71 40083 19.61 1
114 387045 319 57.64 40206 19.61 1
114 387935 192 32.67 40330 19.61 0
114 389421 231 39.55 40451 19.61 0
114 391152 57 16.93 40582 19.61 0
114 392034 446 111.64 40702 19.61 0
115 393285 273 47.25 40824 19.61 1
116 394073 508 144.95 40947 19.61 1
116 394378 96 21.67 41068 19.61 0
116 396356 81 20.25 41190 19.61 0
117 396793 94 21.50 41311 19.61 1
117 397083 88 20.96 41437 19.61 0
117 398431 56 16.76 41561 19.61 0
117 398660 67 18.51 41685 19.61 0
118 399825 78 19.92 41811 19.61 1
118 400021 192 32.67 41936 19.61 0
118 400999 48 15.29 42062 19.61 0
119 401583 166 28.62 42185 19.61 1
119 402369 159 27.66 42394 19.61 0
120 402542 89 21.05 42514 19.61 1
120 403394 94 21.50 42637 19.61 0
120 408186 124 23.92 42756 19.61 0
121 408442 412 92.93 42876 19.61 1
121 409096 51 15.86 42995 19.61 0
122 409439 280 48.67 43117 19.61 1
123 410902 526 158.17 43237 19.61 1
123 412803 80 20.14 43358 19.61 0
123 413088 216 36.85 43481 19.61 0
123 413652 206 35.07 43603 19.61 0
123 417673 131 24.54 43723 19.61 0
123 418301 319 57.64 43842 19.61 0
124 420043 415 95.00 43964 19.61 1
124 421831 105 22.39 44082 19.61 0
125 422331 326 59.13 44216 19.61 1
125 424016 131 24.54 44336 19.61 0
125 424316 319 57.64 44456 19.61 0
125 426196 163 28.20 44575 19.61 0
125 427748 56 16.76 44697 19.61 0
125 427999 152 26.78 44817 19.61 0
125 428717 199 33.86 44938 19.61 0
125 430061 97 21.75 45066 19.61 0
125 433494 236 40.44 45185 19.61 0
125 435208 49 15.48 45308 19.61 0
125 437360 94 21.50 45430 19.61 0
126 438904 280 48.67 45556 19.61 1
127 439668 359 69.86 45679 19.61 1
128 441079 515 147.53 45801 19.61 1
128 442006 51 15.86 45929 19.61 0
128 443955 108 22.63 46051 19.61 0
128 445486 79 20.03 46173 19.61 0
128 446017 147 26.19 46294 19.61 0
128 448847 97 21.75 46418 19.61 0
128 450927 167 28.76 46540 19.61 0
129 451893 390 82.70 46663 19.61 1
129 453702 145 25.96 46789 19.61 0
129 455186 49 15.48 46911 19.61 0
129 456250 167 28.76 47031 19.61 0
129 456590 236 40.44 47151 19.61 0
129 457308 184 31.36 47273 19.61 0
129 459419 120 23.58 47393 19.61 0
130 459777 432 101.61 47512 19.61 1
131 461895 305 53.88 47637 19.61 1
132 464289 319 57.64 47756 19.61 1
132 464606 60 17.43 47876 19.61 0
132 465444 51 15.86 48002 19.61 0
132 467036 103 22.23 48121 19.61 0
132 467450 211 35.96 48244 19.61 0
132 467583 88 20.96 48366 19.61 0
132 469335 220 37.58 48491 19.61 0
132 469661 332 61.17 48614 19.61 0
132 470968 184 31.36 48737 19.61 0
132 472395 152 26.78 48864 19.61 0
133 473046 316 56.81 48984 19.61 1
133 473823 152 26.78 49106 19.61 0
133 473969 184 31.36 49227 19.61 0
133 476034 135 24.92 49352 19.61 0
134 477467 339 62.98 49477 19.61 1
134 479684 140 25.42 49596 19.61 0
135 480837 547 162.22 49718 19.61 1
135 482655 112 22.94 49839 19.61 0
135 483036 167 28.76 49959 19.61 0
135 485020 78 19.92 50084 19.61 0
135 488746 188 32.01 50201 19.61 0
135 490896 217 37.04 50319 19.61 0
135 492243 67 18.51 50437 19.61 0
136 494905 467 121.56 50558 19.61 1
137 498892 422 97.97 50674 19.61 1
137 500734 81 20.25 50790 19.61 0
137 502596 384 80.08 50913 19.61 0
138 503661 79 20.03 51028 19.61 1
139 503793 295 51.75 51153 19.61 1
139 504248 167 28.76 51277 19.61 0
139 504380 390 82.70 51395 19.61 0
140 504953 376 76.43 51516 19.61 1
140 505361 88 20.96 51638 19.61 0
141 506386 348 65.64 51762 19.61 1
141 507879 88 20.96 51884 19.61 0
141 508093 96 21.67 52006 19.61 0
141 509342 185 31.51 52134 19.61 0
141 509728 334 61.44 52255 19.61 0
141 511311 65 18.22 52377 19.61 0
142 512344 284 49.41 52500 19.61 1
142 512482 103 22.23 52626 19.61 0
143 514604 255 43.96 52747 19.61 1
143 515378 198 33.69 52872 19.61 0
143 516529 179 30.55 52997 19.61 0
143 517803 78 19.92 53119 19.61 0
143 517963 63 17.91 53242 19.61 0
143 518920 56 16.76 53366 19.61 0
144 520383 412 92.93 53490 19.61 1
144 520962 103 22.23 53610 19.61 0
144 521269 83 20.46 53729 19.61 0
145 522679 255 43.96 53851 19.61 1
145 523940 63 17.91 53972 19.61 0
146 526529 241 41.39 54090 19.61 1
146 527696 110 22.78 54209 19.61 0
147 528807 393 83.55 54332 19.61 1
147 531207 56 16.76 54451 19.61 0
147 536917 152 26.78 54571 19.61 0
147 537955 206 35.07 54694 19.61 0
147 541951 174 29.79 54817 19.61 0
148 543630 335 61.77 54940 19.61 1
149 545151 252 43.42 55062 19.61 1
149 545654 108 22.63 55188 19.61 0
149 545780 472 125.87 55310 19.61 0
150 547584 326 59.13 55432 19.61 1
151 547975 403 88.99 55558 19.61 1
152 550109 348 65.64 55680 19.61 1
152 550663 166 28.62 55802 19.61 0
152 552488 115 23.18 55924 19.61 0
153 554569 319 57.64 56048 19.61 1
154 555013 376 76.43 56170 19.61 1
155 557924 451 113.08 56294 19.61 1
156 559765 305 53.88 56433 19.61 1
157 560309 408 90.57 56555 19.61 1
157 560964 192 32.67 56676 19.61 0
158 561304 262 45.24 56801 19.61 1
158 563046 108 22.63 56921 19.61 0
159 563459 295 51.75 57040 19.61 1
160 564422 460 119.54 57166 19.61 1
161 565613 403 88.99 57283 19.61 1
162 568952 280 48.67 57403 19.61 1
162 569384 156 27.28 57522 19.61 0
162 573361 108 22.63 57645 19.61 0
162 575437 216 36.85 57768 19.61 0
163 576317 273 47.25 57892 19.61 1
163 577867 60 17.43 58019 19.61 0
164 578011 543 164.77 58143 19.61 1
164 578181 172 29.49 58269 19.61 0
164 579804 71 19.06 58402 19.61 0
164 581601 127 24.18 58527 19.61 0
165 582425 206 35.07 58656 19.61 1
165 583690 182 31.03 58781 19.61 0
166 585955 271 46.93 58906 19.61 1
166 588492 83 20.46 59034 19.61 0
166 589088 135 24.92 59159 19.61 0
166 590836 172 29.49 59287 19.61 0
167 593746 472 125.87 59414 19.61 1
168 594811 281 48.90 59542 19.61 1
168 595329 57 16.93 59669 19.61 0
168 596249 179 30.55 59793 19.61 0
168 596671 399 87.30 59927 19.61 0
168 596909 143 25.74 60049 19.61 0
169 599656 312 55.68 60175 19.61 1
169 601742 307 54.48 60298 19.61 0
169 603164 284 49.41 60422 19.61 0
169 603638 166 28.62 60545 19.61 0
169 607007 142 25.64 60671 19.61 0
169 607371 51 15.86 60794 19.61 0
169 608411 176 30.09 60918 19.61 0
169 609358 307 54.48 61047 19.61 0
169 609786 51 15.86 61173 19.61 0
170 611310 460 119.54 61301 19.61 1
171 614247 319 57.64 61427 19.61 1
171 615170 190 32.33 61555 19.61 0
172 615317 287 50.23 61688 19.61 1
172 616406 142 25.64 61816 19.61 0
173 616708 359 69.86 61941 19.61 1
173 620306 63 17.91 62066 19.61 0
173 621918 88 20.96 62193 19.61 0
174 623089 305 53.88 62317 19.61 1
175 625691 284 49.41 62444 19.61 1
175 629408 332 61.17 62569 19.61 0
176 629726 422 97.97 62697 19.61 1
177 630137 76 19.69 62823 19.61 1
177 630623 184 31.36 62947 19.61 0
177 633777 263 45.37 63073 19.61 0
178 634144 103 22.23 63195 19.61 1
179 635420 368 72.93 63320 19.61 1
179 636907 176 30.09 63443 19.61 0
179 639137 428 101.58 63575 19.61 0
179 640477 207 35.26 63693 19.61 0
180 641305 51 15.86 63810 19.61 1
181 643514 255 43.96 63931 19.61 1
182 644963 327 59.28 64049 19.61 1
182 645297 273 47.25 64167 19.61 0
182 647760 172 29.49 64287 19.61 0
183 651989 263 45.37 64409 19.61 1
184 652333 600 203.87 64531 19.61 1
184 652983 89 21.05 64652 19.61 0
184 654624 51 15.86 64775 19.61 0
184 655873 255 43.96 64895 19.61 0
185 656256 440 109.25 65017 19.61 1
186 658036 249 42.85 65138 19.61 1
186 658201 152 26.78 65274 19.61 0
187 660040 409 91.12 65398 19.61 1
188 660280 275 47.73 65526 19.61 1
189 661108 65 18.22 65647 19.61 1
189 662210 560 175.34 65770 19.61 0
189 665352 96 21.67 65892 19.61 0
189 666369 131 24.54 66018 19.61 0
190 669369 376 76.43 66142 19.61 1
190 672736 161 27.93 66265 19.61 0
191 675259 408 90.57 66394 19.61 1
192 675900 280 48.67 66514 19.61 1
193 676292 428 101.58 66635 19.61 1
193 676514 67 18.51 66756 19.61 0
194 677089 273 47.25 66880 19.61 1
194 677790 71 19.06 67004 19.61 0
194 680024 275 47.73 67123 19.61 0
195 683715 265 45.75 67246 19.61 1
196 684587 286 49.78 67367 19.61 1
196 685504 728 431.28 67487 19.61 0
197 686223 287 50.23 67609 19.61 1
198 688571 192 32.67 67736 19.61 1
198 688709 254 43.77 67860 19.61 0
198 690164 177 30.25 67983 19.61 0
199 692265 374 75.61 68109 19.61 1
199 694048 147 26.19 68232 19.61 0
199 696545 294 51.51 68354 19.61 0
199 696687 236 40.44 68477 19.61 0
200 697004 225 38.48 68602 19.61 1
200 698592 70 18.93 68728 19.61 0
200 701618 51 15.86 68850 19.61 0
201 703520 486 135.98 68974 19.61 1
201 703958 307 54.48 69097 19.61 0
202 704097 216 36.85 69221 19.61 1
202 705071 88 20.96 69349 19.61 0
202 706443 96 21.67 69470 19.61 0
203 711031 304 53.73 69591 19.61 1
203 711581 76 19.69 69711 19.61 0
204 712276 307 54.48 69837 19.61 1
204 712765 92 21.32 69957 19.61 0
204 713219 291 50.97 70079 19.61 0
204 715466 327 59.28 70203 19.61 0
204 715935 97 21.75 70321 19.61 0
204 716594 62 17.75 70441 19.61 0
204 716996 216 36.85 70575 19.61 0
204 717338 60 17.43 70697 19.61 0
204 717663 143 25.74 70821 19.61 0
205 718961 289 50.47 70945 19.61 1
206 719825 254 43.77 71071 19.61 1
206 721805 76 19.69 71195 19.61 0
207 722038 391 82.35 71318 19.61 1
208 722276 307 54.48 71443 19.61 1
208 722649 127 24.18 71566 19.61 0
208 725337 63 17.91 71689 19.61 0
208 726675 78 19.92 71812 19.61 0
209 729209 460 119.54 71937 19.61 1
209 731334 56 16.76 72059 19.61 0
209 733538 99 21.91 72181 19.61 0
210 733919 448 112.41 72310 19.61 1
211 734626 323 58.48 72435 19.61 1
211 735250 159 27.66 72564 19.61 0
212 737414 184 31.36 72689 19.61 1
213 740983 467 121.56 72812 19.61 1
213 744019 216 36.85 72938 19.61 0
213 745657 286 49.78 73061 19.61 0
213 745941 220 37.58 73187 19.61 0
213 746087 231 39.55 73309 19.61 0
213 747403 129 24.35 73433 19.61 0
213 749055 115 23.18 73557 19.61 0
213 749781 156 27.28 73680 19.61 0
214 749928 401 87.91 73806 19.61 1
214 752305 97 21.75 73931 19.61 0
214 752707 92 21.32 74067 19.61 0
215 754365 384 80.08 74192 19.61 1
216 755117 241 41.39 74320 19.61 1
216 755489 79 20.03 74446 19.61 0
216 756832 176 30.09 74575 19.61 0
216 758048 271 46.93 74700 19.61 0
217 758332 316 56.81 74825 19.61 1
218 758793 275 47.73 74953 19.61 1
218 761171 71 19.06 75077 19.61 0
218 762097 227 38.83 75205 19.61 0
218 762486 63 17.91 75329 19.61 0
218 764581 79 20.03 75457 19.61 0
218 765753 206 35.07 75582 19.61 0
218 765936 289 50.47 75707 19.61 0
218 766892 51 15.86 75835 19.61 0
219 767321 295 51.75 75966 19.61 1
220 768496 496 144.49 76092 19.61 1
221 769794 316 56.81 76215 19.61 1
221 770608 294 51.51 76340 19.61 0
222 770801 177 30.25 76464 19.61 1
222 770931 270 46.71 76588 19.61 0
222 772731 284 49.41 76710 19.61 0
222 773303 240 41.21 76832 19.61 0
223 774600 271 46.93 76958 19.61 1
224 775473 371 73.82 77084 19.61 1
224 775650 174 29.79 77211 19.61 0
225 779790 608 202.86 77336 19.61 1
225 780817 209 35.61 77464 19.61 0
225 782110 73 19.32 77589 19.61 0
225 783492 147 26.19 77728 19.61 0
226 784518 243 41.74 77852 19.61 1
227 785369 414 93.93 77976 19.61 1
228 786149 455 117.03 78100 19.61 1
228 788105 56 16.76 78226 19.61 0
229 790060 432 101.61 78349 19.61 1
229 790237 289 50.47 78472 19.61 0
229 790649 174 29.79 78598 19.61 0
229 793794 60 17.43 78722 19.61 0
229 795430 403 88.99 78846 19.61 0
229 797498 152 26.78 78970 19.61 0
229 799665 140 25.42 79096 19.61 0
229 800545 391 82.35 79218 19.61 0
230 800988 348 65.64 79340 19.61 1
230 801336 304 53.73 79472 19.61 0
230 802678 60 17.43 79594 19.61 0
230 803644 108 22.63 79714 19.61 0
231 804186 254 43.77 79836 19.61 1
231 804732 131 24.54 79957 19.61 0
231 805026 67 18.51 80078 19.61 0
231 805534 71 19.06 80206 19.61 0
232 809915 401 87.91 80327 19.61 1
233 810886 312 55.68 80451 19.61 1
233 811259 51 15.86 80575 19.61 0
234 813269 316 56.81 80700 19.61 1
235 814365 417 95.20 80824 19.61 1
235 814853 62 17.75 80947 19.61 0
235 818135 62 17.75 81075 19.61 0
235 820825 81 20.25 81197 19.61 0
235 821605 88 20.96 81323 19.61 0
236 822133 286 49.78 81445 19.61 1
237 822517 240 41.21 81569 19.61 1
237 822868 225 38.48 81691 19.61 0
238 823877 300 52.79 81814 19.61 1
239 824506 79 20.03 81940 19.61 1
239 825850 152 26.78 82063 19.61 0
239 826977 110 22.78 82185 19.61 0
239 829019 307 54.48 82306 19.61 0
239 832815 408 90.57 82429 19.61 0
239 833858 56 16.76 82548 19.61 0
240 834592 51 15.86 82670 19.61 1
240 834995 71 19.06 82792 19.61 0
240 835155 126 24.09 82911 19.61 0
241 837976 307 54.48 83035 19.61 1
241 839149 243 41.74 83160 19.61 0
242 839552 252 43.42 83280 19.61 1
242 841152 79 20.03 83405 19.61 0
243 841415 487 132.65 83529 19.61 1
243 842111 176 30.09 83655 19.61 0
243 842752 127 24.18 83778 19.61 0
244 842926 335 61.77 83901 19.61 1
244 844623 97 21.75 84029 19.61 0
245 846221 316 56.81 84150 19.61 1
245 846676 71 19.06 84273 19.61 0
245 847759 142 25.64 84396 19.61 0
245 848348 248 42.69 84521 19.61 0
246 848766 327 59.28 84643 19.61 1
246 852650 167 28.76 84779 19.61 0
246 853115 719 344.94 84905 19.61 0
247 856554 271 46.93 85029 19.61 1
247 856939 305 53.88 85154 19.61 0
248 857710 291 50.97 85279 19.61 1
249 862865 319 57.64 85401 19.61 1
249 863515 179 30.55 85522 19.61 0
250 863967 444 109.09 85642 19.61 1
250 864891 179 30.55 85767 19.61 0
250 865226 73 19.32 85887 19.61 0
251 866264 323 58.48 86008 19.61 1
252 867576 451 113.08 86132 19.61 1
252 867974 145 25.96 86253 19.61 0
252 868991 199 33.86 86376 19.61 0
253 869527 335 61.77 86507 19.61 1
254 870115 444 109.09 86631 19.61 1
254 873264 131 24.54 86754 19.61 0
254 874291 216 36.85 86877 19.61 0
254 875936 248 42.69 87004 19.61 0
254 876404 120 23.58 87128 19.61 0
254 876736 184 31.36 87251 19.61 0
254 878607 62 17.75 87377 19.61 0
254 880217 248 42.69 87500 19.61 0
254 880409 159 27.66 87622 19.61 0
254 881875 172 29.49 87744 19.61 0
255 884062 377 76.28 87869 19.61 1
255 887091 143 25.74 87992 19.61 0
255 888275 79 20.03 88115 19.61 0
255 888973 97 21.75 88241 19.61 0
255 889274 79 20.03 88368 19.61 0
255 889443 108 22.63 88489 19.61 0
255 889732 248 42.69 88613 19.61 0
255 889973 79 20.03 88734 19.61 0
255 890298 135 24.92 88856 19.61 0
255 891698 408 90.57 88975 19.61 0
255 892258 231 39.55 89097 19.61 0
256 893942 286 49.78 89218 19.61 1
256 895729 412 92.93 89339 19.61 0
256 896428 76 19.69 89464 19.61 0
257 896616 307 54.48 89584 19.61 1
257 896909 376 76.43 89708 19.61 0
257 897063 96 21.67 89832 19.61 0
257 898230 79 20.03 89958 19.61 0
257 899066 348 65.64 90086 19.61 0
257 899480 63 17.91 90209 19.61 0
258 901380 401 87.91 90334 19.61 1
258 902054 231 39.55 90457 19.61 0
259 902727 319 57.64 90580 19.61 1
259 903085 67 18.51 90702 19.61 0
259 903801 67 18.51 90827 19.61 0
259 904312 224 38.29 90949 19.61 0
259 905615 147 26.19 91072 19.61 0
260 906700 273 47.25 91198 19.61 1
260 907460 103 22.23 91322 19.61 0
261 909068 252 43.42 91445 19.61 1
261 910729 99 21.91 91566 19.61 0
261 911126 134 24.82 91689 19.61 0
261 911731 108 22.63 91821 19.61 0
261 912116 99 21.91 91947 19.61 0
262 913083 307 54.48 92065 19.61 1
263 913442 255 43.96 92184 19.61 1
264 915404 335 61.77 92305 19.61 1
264 916478 159 27.66 92428 19.61 0
264 916877 96 21.67 92549 19.61 0
265 917206 318 57.28
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

Thread 73 (2022-01-05):

1 count and then no detection

halifaxjack, 2022-01-05:
Hi Spencer,

I'm new to electronics and am learning a lot as I go through this project, so thank you for making this.

I've assembled 2 detectors and am getting the same 1 count error on both of them. I'm getting the correct voltages according to the instructions, and my SiPM is giving resistance. I've played around with your code and changed the thresholds but still get the 1 count error.

Here are some pictures of my hardware, incase it's an assembly issue.
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

Cheers,
And thanks again!

Jack

spenceraxani, 2022-01-05:
Hi Jack,

Thanks for the nice images. One thing that pops out is the lack of tape or tape residual on your SiPM PCB. I’d like to first confirm that you are wrapping the whole SiPM PCB assembly in black tape before booting it up. It will have to be light tight to work.

Your solder joints look well done, although there is likely a cold solder or poor connection somewhere. This tends to be the most likely issue, so I would start there — hit every solder joint with some new solder to ensure a good connection. For example, it looks like one of the legs on the op amp may not be connected (image below). R3 looks OK, but could also be suspect.

If the above two things do not solve your problem, can you remove the temperature sensor? Twice in the past month-or-so I saw people with faulty sensors.

Finally, if you are changing the thresholds, I would increase them. Maybe bring them both up to ~60 ADC counts.

Thanks,

Spencer

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

halifaxjack, 2022-01-05:
Hi Spencer,

Thanks! I hit a few joints with some extra solder and light tightened by SiPM PCB and its working now! Now I need to increase that threshold because I'm getting some crazy counts.

Cheers
Jack

spenceraxani, 2022-01-05:
Glad to hear it. I would keep the threshold at the default value. Perhaps you have a light leak? You really need it to be light-tight. The count rate should be single Hz level.

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

Closed 2022-01-05.

Thread 74 (2022-01-06):

SiPM Optical coupling

PaulHearn92, 2022-01-06:
I did a test between PM Optical coupling gel and Petroleum Jelly.   I could see no difference in count rate.  Is Optical coupling gel Petroleum Jelly or something else.  We are considering what to include with our Cosmic Watch kits.
Paul Hearn.

spenceraxani, 2022-01-06:
Hi Paul,

I’m not sure of the chemical composition of optical gel, although I would bet it’s different than petroleum jelly. While their refractive indices are similar, the optical absorption is different. Optical gel is designed to have the correct index of refraction, a high transmisivity to the wavelength of electromagnetic radiation that PMTs are most sensitivity to (~420nm), and a specific viscosity that helps remove air bubbles and provide a long term interface. With petroleum jelly, it’s purely a coincidence and you likely lose extra photons.

Thanks,

Spencer

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

PaulHearn92, 2022-01-06:
Thanks Spencer,

One again a great and swift answer…

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

PaulHearn92, 2022-01-07:
Dear Spencer,

I believe the energy in mV from the SiPM is a function of the muon event energy and the path length in the scintillator.  Do we know the minimum muon path length to give a output signal.  I’m looking to see if the SiPM output can be related to the originating muon event.

Best wishes,

Paul.

Paul Hearn

¦¦¦  British Astronomical Association  ¦¦  Radio Astronomy Section  ¦¦

Burlington house, Piccadilly, W1J 0DU

 <https://britastro.org/section_front/24> https://britastro.org/section_front/24

 <https://www.youtube.com/user/britishastronomical/playlists> https://www.youtube.com/user/britishastronomical/playlists

e      ***@***.***> ***@***.***

a     RG6 1BU UK

t     +44 (0)7967 388 578

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

spenceraxani, 2022-01-07:
Hi Paul,

That’s correct. We typically assume cosmic-ray muons to be a minimum ionizing particle, which will deposit 2-3MeV per cm travelled in this scintillator (density of ~1g/cm^3), regardless of the muon energy. Since the scintillator is ~1cm thick, the majority of the muonic events will deposit 2-3MeV, which is larger than the energy deposited by most backgrounds. There are gamma rays that are above 1MeV (like 40K and 60Co), although since we are using low density scintillator, the gamma ray is more likely to Compton scatter, depositing a small fraction of energy in the scintillator and scatter out.  This is why the muons pop out at higher SiPM values and backgrounds populate the lower SiPM values, as shown in Fig. 13 of the PhysicsPaper.pdf:

https://github.com/spenceraxani/CosmicWatch-Desktop-Muon-Detector-v2/blob/master/ThePhysicsPaper.pdf <https://github.com/spenceraxani/CosmicWatch-Desktop-Muon-Detector-v2/blob/master/ThePhysicsPaper.pdf>

The energy resolution on the detector is extremely poor though. I would bet that the minimum path length for a muon to trigger the detector is somewhere around 2mm.

Thanks,

Spencer

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

PaulHearn92, 2022-01-07:
Hi Spencer,

Thanks again for the great answer.  Has anyone ever tried to measure the energy resolution.

(todays job polishing ten scintillators for batch 3).

Best wishes,

Paul.

Paul Hearn

¦¦¦  British Astronomical Association  ¦¦  Radio Astronomy Section  ¦¦

Burlington house, Piccadilly, W1J 0DU

 <https://britastro.org/section_front/24> https://britastro.org/section_front/24

 <https://www.youtube.com/user/britishastronomical/playlists> https://www.youtube.com/user/britishastronomical/playlists

e      ***@***.***> ***@***.***

a     RG6 1BU UK

t     +44 (0)7967 388 578

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

spenceraxani, 2022-01-07:
Hi Paul,

Yes, multiple people have tried, but you cannot extra any mono-energetic gamma-ray peaks since most interactions are Compton scatters. So, you’re pretty much left with the single datapoint from the minimum ionization from muons. The detector does not work for gamma-ray spectroscopy.

Thanks,

Spencer

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

Thread 75 (2022-01-17):

iPython Note Book

tony1tf, 2022-01-17:
Hi Spencer,  All I want to do is plot the data from my muon detector. I can do it in Excel, but that's rather clunky. The system you have set up seems to use iPython note books, which looks incredibly complicated, and is something I don't feel I want to learn. Can you point me to any simple python code which I can use on a MacBook to plot the output of my detector either in batches or in real time? I have managed to edit the code which receives data from the detector and saves it to a text file to run under Python3, since the libraries wouldn't install in Python. Lots of '()'s needed adding to print statements, and substitution of 'input' for 'raw_input'.
Tony

spenceraxani, 2022-01-18:
Hi Tony,

I don’t think I have anything simpler than that in the iPython script, although, like you mention, it was written for python 2, which means the print statements and raw_input may need to be update.

To use the iPython code in a python script (copy and paste the iPython cells), you should only have to remove the first three lines:

%matplotlib inline
from IPython.core.display import display, HTML
display(HTML("<style>.container { width:100% !important; }</style>”))

You will also have to replace the file name with your file name.

Thanks,

Spencer

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

tony1tf, 2022-01-31:
Hi Spencer
I am trying to run your example plotting script, and have put my file name into the code, but I can't seem to get round the following errors:

`TypeError`                                 Traceback (most recent call last)
/var/folders/43/v1d780lj3dvff3z8g6t_qphr0000gn/T/ipykernel_63770/2022836374.py in <module>
      3 #    2. Give the size of binning in time you would like
      4 cwd = os.getcwd()
----> 5 f1 = CWClass(cwd + "/background_31Jan2022.txt", bin_size = 10)
      6 # f2 = CWClass(cwd + "/Sheilding/bkg_nobox_sheild_long.txt", bin_size = 60)

/var/folders/43/v1d780lj3dvff3z8g6t_qphr0000gn/T/ipykernel_63770/2328829766.py in __init__(self, fname, bin_size)
     80             return sum(check == l)==len(l)
     81
---> 82         if not sequential(event_number):
     83             print('Events in file are not sequential.')
     84

/var/folders/43/v1d780lj3dvff3z8g6t_qphr0000gn/T/ipykernel_63770/2328829766.py in sequential(l)
     67         def sequential(l):
     68             l = np.asarray(l).astype(int)
---> 69             check = range(min(l),max(l)+1)
     70
     71             if len(l)!=len(check):

TypeError: iteration over a 0-d array
`
Tony

spenceraxani, 2022-01-31:
Can you send the txt file in an email? ***@***.*** ***@***.***>

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

Thread 77 (2022-02-15):

Import Data Live

Phoenix1747, 2022-02-15:
Hi there, I'm trying to build CosmicWatch-compatability into my own [gamma spectroscopy software](https://github.com/Open-Gamma-Project/Gamma-MCA) to enable live-plotting without the need for an extra python script. (not for gamma spectroscopy of course, but just for some simple histogram plotting like the current website)

Now I don't have access to a muon detector so I can't test it on my own. What does the serial output from the detector look like when it is sent to the [current web utility](http://www.cosmicwatch.lns.mit.edu/measure)? Is it the same when printing to a file like this?

```text
##########################################################################################
### CosmicWatch: The Desktop Muon Detector
### Questions? saxani@mit.edu
### Comp_date Comp_time Event Ardn_time[ms] ADC[0-1023] SiPM[mV] Deadtime[ms] Temp[C] Name
##########################################################################################
Device ID(s): NCBJ021
2018-07-10 12:53:32.659892 1 42 608 202.86 74 96.63 NCBJ021
2018-07-10 12:53:33.316180 2 699 108 22.63 78 26.05 NCBJ021
2018-07-10 12:53:33.456973 3 841 152 26.78 82 5.43 NCBJ021
2018-07-10 12:53:33.962563 4 1344 195 33.17 120 12.63 NCBJ021
2018-07-10 12:53:34.458533 5 1841 71 19.06 124 -10.68 NCBJ021
2018-07-10 12:53:34.590431 6 1973 369 73.42 128 40.23 NCBJ021
.....
```

(See [this file](https://github.com/spenceraxani/CosmicWatch-Desktop-Muon-Detector-v2/blob/master/Recording_Data/ExamplePlots/Sheilding/bkg_nobox_long.txt))
I'm planning on using the Web Serial API to interface directly with the detector, take it's serial data and the correct data element (which would be number five here - the ADC channel which is most important) and plot it, thus bypassing the need for a local webserver like tornado. This currently only works in Chrome-based browsers though.

spenceraxani, 2022-02-15:
Hi,

The data is continuously sent out through the serial port. That data can be either sent to our website for plotting in realtime, or written to a file, using the import_data.py script. In your case, you should look at how it is written to a file, and have your script monitor that file for changes to update your plots. The data import_data.py script adds the first two columns in the data that you attached. Everything else, is sent directly from the detector.

Thanks,

Spencer

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

jeroenvantilburg, 2022-04-21:
Hi there,

This is exactly what I have been doing! I have used the Web Serial API to plot live data on a Chrome browser without the need for running a Python script (my students for instance do not have Python on their Chromebooks). My web app can plot both online (live) and offline data, it can plot multiple datasets at the same time, it can modify the histograms and it can find coincidences between two datasets. Have a look at:
  https://jeroenvantilburg.nl/cosmicwatch/

Feel free to use the code for your own purpose in case you haven't implemented it yourself already.

Jeroen

P.S. After working for a year with these detectors I finally found this nice "forum" ;-)

spenceraxani, 2022-05-28:
Hi Jeroen,

Thanks for the link and sorry for the extremely late reply. That looks amazing — great idea! Our web GUI works a bit differently. I’ve run into a handful of people hitting the python wall, either from lack of programing experience or only being familiar with another language.

Thanks,

Spencer

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

Closed 2022-06-05.

Thread 79 (2022-03-27):

How do you count muons?

agnessap, 2022-03-27:
Hi,
I've made the muon detector, and am now trying to count how many muons there are.
I've tried using some of the code which is on the CosmicWatch GitHub, but I don't quite understand how I can "count" how many muons that are detected.
I would appreciate any help or clarifications :)

spenceraxani, 2022-10-11:
Hi,

There are primarily two ways to improve the purity of the muon sample that you are collecting.

1. If you have two detectors, you can connect them through the 3.5mm cable. This sets them up in coincidence mode. With this, you can get to ~99.9% purity (if you are a under >6” of concrete to shield from the electromagnetic component of the shower).

2. If you have a single detector, you can reduce the background by increasing the threshold (see the attached image, coincident events are mouns). Although this only gets you to a ~60% purity.

If you would like to read more about how this works, please see Section 5.3.1 of the PhyiscsPaper.pdf in the Github repo. If this does not answer your question, please let me know.

Thanks,

Spencer

 only

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

Thread 80 (2022-04-06):

Replacement for C4 and C16

Airbasti, 2022-04-06:
Hey,
during building i noticed i accidentally ordered a 10uF 16V X5R0805 instead of the 6.3V one. Since ordering always takes some time from my country i would be interested if i can use another capacitor on the C4 and C16 spots. I ordered the other capacitors in large quantities and could use them. Or maybe the 16V will work but i cannot quite understand its function.
Thanks in advance!!

Airbasti, 2022-04-06:
Little update,
in the purchasing list it says 10 uF 16V and in the description of where the components are placed it say 10 uF 6,3V.
Does it matter which i take?

spenceraxani, 2022-10-11:
Hi,

Shouldn’t be a problem. The number you are referring to represents a rating for the maximum operating voltage. These large caps (10uF) are used for filtering a 5V line, so anything above 5V should be fine. The 6.3V caps were chosen simply because they were cheaper.

Thanks,

Spencer

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

Closed 2022-04-08.

Thread 81 (2022-04-08):

How do i check if SiPM broke

Airbasti, 2022-04-08:
Hey i just finished building two of the detectors. Such a great project!
Sadly only one works. The other one shows no detections at all. Does anyone have an idea what could be the problem?
The main PCB is working fine. I tested it with the other scintillator. It must be a problem coming from the SiPM PCB.
I compared all the voltages coming from the SiPM PCB and they are matching the ones from the working SiPM. I even did a test using light and the SiPM seems to react to light because the voltage gets higher coming from the SipM with more light.
I dismantled the whole board except for the SiPM and rebuild it changing every component apart from the SiPM. I suspect i broke it somehow by tightening the screws to far but i would appreciate it if anyone has another option that could cause these problems. Is there a way to test if my SiPM works? Don't want to replace a working one.
Thank you in advance!!

spenceraxani, 2022-04-08:
Hi,

Glad you enjoyed the project, and it sounds like you are pretty close to having two working detectors. Your troubleshooting was all correct, and the problem likely lies within the connection on the SiPM. A few things to check:
	1. Ensure that the SiPM is correctly orientated (pin 1 to the footprint with the circle).
	2. Add some new solder to the SiPM connections — this is my guess as to your problem. It could be that you simply have a cold solder joint on the SiPM-SiPM PCB.
	3. Make sure that the resistors on the SiPM PCB are soldered correctly. This is unlikely the issue, but add some new solder anyways.
	4. Make sure when you tape it up that it is light-tight. A small light leak can cause the detector to stall. We use single photon detectors, so the smallest light leak can easily saturate the detector.

It’s unlikely that you broke anything. The above checks should solve the issue.

Thanks,

Spencer

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

Airbasti, 2022-04-08:
Okay thank you so much for the quick answer! So i should not see a detection at all if the detector is saturated by light? If i don't add the electrical tape completely it will not work?
And doesen't the fact that the multimeter measures a current on the other side of the SiPM PCB mean that i have soldered the SiPM correctly (I am refering to this test measurement you did here at the 12 minute mark https://www.youtube.com/watch?v=yFgin5wlw4I) ? Or should i check it anyway?

spenceraxani, 2022-04-10:
Hi,

That’s correct. You will not record counts if there is too much light. It really needs to be light tight to ensure that it is working. The multimeter test does not ensure that the orientation is correct, it simply means that you have continuity between the terminals. However, if you have a poor connection, or intermittent, you could potentially still see a current with the multimeter. Since you need to check the SiPM orientation, you should also add some new solder to the SiPM connections and to the resistors on the SiPM PCB before taping it up again.

Thanks,

Spencer

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

Spirko, 2022-05-05:
You can test the orientation and connection of the SiPM with a multimeter in diode mode.  There are contact points on the bottom of the board (opposite the SiPM).  Just remember that in operation, the SiPM is reverse biased, but when testing with a multimeter, you want it forward biased.  The measured forward bias voltage is around 0.5 V.

Thread 83 (2022-04-30):

Where are the Arduino .ino files located?

FreekvandenHeuvel, 2022-04-30:
Hello,

About a year ago, my daughter built 2 v2 detectors for a school project. Never finished the detectors due to "soldering mistakes".
Reworked them last week and the electronics and SiPM-module are correct and working now.

However can't find the necessary Arduino .ino files (apart from the Naming.ino and OLED.ino and SDCard.ino files).
Found the v1 files, but not the v2's.

Where can I find them ??

Regards, Freek

spenceraxani, 2022-04-30:
Hi Freek,

The Arduino code is located in the Arduino/ folder:
https://github.com/spenceraxani/CosmicWatch-Desktop-Muon-Detector-v2/tree/master/Arduino <https://github.com/spenceraxani/CosmicWatch-Desktop-Muon-Detector-v2/tree/master/Arduino>

The Naming.ino script is uploaded to name the detector. Then you can upload either the OLED.ino or the SDCard.ino file, depending on whether you want to run the OLED or SDCard. The reason why they are currently separated is due to the limited RAM on the Arduino.

Thanks,

Spencer

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

FreekvandenHeuvel, 2022-04-30:
Hi Spencer,

Thanks for your quick response!

I feel stupid. I was looking for a file with a name like "Detector.ino" or something like that. Thought the other files, like "Naming.ino", were parts of a central file. I should have opened one of them first; then I could have seen it.

Sorry to have bothered you for something so obvious ...

Thanks, Freek

Closed 2022-04-30.

Thread 84 (2022-05-10):

Forbush decrease

PaulHearn92, 2022-05-10:
Has anyone observed the Forbush decrease while observing Cosmic radiation (muons).  Does the Cosmic Watch detector have sufficient sensitivity to see this.

(https://www.sciencedirect.com/topics/earth-and-planetary-sciences/forbush-decrease)

Paul Hearn

spenceraxani, 2022-05-10:
Hi Paul,

No one has yet to observe it, but we’ve been trying with an array of 10x detectors for some time. Our problem is that we haven’t had a very large CME while the detector array was running. We’re looking for it in Boston, although it would be easier to see at higher altitudes and latitudes.

Thanks,

Spencer

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

PaulHearn92, 2022-05-10:
Thanks for swift reply.  Maybe I will be the first.  I’m now monitoring 24/7

Best wishes,

Paul.

Paul Hearn

Radio Astronomy Section Director

UKRAA Trustee

¦¦¦  British Astronomical Association  ¦¦

Burlington house, Piccadilly, W1J 0DU

 <https://britastro.org/section_front/24> https://britastro.org/section_front/24

 <https://www.youtube.com/user/britishastronomical/playlists> https://www.youtube.com/user/britishastronomical/playlists

e      ***@***.***> ***@***.***

a     RG6 1BU UK

t     +44 (0)7967 388 578

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

Thread 85 (2022-05-16):

OLED not starting up when plugged in

JMulder99, 2022-05-16:
My OLED screen won't start up when the Arduino is plugged in. I already tried:
1. Checking the OLED.ino file reads "1" to turn on the OLED.
2. Replacing the screen
3. Switching the VCC and GND pins using 4 male to female wires.
4. Checking the voltage across the VCC (4.6V), and SCL and SDA (around 3.2V)
5. Reuploading the OLED.ino file
6. Installing the CH340g driver on windows

The DC-DC booster circuit isn't working, but I don't think this is needed for the screen to turn on. What is left to troubleshoot?

spenceraxani, 2022-05-16:
Hi,

The OLED requires that the VCC pin is one of the edge pins. You shouldn’t switch the VCC and GND pins — it may be that you fried something sending the VCC to GND. There’s not much to the OLED screen, the 4 connections go directly to the Arduino. If the Arduino has the code uploaded, the screen should turn on. Some of the screens I’ve purchased have noticeable cracks in the screen, primarily in the upper corners. If the screen is cracked it will not work. A smaller percentage of screens, maybe 1% or so, I’ve found that the ribbon cable on the back of the screen was soldered crooked.

The DC-DC booster takes the 5V and boosts it to 29.6V. I you have the correct input voltage (4.6V is fine), then the problem lies in one of the components in the DC-DC booster circuit. The most common issue I see is the soldering on the LT3461 pins. I would check the orientation and add some new solder. If the problem persists after checking the LT3461 and adding new solder to all the components (including the resistors), then the likely issue is either that the LT3461 needs to be replaced or the larger inductor needs to be replaced. Analog.com <http://analog.com/> will send you two free LT3461 if you have an account. I’ve had to replace maybe 1% of the LT3461s, and sub<1% of the time the larger inductor.

I would aim to get the OLED working first. When you swapped the VCC and GND pin, there’s a chance you fried the Arduino. If you cannot get the screen working, I would be cautious working on the rest of the circuit, since the Arduino is nearly impossible to replace.

Thanks,

Spencer

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

JMulder99, 2022-05-18:
Thank you @spenceraxani for your response. I got in contact with an electrician and he resoldered the OLED socket. It fixed the issue.

Closed 2022-05-18.

Thread 86 (2022-05-18):

UKRAA can supply Cosmic Watch kits and Detectors

PaulHearn92, 2022-05-18:
The UK Radio Astronomy Association - UKRAA are pleased to announce that we are now able to supply Cosmic Watch kits and built Detectors.

We offer several options for the kits, including all SMD components soldered to the PCB.  The scintillator is included  polished, drilled and tapped. Optical coupling compound is also included.

If interested do visit our web site shop where all the options are detailed.

Paul Hearn
BAA RA Section Director
UKRAA Trustee

Thread 88 (2022-05-29):

Efficiency measurements or estimates

jeroenvantilburg, 2022-05-29:
Hi there,

I have been wondering about the actual efficiency of detector for measuring a single muon, since I could not find any numbers on that. Has anyone performed such a measurement or are there some estimates on the efficiency? Presumably the efficiency depends on the muon path length and the distance between the muon path and the SiPM. It would also be interesting to know an estimate of the peak height (in mV) per detected photon in the SiPM. Does anyone know this number? With that information it might be possible to use Poissonian statistics to derive some efficiency number.

As a first and preliminary attempt I sandwiched 3 detectors: one master and two slaves. When a muon passes through the top and the bottom detector, I expect that it must have gone through the middle one. Hence, I can measure the efficiency of the middle detector. I found the coincidences between the two slaves (middle and bottom) using this [tool](https://jeroenvantilburg.nl/cosmicwatch/). With an hour of data taking the middle detector measures 117 hits out of the 163 that went through the top and the bottom detector (and have a peak height > 50 mV). This gives an efficiency of 72+-4 % which is averaged over the full surface in this flat orientation. Does this look reasonable? There are probably a few things that can be improved in this setup. In any case, I plan to make more efficiency measurements (longer, different orientations, different detectors, shielding) in the future. Let me know if you have suggestions.

spenceraxani, 2022-05-29:
Hi,

Good question — I’ve had the efficiency measurement on my back burner for quite a while. A

I’ve tried pulling out single photons to verify the gain curve as a function of over voltage, but have so far been unable to get the noise sufficiently low to measure it. I’m much more familiar with single photon detection with PMTs, where the integral of the single photon waveform divided by a load resistance of 50Ohms at gain of 10E7 gives a peak voltage of ~5mV. I was hoping my intuition would be sufficient for the SiPMs as well, although I think I’m missing something when applying this logic to the FAST and SLOW output of the SiPM. Anyways, hope to directly figure this one out in the future is a low noise power supply.

A group at the Departamento de Ciencias made a full Geant4 simulation of the detector to characterize the detectors 2019. Their paper can be found here: https://arxiv.org/pdf/1903.04562.pdf <https://arxiv.org/pdf/1903.04562.pdf>. The efficiency they found was roughly ~76%. I was actually expecting it to be much higher, in the 90s. If you removed the condition “>50mV” does your efficiency go up? Judging by the attached figure from the PhysicsPaper.pdf, it really looks like we’re not missing many events — that is, the coincident events are well above the low energy threshold. I bet we’re missing some corner clippers.

It should also be noted that the OLED screen itself causes about 5% dead time, so I’m guessing 8 out of 163 events happened while the screen on the middle detector was updating.

Thanks,

Spencer

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

jeroenvantilburg, 2022-05-30:
Oops, I did not realize that the OLED screen eats so much deadtime. Before I used to measure only in the SDCard mode, observed that the deadtime was negligible, and forgot about it. Looking again at the data files I now see that the deadtime is 18.6%. I completely overlooked this. This should explain why the efficiency was so low.

I have measured again the efficiency using the exact same setup, but know with the SD card code loaded into the Arduino. The measured deadtime according to Arduino code is now negligible (only 0.27%). Now (in slightly more that an hour) the middle detector sees 362 hits out of a total of 376 that went through both the top and the bottom. This gives an efficiency of (96.3 +- 1.0)%. Much closer to your expectations. This is without any requirements on the bottom detector. When I require that the hits in the bottom detector > 50 mV, the efficiency goes up to 326 / 336 = (97.0 +- 0.9)% (keep in mind that the requirement is on the trigger source; not the middle detector). If I compare this with the efficiency obtained with the OLED screen on, there is still some small gap when I correct for the dead time. Maybe the dead time calculation for the OLED code is a bit too small? In any case will make further efficiency measurements (with the SDCard code) in the near future.

It would still be good to know the peak voltage per photon. I do not really understand how you want to measure it (also I know little about PMTs). I thought of changing the REF voltage of the Arduino to some small number (say 100 mV) and hope to see the individual photon peaks in the (ADC of mV) histogram. This is how I am used to measure this number. However, the REF pin is already hardwired in the PCB, so this means modifying the board and/or cutting Arduino headers, which would not be so easy for me...

Thread 92 (2022-08-27):

Detector stops counting at higher temperatures

jeroenvantilburg, 2022-08-27:
My detectors stop counting when the internal temperature goes above 32-34 degrees Celsius. This happens to all 5 detectors when I put them in direct sunlight. Only the counting of particles stops, but the Arduino time (and presumably everything else) keeps on going (as observed with the OLED.ino). The temperature from the internal sensor is always a few degrees below the ambient temperature, so the actual temperature at which this happens is probably a few degrees higher.

I suppose this happens since the SiPM will suffer more from thermal noise at higher temperatures and consequently will cause the baseline as measured by the Arduino ADC to go up. My assumption is that the baseline goes above the RESET_THRESHOLD, which is why there are no further counts measured (when resetting the detector, only one count is measured). I have not tested this assumption since I have to scope at hand, but when I increase the RESET_THRESHOLD from the default 15 to 30, the detectors will happily continue counting at elevated temperatures. So increasing this number seems to solve this problem. Interestingly, I see that the default ino-files have increased this threshold from 15 to 25 about a year ago.

I thought I share this experience, and I am curious to know if anyone else has seen similar issues.

spenceraxani, 2022-08-27:
Hello,

Thanks for noticing this. I have not tested these detectors with different temperatures. I changed the default RESET_THRESHOLD to slightly higher values, since I heard/found a few newer detectors seemed to have a slight change in the baseline ADC value. I initially thought it was related to the manufacturing of new Arduino Nanos, but perhaps you are correct in correlating a temperature change to this.

Best,

Spencer

─
Dr. Spencer N. Axani
***@***.***

Assistant Professor
The University of Delaware
208 Sharp Lab
104 The Green, Newark, DE 19716
(608) 572-8426

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

Thread 95 (2022-09-29):

Position of SiPM resistor R12

Phoenix1747, 2022-09-29:
Hi, I was wondering why you chose to place the SiPM resistor R12 on the SiPM daughter board and not close to the first op amp stage and R4. Is this a deliberate choice or is it just a convenient place for this part?

Thanks!

spenceraxani, 2022-09-30:
Hi,

I choose to place it near the SiPM because that would allow you to have the signal output through the BNC connection without needed to populate the MainPCB. Although, in hindsight, I think I would have fully removed R12 to reduce the pulse attenuation going into the first amplifier. Right now the amplifier has to work pretty hard to amplify the signal.

Feel free to let me know if this doesn’t fully answer your question.

Thanks,

Spencer
─
Dr. Spencer N. Axani
***@***.*** ***@***.***>

Assistant Professor
The University of Delaware
208 Sharp Lab
104 The Green, Newark, DE 19716
(608) 572-8426

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

Phoenix1747, 2022-09-30:
> Although, in hindsight, I think I would have fully removed R12 to reduce the pulse attenuation going into the first amplifier. Right now the amplifier has to work pretty hard to amplify the signal.

Wouldn't fully removing R12 result in no current flow from the SiPM and therefore no signal? Or do you actually mean R4? I'm not sure how it would attenuate the signal either, to be honest.

spenceraxani, 2022-09-30:
It essentially has to do with terminating the line to match the impedance. When you terminate a 50Ohm line with a 50Ohm resistor, you pass the maximum amount of power, but the voltage gets cut in half (it acts as a voltage divider). If you do not terminate the line, you don’t get that 1/2 attenuation, but you end up with your signal reflecting. If the line is short, say from the SiPM to the first op amp, the reflection doesn't really matter, but when the line is long, say from the BNC to an oscilloscope, it does matter.

I sort of misspoke in my last message, I wouldn’t fully remove R12, instead I would put a ~1-10k resistor in its place. This gives the current a path to ground, but it also ~minimizes the attenuation of the signal (half attenuation of the signal to ~1-5% attenuation). Since the path from the SiPM to the first op amp is relatively short, there wouldn’t be significant reflections on this line. However, when you look at the signal on an oscilloscope, you would be forced to terminate the line at the oscilloscope.

─
Dr. Spencer N. Axani
***@***.*** ***@***.***>

Assistant Professor
The University of Delaware
208 Sharp Lab
104 The Green, Newark, DE 19716
(608) 572-8426

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

Phoenix1747, 2022-09-30:
Oh, I see now! So it has to do more with the BNC connector and the issues occuring due to external connections and not the SiPM/amplifier directly. Thanks!

Closed 2022-10-01.

Thread 96 (2022-11-01):

Low count rates

Kristalek, 2022-11-01:
Hi,

I have a problem with low count rates, after I turn it on, only 1 false count will appear. Im sending photos. Do you have any suggestion where could be the problem?

I built 2 main desks and 1 SiPM (doesnt work). I also checked if there are used right componets.

Have a nice day :)

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

spenceraxani, 2022-11-01:
Hi Kristalek,

Thanks for the photos, it looks like you did a good job building the detector. Hard to point out the exact component that is causing the problem, but given the images, the issue is likely one of the following:
	1. Most likely culprit: poor solder connection on one or more components in the amplifying/peak detection circuit. I would hit these components with new solder. Suspect connections are R4, R5, and R6. Very much R12 on the SiPM PCB.
	2. The solder connection on the SiPM looks OK, and I know that you tested the resistance in both directions, however, it’s a bit tough to say how good that connection is once you interfaced it with the scintillator.

I also noticed that you do not have optical gel on the SiPM. While this is not the cause of your problem, you will find that you get a low rate as fewer photons make it to the SiPM.

Thanks,

Spencer

─
Dr. Spencer N. Axani
***@***.*** ***@***.***>

Assistant Professor
The University of Delaware
208 Sharp Lab
104 The Green, Newark, DE 19716
(608) 572-8426

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

Kristalek, 2022-11-01:
Hi,

I tried to reheat and add more solder. Than I measured resistances and it equals of I think right values(because there are some resistance divisors, from scheme).

And nothing changed.

Do you have any suggestions?

Thanks for your time :)

spenceraxani, 2022-11-01:
Just to clarify, you are saying that you added new solder to every connection in the circuit? Including the resistors that I pointed to?

If you have a light-leak into the scintillator, that could also cause your problem. Are you sure that you taped the SiPM scintillator combo sufficiently well?

If so, and you are confident in your solder job on the SiPM, we can use an oscilloscope to narrow down the location of the problem. Since you have the correct voltage going to the SiPM, you should be able to connect the BNC output of the detector to an oscilloscope and search for the SiPM pulses. They will be ~10-100mV in height and ~250ns in length. If you see them, the issue must be in the amplifying or peak detector circuit. If not, the issue is with the SiPM PCB.

Thanks,

Spencer
─
Dr. Spencer N. Axani
***@***.*** ***@***.***>

Assistant Professor
The University of Delaware
208 Sharp Lab
104 The Green, Newark, DE 19716
(608) 572-8426

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

Kristalek, 2022-11-01:
Hi,

Yes I added new solder to connections including connections of resistors you mentioned.

Hmm. Are you saying that: If the scintillator isn't enought tight to the SiPM, it won't work, right?

Next time I'll be working on it, I'll try to look at the pulses.

Thanks for help.

spenceraxani, 2022-11-01:
The detector works by looking for small flashes of light from charged particles passing through the scintillator. If there is a light-leak, even the tiniest  one, into the scintillator it’ll saturate the detector and you wouldn’t see any pulses.

─
Dr. Spencer N. Axani
***@***.*** ***@***.***>

Assistant Professor
The University of Delaware
208 Sharp Lab
104 The Green, Newark, DE 19716
(608) 572-8426

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

Kristalek, 2022-11-03:
The problem was in a light leak.

Thank you for your time you spent solving problems. :)

Thread 97 (2022-11-04):

Measurement Code for Python 3+

0ort9, 2022-11-04:
Hey so the exe works fine on my windows, but i want to measure using my macbook and i can't get the python 2 code to run properly. I replaced all outdated functions. Has anyone managed to update the code and can send it to me? This would be awesome

jeroenvantilburg, 2022-11-04:
Depending on your use-case, you might find this website useful:
   https://jeroenvantilburg.nl/cosmicwatch/
It can take data on MacBook without having to install anything but the Chrome browser (no Safari).

Thread 99 (2023-01-20):

I accidentally ordered V1's PCB and parts.

ilkaydemirhan, 2023-01-20:
Hi,

I wanted to build Muon-Detector-v2.

In the process, I downloaded the purchasing list of both V1 and V2 to my computer. I also downloaded the Gerber files of both V1 and V2 as well.
While ordering the PCB, I accidentally ordered the PCB of V1. Then I ordered the parts for V1. So, I messed up the files.

This happened completely by accident. I caused this error myself. Because the PCB and purchasing list files of V1 and V2 had the same name and I mixed them up. And all orders have arrived.
Now I have two options. The first is to reorder the V2's PCB and parts (This is going to be expensive). The second option is to make V1.
If V1 works fine and is not very different from V2, I think I should do V1.

I'm asking you, which one would you recommend me between these two options?

Best Regards,

Ilkay

spenceraxani, 2023-01-20:
Hi IIkay

I would definitely go with V2. V2 has a lot of additional features that makes it a significant upgrade (coincidence connection and sdCard primarily). I’m happy to send you two V2 PCBs if you like though.

Most of the components between v1 and v2 are the same. So, you shouldn’t have to order too many new parts.

Thanks,

Spencer

─
Dr. Spencer N. Axani
***@***.*** ***@***.***>

Assistant Professor
The University of Delaware
203 Sharp Lab
104 The Green, Newark, DE 19716
(608) 572-8426

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

ilkaydemirhan, 2023-01-21:
Hi Spencer,

Thank you for your kind response. I will follow your advice and make V2.

Thank you for your kind suggestion. I like too much.

Best Regards,

Ilkay

ilkaydemirhan, 2023-02-01:
Hi Spencer,

I will reorder PCB and missing parts. I wanted to check compatibility of purchasing list and Gerber file.

1. PCB_Gerber_files_wLargerSnapOffConnectors.zip
2. Updated parts list last year.

I will order 1 and 2 if they are compatible with each other.

I would be glad if you comment on this.

Thanks,

Ilkay.

spenceraxani, 2023-02-01:
Hi IIkay,

If the files are contained in the same repository (v2), then the combination of 1 and 2 will work.

Thanks,

Spencer

─
Dr. Spencer N. Axani
***@***.*** ***@***.***>

Assistant Professor
The University of Delaware
203 Sharp Lab
104 The Green, Newark, DE 19716
(608) 572-8426

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

ilkaydemirhan, 2023-02-01:
Hi Spencer,

Yes both are from the same repository but there are two Gerber files. One was changed 5 years ago, the other was changed last year.

I guess I should use the Gerber file modified last year.

Thanks,

Ilkay

spenceraxani, 2023-02-01:
All the files are actually fine. The newest file was generated with larger snap-off connections since a company in Europe required them. The electronics part list was only updated to include new link for components that were out of stock due to the global chip shortage.

─
Dr. Spencer N. Axani
***@***.*** ***@***.***>

Assistant Professor
The University of Delaware
203 Sharp Lab
104 The Green, Newark, DE 19716
(608) 572-8426

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

ilkaydemirhan, 2023-02-01:
Hi Spencer,

I understand.  Thank you for the information.

Best Regards,

Ilkay.

Thread 100 (2023-01-25):

2 Different kind of PCB

Miriamxan, 2023-01-25:
Hi Spencer,

I builded a detector before with some different components, for example AD8604 instead of  LT1807. It worked for a while and then it has stopped working. Then  I ordered all the components just the same with yours. Any of them (I tried to build 6 detectors ) is not working, there is no signal. It is just triggered and then nothing...
So I m trying to understand the reason, I took a voltage measurement over each element. There is no electric on R8, R16 and R15. But I can get the 29.50 V on Sipm connector. I wonder if u can say something on this situation.

Also , I printed two different types of pcb unconciously . One of them has some "NS" footprints that u write on the smt populating list. Other one doesnt have that NS component s footprints. So no need to take care.
I used the first one that has not any footprint belong to "NS" components. So what do you think about which one ı should use?

Thanks,
Meryem

spenceraxani, 2023-01-26:
Hi Meryem,

Thanks for the email. The AD8604 is not suitable for this application. The bandwidth and slew rate are much too low for the input signal. There are likely other issues with it as well, but those two alone make it insufficient.

You’ll likely have to do some troubleshooting to identify the problem. Since you confirmed that you measure the correct voltage going to the SiPM (~29V), that means that you are able to test to see if you populated the SiPM board correctly. After interfacing the SiPM to scintillator, and taping it up, you can plug the BNC output into an oscilloscope. If your SiPM PCB was properly built, you should see the SiPM pulses. They are 10s of mV in height and 100s of ns in width, triggering the detector at the Hz rate. If you do not observe these, that means that a problem lies in the SiPM PCB, otherwise, you can move on to see if that signal get’s amplified at test point 2 (TP2).

NS refers to “No stuff” which means not to populate that component. Those board should be fine, if they came from the v2 repository.

Thanks,

Spencer

─
Dr. Spencer N. Axani
***@***.*** ***@***.***>

Assistant Professor
The University of Delaware
203 Sharp Lab
104 The Green, Newark, DE 19716
(608) 572-8426

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

Miriamxan, 2023-01-28:
Hi again Spencer,

Thanks a lot for your answer. Yeah, I actually was pretty sure about AD8604 but we couldnt find LT1807 that time so I wanted to use another TIA opamp. It worked for a while or we thought ıt worked :)
Whatever, I builded 5 detectors. I also followed their SiPM signal on oscilloscope as u said. I couldnt get any signal like you described. It is obvious there is a problem on SiPM Pcb. But I'm also skeptical about PCBs in general. So I prepared an excel file that shows Voltages of some important components for each of them. If you see something that ı cant understand maybe it can help me. So also these are some informations about my detectors ;
- I couldnt use any optic jel between SiPM and Scintillator , still waiting for order
- 2 detectors has 1k Ferrite Bead not 2.5 k. I m not sure if it s that much important or not
 Except these , all the same as yours.  Sorry to ask so many questions but  I m so interested in this project because I will have the opportunity to visit many cities in the world in the coming period, I want to use the detector in the places I go. Thanks a lot.
[5 detectors.xlsx](https://github.com/spenceraxani/CosmicWatch-Desktop-Muon-Detector-v2/files/10528401/5.detectors.xlsx)

spenceraxani, 2023-01-30:
Hi,

Since you get 29.5V on the HV connection to the SiPM board and do not see pulses out the BNC connection, that localizes the problem (or one of the problems) to the SiPM PCB. The most common issue on this board is the orientation of the SiPM or a poor solder connection on the SiPM. Feel free to send me a picture of your boards — I might be able to identify the problem. It is a bit surprising that you cannot extract pulses through all 5 of the detectors, are you confident that you are using your oscilloscope correctly?

The ferrite bead doesn’t really matter, any value would be fine. The lack of optical gel would reduce the amount of light you see by a significant amount, which means that many events fall below your trigger threshold and do not trigger the detector. But, even without it, you should still see ~0.5Hz or so.

Thanks,

Spencer

─
Dr. Spencer N. Axani
***@***.*** ***@***.***>

Assistant Professor
The University of Delaware
203 Sharp Lab
104 The Green, Newark, DE 19716
(608) 572-8426

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

Miriamxan, 2023-01-30:
Hey,

I attached some pics of detectors. So you can see all populated components and their direction. Also I tested SiPM for both direction.  You can see also Oscilloscope and my style of using:) Tbh I used to use manual oscilloscope but this one eaiser to use so I hope I m using in correct way.
Thank you very much in advance for all your help really.

All the best,
Meryem

[CosmicWatch.Meryem.zip](https://github.com/spenceraxani/CosmicWatch-Desktop-Muon-Detector-v2/files/10539799/CosmicWatch.Meryem.zip)

spenceraxani, 2023-01-31:
Hi Meryem,

Thanks for the video and images. I can see that the scintillator is not fully light-tight — there are regions around the corners that aren’t fully taped up which would prevent the detector from functioning. The scintillator needs to be fully light-tight.

Thanks,

Spencer

─
Dr. Spencer N. Axani
***@***.*** ***@***.***>

Assistant Professor
The University of Delaware
203 Sharp Lab
104 The Green, Newark, DE 19716
(608) 572-8426

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

ilkaydemirhan, 2023-02-01:
Hi Meryem,

I'm living in Ankara. Where do you live?

Where did you get the parts?  Especially SIPM and scintillator?

Thanks,

Ilkay.

Miriamxan, 2023-02-01:
Hi İlkay,

I m in İstanbul, and working on CosmicWatch for a project. We bought all components from abroad, different countries. But ı can send the companies who can get these components. You can reach me on instagram if u use.
(lafenetre_demarie)

Thanks,
Meryem

Thread 101 (2023-02-02):

LT1807 Replacement

alex-stendahl, 2023-02-02:
Hi,

Currently the LT1807 is out of stock so is it possible to replace it with for example LTC6227HMS8E? What parameters should one look at to see if a amp is a suitable replacement for LT1807, I saw at least that slew rate and bandwidth are important, and im assuming the voltage supply span. Are there others?

Best,
Alex

spenceraxani, 2023-02-02:
Hi Alex,

It’s hard to say without trying it. There are many many different ways that would prevent a direct substitution for another op amp. The thing that stands out to me with the LTC6227 is that it says:

"The LTC6226/LTC6227 are optimized for high bandwidth applications, and have not been designed to directly drive capacitive loads.”

The peak detector is a very large capacitive load (10nF). So this may be a deal breaker. The output swing low is also about twice as high as the LT1807, which means that you may not see the smaller pulses.

You need an op amp that includes the negative rail on the input, and get’s as close to the negative rail on the output. With sufficient bandwidth and slew rate, that can operate on single supply, that can also drive capacitive loads. A different input offset voltage could also cause problems. That being said, if you find an op amp with those characteristics, the component values around the op amp would likely need to be changed, for the feedback and gain resistors may need to be selected differently.

I personally tried substituting tens of different op amps directly, without success. It’s my fault though — I should have designed the circuit differently. I didn’t anticipate the LT1807 being out of stock.

Thanks,

Spencer

─
Dr. Spencer N. Axani
***@***.*** ***@***.***>

Assistant Professor
The University of Delaware
203 Sharp Lab
104 The Green, Newark, DE 19716
(608) 572-8426

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

alex-stendahl, 2023-02-02:
Hi,

Then I would also say it would not work as a replacement. Maybe one could try but as a working-out-of-the-box its not suitable.

My followup question is that the part LT1807CMS8 should be identical to the correct part except a lot smaller roiht? So it should work normally if one adapts the footprint somehow?

Best,
Alex

spenceraxani, 2023-02-02:
I think if you could adapt the form factor, it should work.

─
Dr. Spencer N. Axani
***@***.*** ***@***.***>

Assistant Professor
The University of Delaware
203 Sharp Lab
104 The Green, Newark, DE 19716
(608) 572-8426

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

Closed 2023-02-02.

Thread 102 (2023-02-03):

Different SiPMs

ilkaydemirhan, 2023-02-03:
Hi Spencer,

SiPM (MICROFC-60035-SMT-TR) specified in the parts list is difficult to obtain and has a high price in a single order. That's why I'm looking for similar cheap SiPMs.

I found a 3x3mm SiPM (AFBR-S4N33C013) from Broadcom.
[AFBR-S4N33C013-DS103.pdf](https://github.com/spenceraxani/CosmicWatch-Desktop-Muon-Detector-v2/files/10575740/AFBR-S4N33C013-DS103.pdf)

The critical values of this SiPM are the same as the other.

Can I use this SiPM? Or are there any other different SiPMs you recommend?

There's also the Silicon PIN Photodiode. Specifically, BPX61 has an operating voltage and recommended wavelength from 400 nm to 1100 nm.
[BPX61.pdf](https://github.com/spenceraxani/CosmicWatch-Desktop-Muon-Detector-v2/files/10575856/BPX61.pdf)

Can Silicon PIN Photodiodes be used in this project?

I will use a polystyrene based plastic scintillator (50mmx30mmx10mm) given to me for testing from [TENMAK](https://www.tenmak.gov.tr/en).
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

I also have a 342mmx280mmx8mm CSI scintillator used in radiography detectors. I got this from a junkyard. Can I cut it to size and use it in this project?
[CareRay_1500L_Xtron.pdf](https://github.com/spenceraxani/CosmicWatch-Desktop-Muon-Detector-v2/files/10576094/CareRay_1500L_Xtron.pdf)
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

Sorry for too many questions.

I have other questions unrelated to this project. Are there other platforms where muon detectors, scintillators, gamma spectroscopy, amateur or professional projects are discussed or I can ask questions? Maybe I can find answers to my questions there. Because I don't want to keep this place busy with different issues.

Best Regards,

Ilkay.

spenceraxani, 2023-02-03:
Hi,

Here is a good link for the SiPMs:
https://www.mouser.com/ProductDetail/onsemi/MICROFC-60035-SMT-TR?qs=byeeYqUIh0NL1tLUEc9yUw%3D%3D <https://www.mouser.com/ProductDetail/onsemi/MICROFC-60035-SMT-TR?qs=byeeYqUIh0NL1tLUEc9yUw==>

I would go with these, rather than try to move to a different SiPM. I have detectors that work on the AFBR 3x3 SiPMs, although they are harder to mount, and are 1/4th the size (so each event is ~1/4 as bright). I haven’t tried the PIN diodes for this kind of detector.

Thanks,

Spencer

─
Dr. Spencer N. Axani
***@***.*** ***@***.***>

Assistant Professor
The University of Delaware
203 Sharp Lab
104 The Green, Newark, DE 19716
(608) 572-8426

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

Thread 103 (2023-02-08):

Arduino sketch not  working  !! please help

musketsmoke, 2023-02-08:
anyone have a working sketch as i keep getting the same error, Compilation error: Adafruit_SSD1306.h: No such file or directory

i  am  so close to finishing and failing at this stage,  i am a hardware guy cant do this software stuff i am lame lol

can someone please just upload a working sketch for the cosmic watch v2 that works in one file  not 3 to  join together, been trying to sort this for days and days one error  is  killing me or where and how  to fix it much appreciated
Please help

spenceraxani, 2023-02-09:
Hi,

The error is stating that you do not have the Adafruit_SSD1306 library installed. You’ll need to go to Sketch->Include Libraries->Manage Libraries, search for Adafruit_SSD1306, and install Version 1.0.1.

You’ll then receive the same error for the other libraries as well. But you can just follow the same procedure. The information is listed in the first few lines of code.

Thanks,

Spencer

─
Dr. Spencer N. Axani
***@***.*** ***@***.***>

Assistant Professor
The University of Delaware
203 Sharp Lab
104 The Green, Newark, DE 19716
(608) 572-8426

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

musketsmoke, 2023-02-09:
Hello Dr Spencer

sorry to  bother you, i am  having huge trouble  with these sketches.
No matter what i do trying different loading  of what you said i should do i keep getting  errors.
Loading the Naming.ino alone there is no problem, putting the OLED sketch under the naming sketch i get loop errors
i have tried loading all 3 more errors and i different orders.
What  am i doing wrong? IS there  a file that i can just upload that is  stitched together so all i  have to do is add the library's  and it works ?  there are more than one wire and  spi file which one ?
if i am having trouble with  this software i am so scared when am i if i am  going  to get it working let  alone  setting it up if it works i  am so useless with software
i  have already  made investments in most components for 10 to be made as  i am in the UK its quite expensive to import the required things, here is my email if its easier to send a file please clit3100@yahoo.com
thank you for helping  me and  sorry to bother you with my issue.

spenceraxani, 2023-02-10:
Hi,

The naming.ino file writes the chosen name of your detector to long term memory (non-volatile memory called EEPROM). After uploading the Naming sketch, your detector permanently remembers that name.

After that, you can upload the OLED.ino or SDCard.ino sketch. You do not need to put the OLED code “under” the naming sketch. Your detector will not forget the name that it was given using the Naming.ino sketch.

Feel free to let me know if that doesn’t solve your issue.

Thanks,

Spencer

─
Dr. Spencer N. Axani
***@***.*** ***@***.***>

Assistant Professor
The University of Delaware
203 Sharp Lab
104 The Green, Newark, DE 19716
(608) 572-8426

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

musketsmoke, 2023-02-11:
Hello Dr Spencer

if  i understand  i  only upload the naming sketch too the nano, nothing  else
i am building the motherboards  and came across the reference NS for  R10-R14-R18-R19-R25-U7
i have  never seen the reference on any other diagram before can you clarify this for me please NS

Thank you

spenceraxani, 2023-02-12:
Hi,

Once you upload Naming.ino, it stamps the name that you chose into the Arduino’s long term memory. After that, you can upload OLED or SDCard.

NS refers to No-Stuff, which means that you should just ignore those footprints.

Thanks,

Spencer

─
Dr. Spencer N. Axani
***@***.*** ***@***.***>

Assistant Professor
The University of Delaware
203 Sharp Lab
104 The Green, Newark, DE 19716
(608) 572-8426

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

Thread 104 (2023-02-26):

TP3 always high

alex-stendahl, 2023-02-26:
Hi Spencer,

Bit of a tricky question. I built two circuits and had them working for a while. However now when i try them both have A0/TP3 always on high, even without a SiPM connected. Im guessing something is shorted or similar but i can tfigure out what. Would you happen to be able to help what part of the circuit is bad?
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

Best,
Alex

spenceraxani, 2023-02-27:
Hi Alex,

You may have to have the SiPM PCB connected to see TP3 go low. Without it, the input line has no reference to ground, which could cause the problem. I also notice that there are several connections that need to be check (circled below), and since there appears to be broken connections, I would start by adding some new solder to each solder joint.

Thanks,

Spencer

─
Dr. Spencer N. Axani
***@***.*** ***@***.***>

Assistant Professor
The University of Delaware
203 Sharp Lab
104 The Green, Newark, DE 19716
(608) 572-8426

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

Thread 105 (2023-04-11):

Trouble to set detectors to Coincidence mode

Kristalek, 2023-04-11:
Hello,

I have a problem with setting two detectors to coincidence mode. I saw a video on Youtube, did the same but it did not work. I am using the code witch is cooperating with SD card. Do you have any idea?

Have a nice day

spenceraxani, 2023-04-12:
Hi,

The 3.5mm connectors are often rather tight when used for the first few times. Could you make sure that you’ve inserted the cable properly? I often see that the cable is not quite fully inserted.

Other than that, there’s little else that could be going wrong. I would check the solder connections on the 3.5mm connector.

Best,

Spencer

─
Dr. Spencer N. Axani
***@***.*** ***@***.***>

Assistant Professor
The University of Delaware
203 Sharp Lab
104 The Green, Newark, DE 19716
(608) 572-8426

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

Thread 106 (2023-07-19):

problem uploading the code onto audrino nano for V2.

megami333, 2023-07-19:
I'm building the Cosmic muon detector with a partner for our internship. We just got the audrino in and wanted to upload the code onto it while we wait for te other components to come in. The thing is, we're having issues uploading the code. We're not completely familiar with coding and uploading codes. The issue we ran into is that we cannot upload the Naming.ino and SDcard.ino separately. When we tried to put them together and run it, errors pooped up. Again, I'm not familiar with coding so if you or anyone else can provide like a step-by-step explanation on how to exactly upload this code into the audrino nano, it'd be greatly appreciated. Thank you.

megami333, 2023-07-20:
> Hi, There is no need to modify them in any way. After you upload Naming, it will imprint the name you chose into the permanent memory of the Arduino. Then when you upload the SDCard, it will remember the name. Thanks, Spencer ─ Dr. Spencer N. Axani ***@***.*** ***@***.***> Assistant Professor The University of Delaware 203 Sharp Lab 104 The Green, Newark, DE 19716 (608) 572-8426
> […](#)
> On Jul 19, 2023, at 2:50 PM, megami333 ***@***.***> wrote: I'm building the Cosmic muon detector with a partner for our internship. We just got the audrino in and wanted to upload the code onto it while we wait for te other components to come in. The thing is, we're having issues uploading the code. We're not completely familiar with coding and uploading codes. The issue we ran into is that we cannot upload the Naming.ino and SDcard.ino separately. When we tried to put them together and run it, errors pooped up. Again, I'm not familiar with coding so if you or anyone else can provide like a step-by-step explanation on how to exactly upload this code into the audrino nano, it'd be greatly appreciated. Thank you. — Reply to this email directly, view it on GitHub <#106>, or unsubscribe <https://github.com/notifications/unsubscribe-auth/AANF5O7F6HVZS6FSIT3W6NDXRAT7BANCNFSM6AAAAAA2QK3SFU>. You are receiving this because you are subscribed to this thread.

Yes yes thank you so much, we firgured that out thankfully but we ran into another error. We looked it up but its still confusing. This is the error we're getting now: Arduino Error avrdude: stk500_getsync(): not in sync: resp=0x00

We're unsure how to solve this error. Your guidance is greatly appreciated!

Thank you & best regards!

megami333, 2023-07-20:
Yes yes thank you so much, we firgured that out thankfully but we ran into another error. We looked it up but its still confusing. This is the error we're getting now: Arduino Error avrdude: stk500_getsync(): not in sync: resp=0x00

We're unsure how to solve this error. Your guidance is greatly appreciated!

Thank you & best regards!

megami333, 2023-07-20:
We just wanted to add, that right now we have the Board set to "Arduino Nano", the Port set to "/dev/cu.Bluetooth-Incoming-Port" (as this is the only option), the Processor set to "ATmega328P (Old Bootloader)", and the Programmer set to "AVRISP mkII"

Thread 107 (2023-07-20):

Cannot run detector_server.py or import_data_py3.py

fbarradas, 2023-07-20:
This is what happens if I try to run detector_server.py  (from Spyder from MacOS 13.4.1):
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

and  if I try tro run  import_data_py3.py:
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

fbarradas, 2023-07-20:
And this is the same working from the Linux terminal
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

spenceraxani, 2023-07-20:
Hi,

Where did the detector_server.py code come from? In the Arduino folder there is only import_data.py.

It looks like the first error is just that the code has spaces instead of indents, and your text editor cares about that. You would have to change the spaces into tabs, or tabs into spaces.

The second error relating to threads. I cannot test it at the moment. But I see that we are importing something called _thread, whereas the text uses something called thread. My guess is that you should be able to change thread->_thread and it will work.

Best,

Spencer

─
Dr. Spencer N. Axani
***@***.*** ***@***.***>

Assistant Professor
The University of Delaware
203 Sharp Lab
104 The Green, Newark, DE 19716
(608) 572-8426

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

anthfuller, 2023-07-26:
I'm also seeing this error code, running "import_data_py3.py" as well. When running the script, there are five choices, the last being [h] for help. When selecting option "1", Record data on computer, the script prompts for a USB Port number, entering the number, I get this error:
Traceback (most recent call last):
  File "/home/radiomuon/muon/CosmicWatch-Desktop-Muon-Detector-v2/Recording_Data/import_data_py3.py", line 195, in <module>
    port_name_list.append(str(port_list[int(ArduinoPort[i])-1]))
IndexError: list index out of range

Can you help with this, looks like an issue with the script on line 195?

spenceraxani, 2023-08-01:
Hi,

Would you be able to post a screen shot? Does your computer see the Arduino? As in, were you able to upload the code to the Arduino through the Arduino IDE?

Thanks,

Spencer

─
Dr. Spencer N. Axani
***@***.*** ***@***.***>

Assistant Professor
The University of Delaware
203 Sharp Lab
104 The Green, Newark, DE 19716
(608) 572-8426

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

JG-QuarkNet, 2024-07-02:
@anthfuller Your "IndexError: list index out of range" error is different from the previous errors in this thead and likely has a separate solution.  Fortunately I had the exact same problem, which I traced to this issue: https://github.com/arduino/help-center-content/issues/155

The Linux BRLTTY utility for braille displays is sometimes enabled by default, and has been in particular for recent versions of Ubuntu.  Unfortunately, BRLTTY is programmed to take over serial ports automatically, which interferes with the `import_data_py3.py` script's scan of your ports.

You can confirm whether or not this is your problem by checking `dmesg` output related to tty and looking for a line that cites 'brltty' like the following:

```
$ sudo dmesg | grep tty
[ 5339.669621] usb 3-4: usbfs: interface 0 claimed by ftdi_sio while 'brltty' sets config #1
```

If you don't need the `brltty` utility, the easiest solution is to uninstall it with `$ sudo apt remove brltty` (for Debian/Ubuntu, adapt for your distribution as necessary).

If you do need the `brltty` utility, you'll have to find another way to make it let go of the ports.  There's more info on that Arduino [GitHub issue](https://github.com/arduino/help-center-content/issues/155) I posted above.

Thread 108 (2023-07-20):

Troubleshooting

0ort9, 2023-07-20:
Hello Spencer,

building my third Watch right now and slowly getting a routine. :) I am still in love with the project! Thank you so much.

I have finished everything but did not get any detections. I tested the voltage on the main PCB which is fine. I tested the SiPM pulse with the BNC and tp1 and it looks good, but I do not get a signal on tp2.

So something between tp1 and tp2 is not working. Could you help me verify which parts could be responsible? Is it only the Amplifying circuit?

Thank you in advance and have a nice day

0ort9, 2023-07-20:
tp2 shows a signal now but tp 3 does not yet :D

Doe the 1807 brakes fast with too much heat? It looks like the side is a little melted. Might have to replace it

spenceraxani, 2023-07-20:
Hi,

Looks like you have a problem with the op amp, the LT1807. It should not get hot. TP2 is the amplified version of TP1, via the op amp. Since you saw TP1, the problem is somewhere in the op amp or the amplifying part of the circuit. You may have either put it on backwards, or shorted something. I would replace it, double check the orientation, and make sure the legs aren’t bridged.

Best,

Spencer

─
Dr. Spencer N. Axani
***@***.*** ***@***.***>

Assistant Professor
The University of Delaware
203 Sharp Lab
104 The Green, Newark, DE 19716
(608) 572-8426

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

Thread 109 (2023-07-29):

Arduino Port not found

anthfuller, 2023-07-29:
Getting issues when running python3 import_data_py3.py and making a selection (1), Record data on to the computer. After getting "Selected operation:1 Available serial ports:

Nothing is showing up for the ports. When I run lsusb in Linux (Ubuntu 22.04), getting the QinHeng Electronics HC340 serial converter showing up on Bus 001 Device 018 and ID number.

What am I doing wrong, I though Linux, doesn't require the Arduino drivers or did I miss a step installing software?

Thank you

anthfuller, 2023-07-30:
Disregard, issue was with my Ubuntu 22.04 PC, hardware maybe? Switched to Windows 10

anthfuller, 2023-07-30:
Closing

Closed 2023-07-30.

Thread 110 (2023-09-04):

Troubleshooting again

0ort9, 2023-09-04:
Hello Spencer,
I could need some input from your side for one of our non-working main PCBs. TP1 and TP2 show great signals, TP3 shows some weird reversed peak:
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
We measured every component after TP2. Is there a way to check if the LT1807 is still working?

spenceraxani, 2023-09-05:
Hi,

That’s a new one. I can’t say for sure. Were TP1 and TP2 positive pulses? If TP2 is amplifying the signal, I think it’s a good indication that the LT1807 is working fine. For TP3, you cannot terminate the line to 50Ohms at the input to the scope, otherwise, that additional path to group will cause the pulse to decay away too quickly. You aren’t inverting the pulse on the oscilloscope are you? My recommendation would simply be to reassess your soldering and the components on the peak detector circuit. It’s going to be one of those components causing the problem.

Best,

Spencer

─
Dr. Spencer N. Axani
***@***.*** ***@***.***>

Assistant Professor
The University of Delaware
203 Sharp Lab
104 The Green, Newark, DE 19716
(608) 572-8426

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

spenceraxani, 2023-09-05:
Is TP1 by chance terminated to 50Ohms and TP2 not? That would cause a factor of 2x difference between the two.

─
Dr. Spencer N. Axani
***@***.*** ***@***.***>

Assistant Professor
The University of Delaware
203 Sharp Lab
104 The Green, Newark, DE 19716
(608) 572-8426

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

Thread 111 (2023-09-19):

Seperate Detection Rates

Oskarti, 2023-09-19:
Hi Spencer,

Sorry for bothering you, but can you help me? I've built 3 detectors however 2 are coming in at a rate of ~1.5 while the other is coming at ~0.7. (measurements were taken at about 14 meters above sea level.) I've identified that the problem is in the scincilltor or in the scincilltor PCB board and not in the main PCB. However even after re-taping the scincilltors and resoldering the scincilltor PCB board, I am still getting the same results. What do you suggest I should do?

The only difference that I can identify between the scincilltors is that the one coming in at a rate of 0.7 has more bubbles, but the amount is not significant. However, do you think this could possibly be the cause of the problem?

To lower the count rate to ~0.5 I am having to set the threshold to 93 for the 0.7 and 186 for the 1.5. Is this logical, or would this mess with the results?

I have also noticed that the ones clocking in at a rate of 1.5 tend to have higher energy levels. (This is just information unless proved to be useful.)

Thanks for giving me some of your time.
-Oskarti

spenceraxani, 2023-09-19:
Hi Oskarti,

I would probably stick with the default thresholds. My bet is that your SiPM PCB with the lower count rate is missing optical coupling. That would explain the rate difference and the energy levels. It’s roughly the scale I would expect as well.

Best,

Spencer

─
Dr. Spencer N. Axani
***@***.*** ***@***.***>

Assistant Professor
The University of Delaware
203 Sharp Lab
104 The Green, Newark, DE 19716
(608) 572-8426

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

Thread 112 (2023-10-10):

UKRAA CosmicWatch Detector

PaulHearn92, 2023-10-10:
We now have a number of universities and schools in the UK running student projects - a wonderful device for STEM education.  Thank you CW team.
I have been trying to contact Spencer at his new University, but I think I have the wrong address.  Can he contact me at:   paul@hearn.org.uk
Thanks.

Thread 113 (2024-02-07):

Coincidence confusion

WRJOLLY, 2024-02-07:
I am trying to setup two Cosmic watches in coincidence mode where can I find the coincidence.ino code mentioned in the instructions PDF? or could I just use the SD.ino code for both?
thank you

spenceraxani, 2024-02-08:
Hi,

Using either the OLED.ino or SDCard.ino code will boot them up in coincidence mode, if they are connected via the 3.5mm cable.

Best,

Spencer

─
Dr. Spencer N. Axani
***@***.*** ***@***.***>

Assistant Professor
The University of Delaware
203 Sharp Lab
104 The Green, Newark, DE 19716
(608) 572-8426

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

WRJOLLY, 2024-02-23:
Coincidence detection works great, but I would like to get coincidence detection with roughly 8 to 9 cm space between each scintillator. Is there a way to change the 30us delay between the master and slave scintillators in the code?

spenceraxani, 2024-02-23:
Hi,

Sorry I don’t think I quite follow. You still will get coincidence detection when they are spaced some distance apart, it’s just that the rate will decrease as the distance increases. The muons are traveling relativistically, and will pass through both detector within approximately 0.3ns (when 10cm apart).

Best,

Spencer

─
Dr. Spencer N. Axani
***@***.*** ***@***.***>

Assistant Professor
The University of Delaware
203 Sharp Lab
104 The Green, Newark, DE 19716
(608) 572-8426

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

Thread 114 (2024-03-17):

Discontinued part for V2 build

gimmeAll, 2024-03-17:
Part No. 490-4063-1-ND seems to be discontinued, and while there are somewhat similar parts that can supplement this one, there isn't a clear direct alternative available. I would like to build this project, but I am not sure how crucial this part is towards the overall function of the device, so any advice would be appreciated.

spenceraxani, 2024-03-17:
Hello,

Anything with similar specs should be fine for this component. Essentially, an inductor 10uH - 47uH should all be roughly equivalent. Here’s an example:

https://www.digikey.com/en/products/detail/w%C3%BCrth-elektronik/744032100/2626176￼
744032100 | Digi-Key Electronics
digikey.com

Thanks,

Spencer
─
Dr. Spencer N. Axani
***@***.*** ***@***.***>

Assistant Professor
The University of Delaware
203 Sharp Lab
104 The Green, Newark, DE 19716
(608) 572-8426

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

Thread 115 (2024-03-19):

I have an issue taking data from  two detectors

Omadre69, 2024-03-19:
I have two detectors and i want to run the import.py application to collect data from both arduinos.
Lets say that they have designated com ports 6 and 7.
However when it comes to selecting ports
[1] COM port 6
[2] COM port 7

 when select: 1,2
 the import._data .exe shuts down instantly
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

jeroenvantilburg, 2024-03-19:
Rather than the python script I would suggest to use my webapp instead:CosmicWatch readoutjeroenvantilburg.nlOp 19 mrt 2024 om 11:32 heeft Omadre69 ***@***.***> het volgende geschreven:
I have two detectors and i want to run the import.py application to collect data from both arduinos.
Lets say that they have designated com ports 6 and 7.
However when it comes to selecting ports
[1] COM port 6
[2] COM port 7
when select: 1,2
the import._data .exe shuts down instantly
Troubleshooting.jpg (view on web)

—Reply to this email directly, view it on GitHub, or unsubscribe.You are receiving this because you are subscribed to this thread.Message ID: ***@***.***>

spenceraxani, 2024-04-01:
Hi,

That’s a bit strange of a problem. Are you able to record from a single detector? And, are you sure that those are your two detectors? Often [1] is some bluetooth connection.

You could try adding some print statements to the code to see where it is shutting down. Do your detectors have names? I noticed that if you don’t provide a name via the naming.ino code, you get some non-ascii characters which could potentially cause an issue.

Best,

Spencer

─
Dr. Spencer N. Axani
***@***.*** ***@***.***>

Assistant Professor
The University of Delaware
203 Sharp Lab
104 The Green, Newark, DE 19716
(608) 572-8426

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

Thread 116 (2024-03-26):

Concerns with linked parts not matching description in purchasing list

gimmeAll, 2024-03-26:
I am just asking if the linked digikey parts are ok to buy even though the descriptions in the purchasing list do not match the linked part's description: the ferrite bead being 1kohm, yet stated as 2.5kohm on the list; the .1 uf and 1uf ceramic capacitor's temperature coefficient being Y5V, yet stated as X7R; the 	Linear Voltage Regulator being 250ma, yet stated as 300ma. That is all I have found so far, yet there might be more. I know it is probably not an issue, I just wanted to ask.

spenceraxani, 2024-04-01:
Hi,

All those are fine and won’ t affect the functionality of the detector. Thanks for the notes though.

Best,

Spencer

─
Dr. Spencer N. Axani
***@***.*** ***@***.***>

Assistant Professor
The University of Delaware
203 Sharp Lab
104 The Green, Newark, DE 19716
(608) 572-8426

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

dedwid, 2025-02-05:
Hi, I know it probably won't affect the circuit as well, but I've also found another unmatched description: In digikey's description, the 20nF capacitor has a voltage of 100V instead of the 50V stated on the purchasing list. Could this difference lead to an issue on the circuit? I just want to make sure before purchasing all the components :)
Thanks in advance.

spenceraxani, 2025-02-05:
Hi,

Thanks for the question. That won’t have an impact. That’s the maximum voltage allowed for the capacitor. The actual voltage on the capacitor is only a few volts.

Best,

Spencer

─
Dr. Spencer N. Axani
***@***.*** ***@***.***>

Assistant Professor
The University of Delaware
203 Sharp Lab
104 The Green, Newark, DE 19716
(608) 572-8426

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

Thread 119 (2024-08-14):

Trouble finding the coincidence.ino code

SophieRAllen, 2024-08-14:
Hi,
I am doing this project as part of an EPQ at school and am quite new to programming. However, I can’t seem to find the coincidence code to upload into the IDE. Where can I find it and do I have to install any other libraries aside from the CH340g and those listed on the README file?
Thanks,
Sophie

spenceraxani, 2024-08-14:
Hi Sophie,

The Arduino Code is located in the Arduino folder. You can either upload the OLED or SD Card code — the Arduino isn’t powerful enough to run both at once.

In either of the pieces of code, the first few lines tell you which libraries are needed to be installed.

Specifically, you need to install:

  Requirements: Sketch->Include->Manage Libraries:
  1. Adafruit SSD1306     -- by Adafruit Version 1.0.1
  2. Adafruit GFX Library -- by Adafruit Version 1.0.2
  3. TimerOne             -- by Jesse Tane et al. Version 1.1.0

Best,

Spencer

─
Dr. Spencer N. Axani
***@***.*** ***@***.***>

Assistant Professor
The University of Delaware
203 Sharp Lab
104 The Green, Newark, DE 19716
(608) 572-8426

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

hunnicho, 2024-09-16:
Hi Spencer,

I am also struggling with this issue. I cannot seem to find the coincidence.ino code in the Arduino folder.

I'm able to see the naming, OLED, and SD Card code and have installed the correct libraries, however the coincidence.ino file that the condensed instructions reference does not seem to be available.

Is it in a different location or was it possibly renamed?

Thank you,

Hope

spenceraxani, 2024-09-17:
Hi Hope,

Sorry, that might be a typo. Both the OLED and SD Card.ino code have the coincidence stuff built into it.

Best,

Spencer

─
Dr. Spencer N. Axani
***@***.*** ***@***.***>

Assistant Professor
The University of Delaware
203 Sharp Lab
104 The Green, Newark, DE 19716
(608) 572-8426

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

Thread 120 (2024-10-29):

Additional Obsolete Components

matthewvandenberk, 2024-10-29:
Hello Dr. Axani,

The ferrite bead (part no. 587-1919-1-ND) is no longer manufactured, and I was unable to find an equivalent part.

You gave a range of specs for the obsolete inductor in Issue #114, is there also a range of acceptable specs for this component?

Thanks,
Matthew Vanden Berk

spenceraxani, 2024-10-29:
Hi Matthew,

You can put in a 0Ohm resistor in its place, or any other ferrite bead. It won’t affect the circuit.

Best,

Spencer

─
Dr. Spencer N. Axani
***@***.*** ***@***.***>

Assistant Professor
The University of Delaware
203 Sharp Lab
104 The Green, Newark, DE 19716
(608) 572-8426

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

Thread 121 (2024-11-17):

SiPM is Working but the detector is not reading any signals

IpsiChaudhary, 2024-11-17:
Hello! It has been really fun to work on this project. However, we are running into some issues. When we attach the wrapped scintillator to the board, we do not get any meaningful signal as we expected.

However, we are confident the SiPM is working as it is responding to the visible light when the scintillator is not attached. Do you have any suggestions on what could have gone wrong? Here are some pictures of the SiPM board and the wrapped scintillator. Thank you!

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

spenceraxani, 2024-11-18:
Hi,

Thanks for the email. I wouldn’t trust that your visible light test means that the SiPM is properly connected. I would first try adding some more tap, to ensure that it’s light tight. Even the smallest pinhole leak will prevent it from working. If that doesn’t solve your problem, it’s likely the SiPM. I could not check the orientation on the board with your images, however, make sure that it’s correctly aligned and rotated.

Best,

Spencer

─
Dr. Spencer N. Axani
***@***.*** ***@***.***>

Assistant Professor
The University of Delaware
203 Sharp Lab
104 The Green, Newark, DE 19716
(608) 572-8426

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

Thread 122 (2024-11-20):

See pulses on all TPs, but screen doesn't update counts

hswhhe-uiuc, 2024-11-20:
Hi, I have a question about the Arduino/screen readouts. I looked at the BNC signal and all the test points on my detector, and I can see reasonable signals from the Oscilloscope. However, the screen counts doesn't update at all, except one fake count at the beginning. I tried to lower the signal threshold from Arduino but it doesn't change anything. Do you have any suggestions? The pictures below are the signal from BNC&TP2, BNC&TP3, and my main board. Thank you so much!

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

spenceraxani, 2024-11-20:
Hi,

I would recommend changing the trigger threshold back to its original value. I think your issue is simply the solder connection on the Arduino. I can see several suspect connections. I would also solder all the pins.

Best,

Spencer

─
Dr. Spencer N. Axani
***@***.*** ***@***.***>

Assistant Professor
The University of Delaware
203 Sharp Lab
104 The Green, Newark, DE 19716
(608) 572-8426

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

hswhhe-uiuc, 2024-11-21:
Hi Spencer,

Thank you so much! It worked after more soldering on Arduino.

Closed 2024-11-21.

Thread 124 (2025-02-15):

Silk screen not made at SiPM pcb during production

dedwid, 2025-02-15:
Hi,
I made an order to Elecrow with [PCB_Gerber_files_wLargerSnapOffConnectors.zip], and they have recently contacted me due to a problem with the silk screen located where the SiPM is soldered. I asked them about it, and they told me this:

“The characters are placed on top of the solder mask, and the software will automatically remove the character layer covered by the solder mask exposed copper during production. So there is no silk screen printing when making according to the file.”

They sent me this pictures as well:

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

Will the circuit work without this silk screen? If not, I thought about sending them the [PCB_Gerber_files.zip] to see if there's any difference.

Thank you for all your work in this project!

Kind Regards,
David

wffinney, 2025-03-04:
I too have had these boards printed, and soldered my SiPM following the location shown for Pin 1 in the image in the instructions.  I do not get the behavior shown in the video where there is a very high or "open" resistance when probed in one direction and a measurable resistance when measured by swapping the leads.  Is this a known behavior with this board?

wffinney, 2025-03-04:
> I too have had these boards printed, and soldered my SiPM following the location shown for Pin 1 in the image in the instructions. I do not get the behavior shown in the video where there is a very high or "open" resistance when probed in one direction and a measurable resistance when measured by swapping the leads. Is this a known behavior with this board?

Oh... I think I answered my own question with the information about the meter setting in issue 81
https://github.com/spenceraxani/CosmicWatch-Desktop-Muon-Detector-v2/issues/81#issuecomment-1118913551

Thread 126 (2025-03-11):

Remove PCB_Gerber_files.zip

agafford-ST, 2025-03-11:
PCB_Gerber_files.zip has tabs that are way too small.  Several vendors have declined making it or want to charge way too much for it.  The one with the proper snap off tabs is much better and there is no reason to keep two versions.  Long story short I had some students send me the bad file and I have spent a week trying to get quotes before I thought to investigate and find the GitHub.  Now I might not be able to get the board made before my students arrive latter this week.

Please remove PCB_Gerber_files.zip and keep just PCB_Gerber_files_wLargerSnapOffConnectors.zip so there is no confusion or issues for people in the future.

Thread 127 (2025-03-14):

Voltage between HV and GND is 0

Evansastro, 2025-03-14:
Hi Spencer,

I ran into a problem where the voltage between HV and gnd is 29.5v but the voltage between HV and SNG is 0, I have tested the other working units that the voltage between them is 29.5. What could be the cause of this problem?

spenceraxani, 2025-03-15:
Hi,

That’s interesting, I’ve never run into that. That would mean that between SNG and GND is also 29.6V, perhaps indicating a short from the SiPM cathode to anode. I’m not sure what the voltage on the SNG would be if the SiPM were mounted backwards. We’re there any problems when mounting the SiPM?

Best,

Spencer

─
Dr. Spencer N. Axani
***@***.*** ***@***.***>

Assistant Professor
The University of Delaware
203 Sharp Lab
104 The Green, Newark, DE 19716
(608) 572-8426

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

Thread 128 (2025-03-27):

please can ypou help me

Diegocastillomorales, 2025-03-27:
Dear Spencer,

Could you please do me a favor and send me the schematic file of the PCB for the SiPM that you designed? I would like to send it for soldering on a fabrication site, as I have damaged several while trying to solder them myself, and only one has worked. It would be a great help for me to continue with the Cosmic Watch project.

Best regards,

Thread 130 (2025-07-21):

I need your opinion please.

evansastro4277, 2025-07-21:
Hi

I'm working on upgrading the cosmicwatch to a modern microcontroller using the arduino nano esp32. The problem is that the adc on the arduino nano esp32 is rated to support maximum 3.9volt and I observed clipping problem when I collected adc data. That means the LT1807 is amplifing the signal to greater than 3.9 volts right? I was thinking, maybe I should reduce the gain of the LT1807 but the problem is that the ADC on the esp32 is sooooo much noisier and if i redice the gain, I fear that the noise would eat up the lower energy pulse. What is your opinion on this?

Thank you,
Evans

Thread 131 (2025-09-02):

Raspberry Pico instead of Arduino

mimmus, 2025-09-02:
Hi,
I have a Cosmic Watch built during a summer school project but it has a Raspberry Pico W instead of an Arduino, like in documentation.
Any idea why?

omasanori, 2025-09-02:
I guess you have [CosmicWatch v3X](https://github.com/spenceraxani/CosmicWatch-Desktop-Muon-Detector-v3X), not v2.

mimmus, 2025-09-02:
Discovered just now!
I'm having issues with CosmicWatch not starting anymore and I'm trying to understand...

Closed 2025-09-02.
