spenceraxani/CosmicWatch-Desktop-Muon-Detector-v2/CAD/Enclosure dimensions.pdf

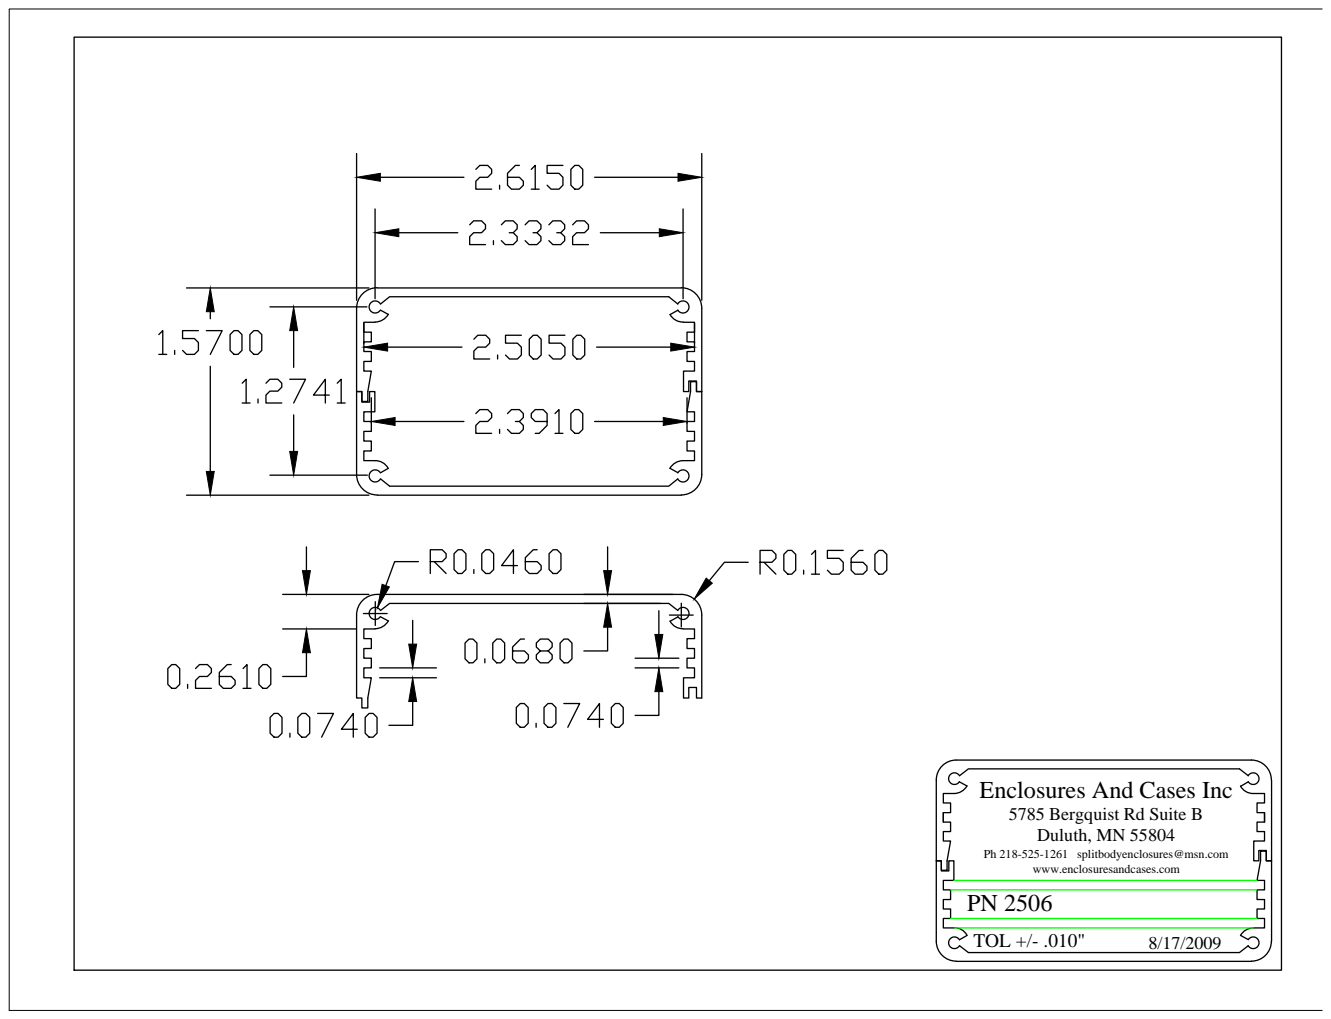
[picture p8: page 1]
Enclosures And Cases Inc 5785 Bergquist Rd Suite B Duluth, MN 55804 Ph 218-525-1261 splitbodyenclosures@msn.com www.enclosuresandcases.com PN 2506 TOL +/- .010"
