spenceraxani/CosmicWatch-Desktop-Muon-Detector-v2/PCB_Files/callibration.pdf

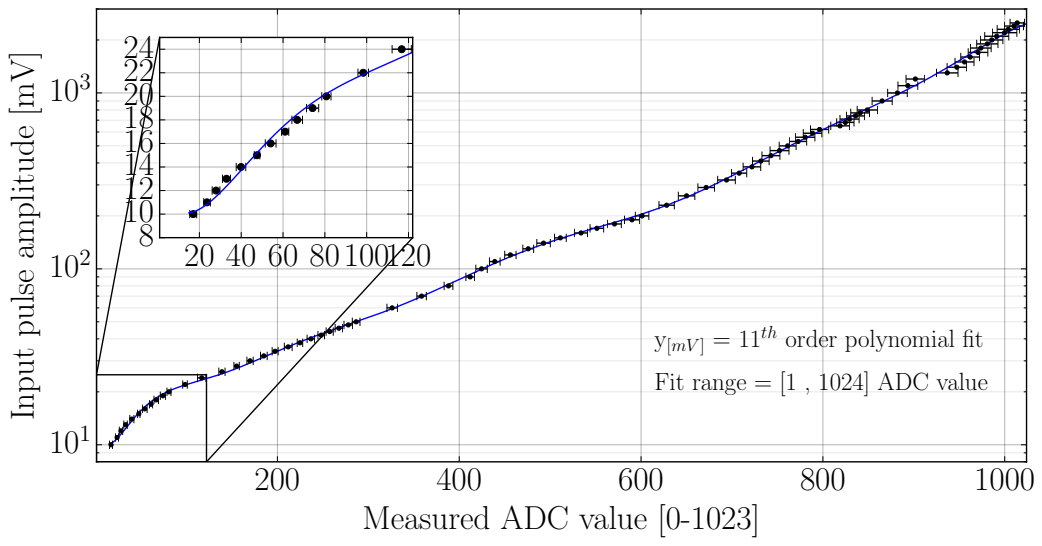
[picture p9: page 1]

Input pulse amplitude [mV]

18
16
12

y[mV ] = 11th order polynomial fit
Fit range = [1 , 1024] ADC value

Measured ADC value [0-1023]
