spenceraxani/CosmicWatch-Desktop-Muon-Detector-v2/Pictures/circuit.pdf

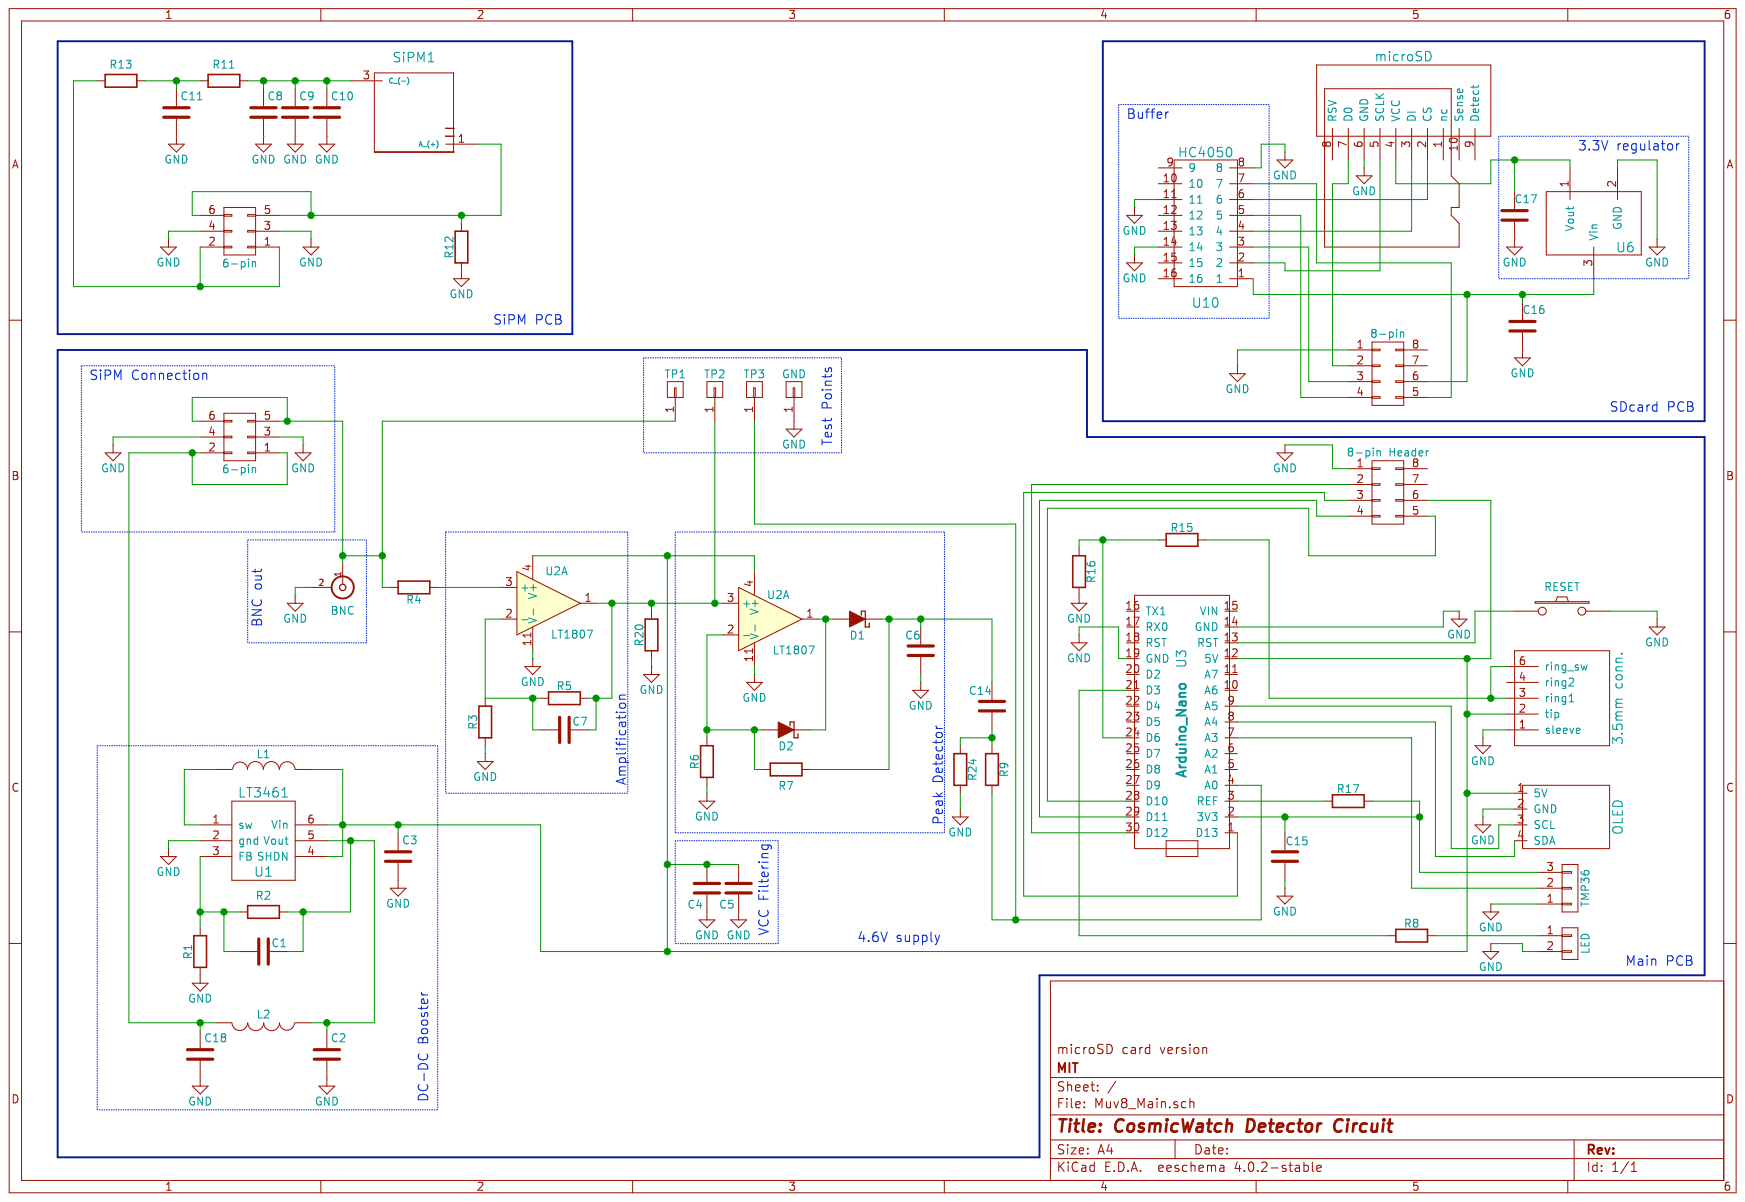
[picture p10: page 1]
