spenceraxani/CosmicWatch-Desktop-Muon-Detector-v2/PCB_Files/circuit.pdf

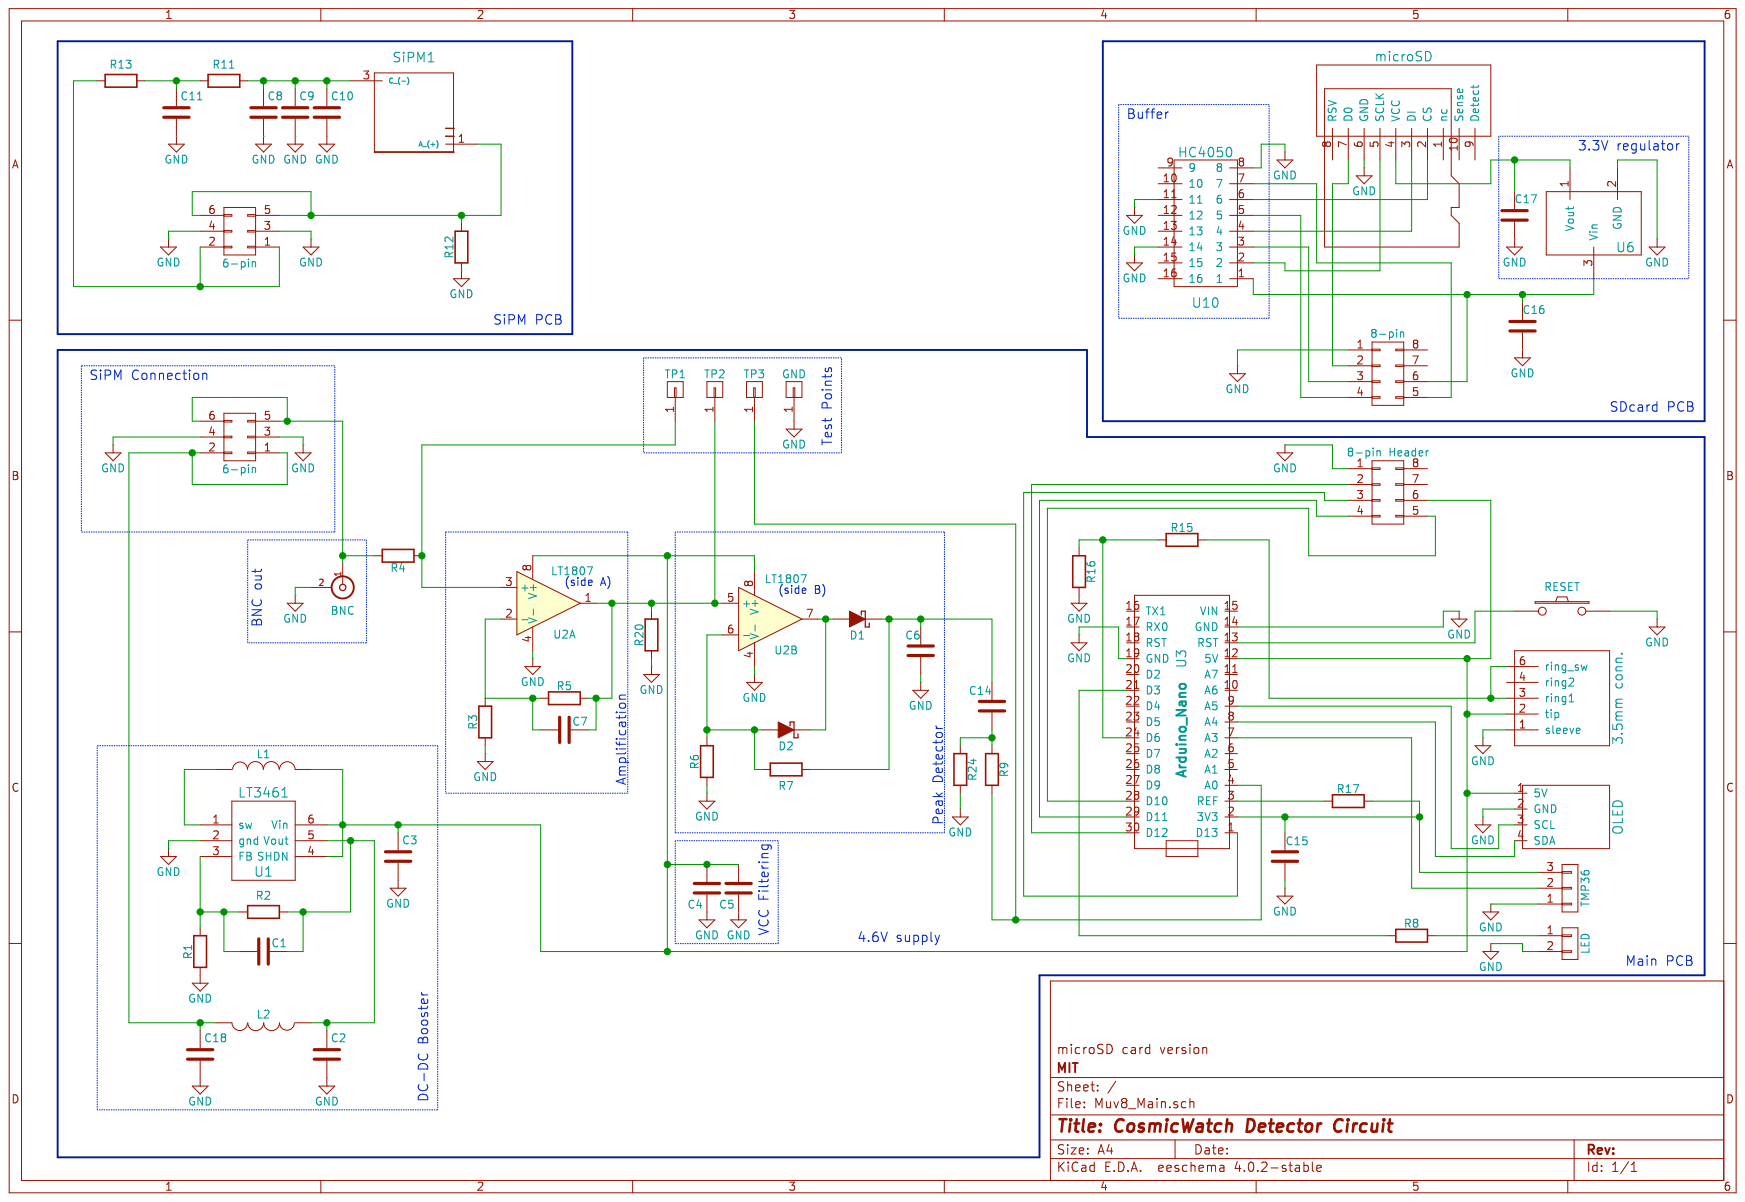
[picture p11: page 1]
