spenceraxani/CosmicWatch-Desktop-Muon-Detector-v2/Enclosure_Files/Enclosure_silkscreen_bottom.pdf

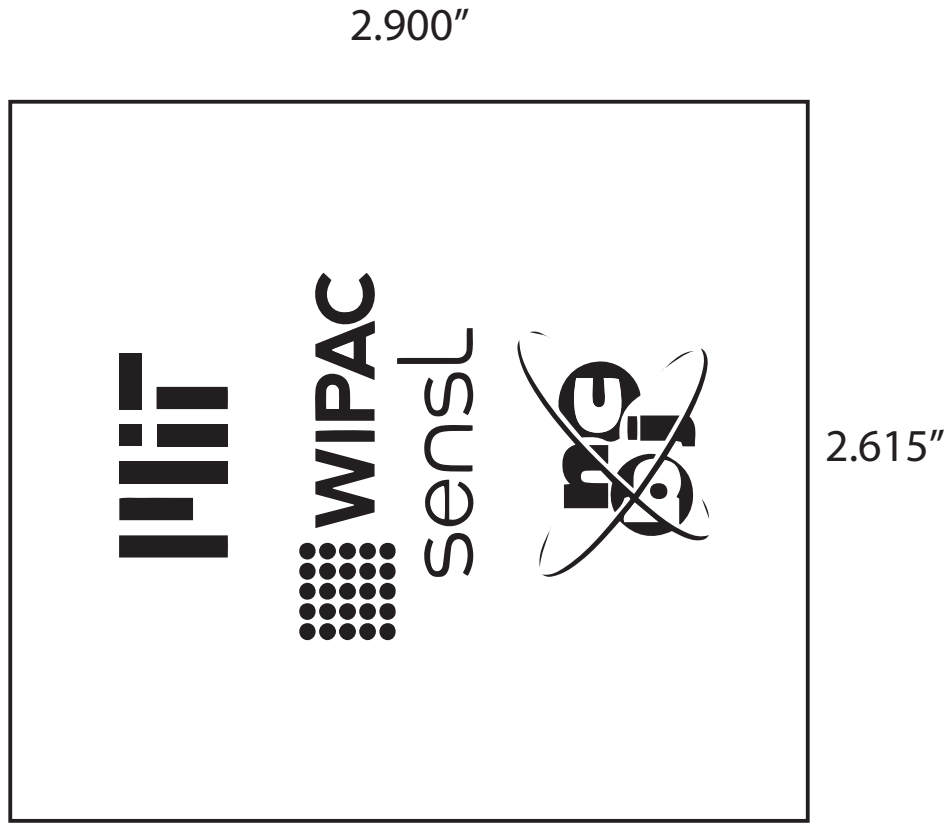
[picture p13: page 1]
