spenceraxani/CosmicWatch-Desktop-Muon-Detector-v2/Enclosure_Files/Enclosure_silkscreen_top.pdf

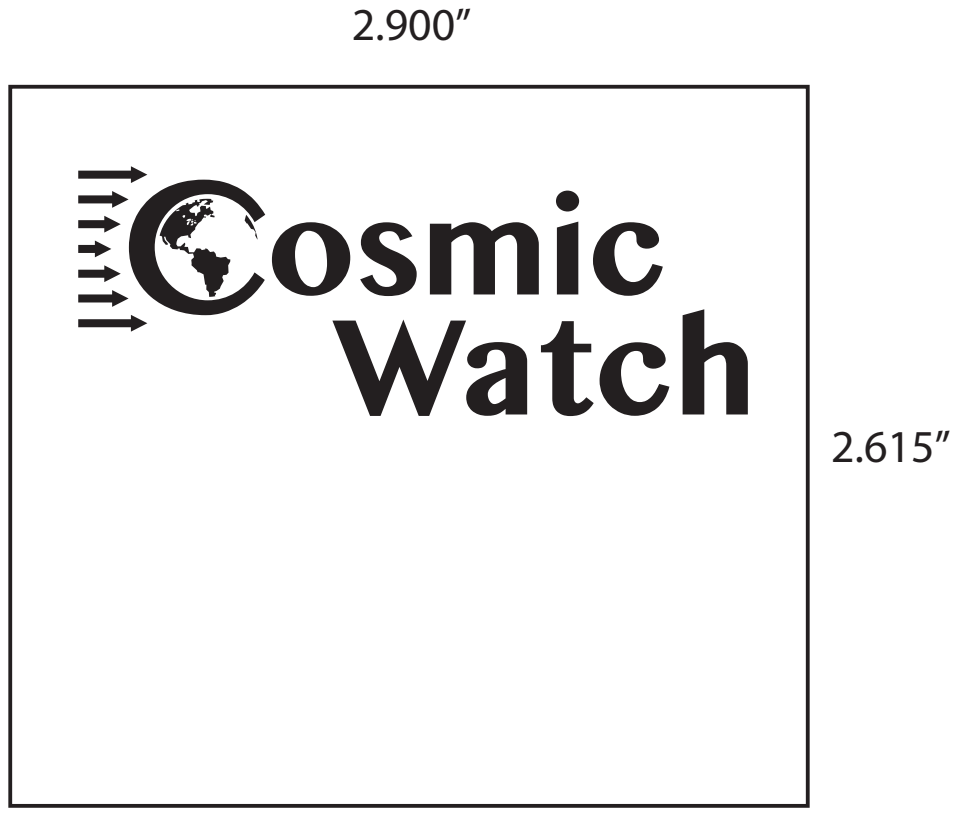
[picture p14: page 1]
