spenceraxani/CosmicWatch-Desktop-Muon-Detector-v2/(commit log)

2018-01-08 Adding new files
    [Purchasing List.xlsx]
2018-01-22 Increase the support leg PCB to 1mm
2018-01-25 fixing item list number
    [Purchasing List.xlsx]
2018-02-14 updated circuit drawing and labelling
2018-02-15 updated instructions with circuit update
2018-02-16 added 10nF cap to purchasing list
    [Purchasing List.xlsx]
2018-03-10 fixed TP1 location on circuit
    [SDCard.ino]
2018-06-21 updating OLED code and standoff requirements
    [Purchasing List.xlsx]
2018-07-17 updating fix for new Tornado version, and header output when no sdcard is inserted.
    [import_data.py]
2018-09-12 Updating OLED info
    [Purchasing List.xlsx]
2020-01-07 Updating the purchasing list
    [Purchasing List.xlsx]
2020-07-20 Fixing Typo
    [Purchasing List.xlsx]
2020-09-15 updating purchasing list
    [Purchasing List.xlsx]
2021-01-18 Adding duplicate PCB file with larger support connectors between PCBs
2021-06-15 adding Gerber with 4mm connectors
2021-09-12 adding Gerber file with larger snapp-off connections for JLCPCB
    [Naming.ino, OLED.ino, SDCard.ino]
2021-12-15 updating PCB to include a reflective plane.
2022-02-23 renaming file without space
    [Purchasing List.xlsx]
2022-02-24 updated purchasing list
    [Purchasing_List.xlsx]
